gwenrich136/farkle-scoreboard/hardware/custom-footprint-references/lcd-display.png

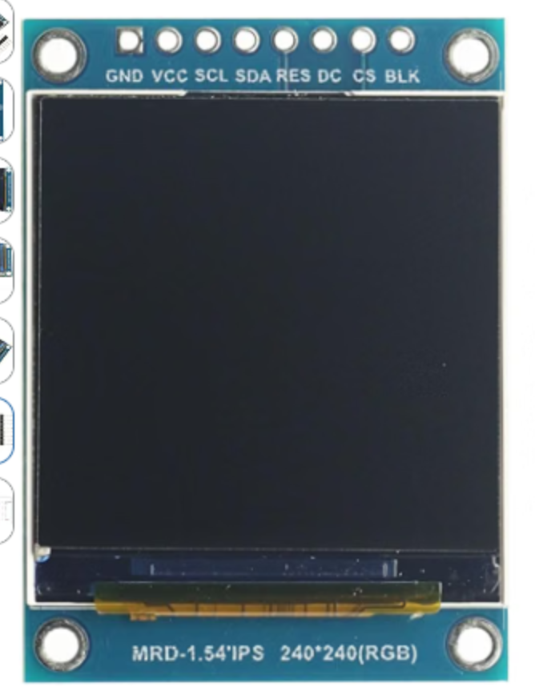
hardware/custom-footprint-references/lcd-display.png
