gwenrich136/farkle-scoreboard/hardware/custom-footprint-references/sd-card-module.png

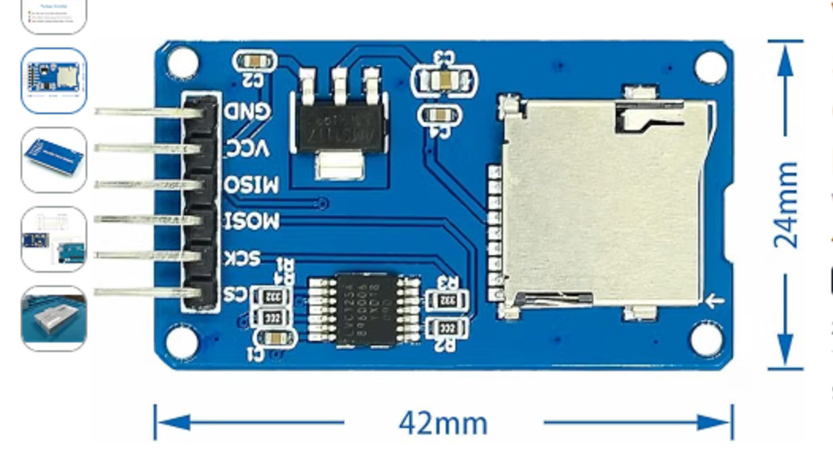
hardware/custom-footprint-references/sd-card-module.png
