gwenrich136/farkle-scoreboard/design/GENERAL_GAME_PLAY.md

> **Scope:** Defines the complete user experience and gameplay flow, from pre-game setup to post-game replays, from a player's perspective.
> **Status:** **LIVE DOCUMENT** - This file represents the current source of truth. If code changes, this document MUST be updated.

# General Gameplay and User Experience Design for Farkle Scoreboard

This document outlines the desired user experience and general gameplay flow for the Farkle Scoreboard device. It focuses on how the game should behave from the player's perspective, without delving into specific technical implementation details.

---

## 1. Pre-Game Experience

The game begins by guiding players through setup and configuration.

### 1.1 Target Score Selection
-   **Initial State:** The scoreboard asks "Target Score?". The default selection is 10,000.
-   **Navigation:** Players rotate the dial (Encoder) to increment or decrement the goal in steps of 1,000. The range is clamped between 1,000 and 20,000.
-   **Visual Feedback:** The `ScoreDisplay` segment for the "Competition Score" updates in real-time to show the currently selected target.
-   **Confirmation:** Pressing `SELECT` (Encoder Push) confirms the target score and transitions to the "Player Selection" screen.

### 1.2 Player Selection
-   **Initial State:** The scoreboard displays a "Player Selection" screen, presenting a list of pre-stored player names.
-   **Goal Persistence:** The "Competition Score" segment remains lit with the chosen target score throughout the selection process.
-   **Navigation:** Players rotate the dial (Encoder) to scroll through the available names. While scrolling, the `LedProgressGrid` visually indicates the "pending player" by blinking the rows that player would occupy with their assigned color.
-   **Selecting a Player:** Pressing the `SELECT` (Encoder Push) button on a highlighted name adds that player to the game. The player list refreshes, removing the selected player from the available list, and the system remains in the "Player Selection" state, ready for the next player.
-   **Player Limit**: Once the maximum number of players is reached (currently 8), the system stops showing a "pending" player and the ability to add more is disabled.

### 1.2 Player Creation
-   **Purpose:** Allows users to input a new player name character by character.
-   **Input Method:** The screen (via `TextDisplay`) shows the name being built. The active character is highlighted and can be changed by rotating the dial (Encoder). Players navigate through the name by pressing `+100` (Left) or `+500` (Right).
-   **Confirmation:** Pressing `BANK` confirms the new name, adds the player to the game, and returns to the "Player Selection" screen.
-   **Aborting:** Pressing `CLEAR` discards the new name and returns to the "Player Selection" screen without adding a player.

### 1.3 Starting the Game
-   **Direct Start:** From the "Player Selection" screen, pressing the `FARKLE` (Red) button immediately starts the game with the currently added players.
-   **Confirmation Flow:** From the "Player Selection" screen, pressing the `CLEAR` button initiates a confirmation step.
    -   The `TextDisplay` asks: "Start {player_count} player game?".
    -   Pressing `FARKLE` or `BANK` starts the game.
    -   Pressing `CLEAR` again cancels and returns to the "Player Selection" screen.

---

## 2. In-Game Experience

### 2.1 Player Turn Flow
-   **Turn Start:** The `TextDisplay` clearly indicates whose turn it is (e.g., "PLAYER 1'S TURN").
-   **Dice Rolling:** Players roll physical dice.
-   **Score Input:**
    -   Players use the dedicated buttons on the `ControlPad` to add points to their `at-risk` score. These buttons map to common Farkle score increments:
        -   `+50` button
        -   `+100` button
        -   `+500` button
    -   The `atRisk` score is displayed on a `ScoreDisplay` segment and as a blinking section on the `LedProgressGrid`.
    -   **Toggle View:** A physical latching switch on the device allows the current player to toggle their main score display between "Banked" (showing only their banked score) and "Pending" (showing their banked score + their current atRisk score). This allows players to easily see what their final score would be if they were to bank immediately, and it changes how the display updates during animations.
    -   **Visual Feedback Rule:** If the `atRiskScore` is 0, it is only displayed as "0" on the `ScoreDisplay` during the `WaitingPhase`. In all other phases (such as during animations in the `BankingPhase` or `FarklingPhase`), an `atRiskScore` of 0 is treated as an empty display. This helps visually distinguish between an active turn and the transition between turns.
    -   **Correction:** Pressing `CLEAR` resets the `atRisk` score to 0 for the current roll, allowing the player to re-enter their score.
    -   **Ghost Undo:** To save space and complexity, the scoreboard uses a "Ghost Undo" button. Pressing `BANK` and `CLEAR` simultaneously issues an `UNDO` command. Because both `BANK` and `CLEAR` are inert when the turn score is 0, this mapping works perfectly, allowing for a secret button combination to undo actions without adding a physical button. This action is currently defined but reserved for future implementation.

### 2.2 Score Animations
-   **Banking Animation:**
    -   When a player presses `BANK`, their `atRisk` score slowly drains to zero while their banked score simultaneously increases by the same amount. Both the `ScoreDisplay` segments and the `LedProgressGrid` animate this proportional change, with the `atRisk` portion shrinking and the banked portion growing.
    - The player's consecutive farkle count is also reset to zero at the beginning of this phase, causing the `FarkleWarningLights` to turn off immediately.
    -   **Note on Visuals:** The `LedProgressGrid` uses a logarithmic/exponential brightness curve for the "remainder" pixel. This ensures that the visual progression appears smooth and linear to the human eye, avoiding sudden jumps in brightness during these animations.
    -   Input is locked during this animation.
    -   **Manual Advance:** Once the animation completes (at-risk score is 0), the game persists in its final state, showing the updated score. The game waits until **any button** is pressed on the `ControlPad`, or automatically advances after 5 seconds of inactivity.
    -   **Transition:** Upon button press or timeout, the game advances to the next player's turn and returns to the `WaitingPhase`.
-   **Standard Farkle Animation:**
    -   If a player farkles (but it's not their third consecutive farkle), their `atRisk` score slowly drains to zero.
    -   **No Harm, No Foul Rule:** If the player's Banked Score is 0, their consecutive farkle count does **not** increment. Warning lights do not turn on. You cannot get "strikes" if you have no points to lose.
    -   A witty quip related to farkling is displayed on the `TextDisplay`.
    -   The `FarkleWarningLights` update to reflect the new farkle count (if applicable).
    -   Input is locked during this animation.
    -   **Manual Advance:** Once the animation completes, the game remains in this state (displaying the quip and updated lights) and waits for **any button** press or automatically advances after 5 seconds of inactivity.
    -   **Transition:** Upon button press or timeout, the game advances to the next player's turn and returns to the `WaitingPhase`.

### 2.3 Catastrophic Farkle (Third Consecutive Farkle)
-   **Trigger:** When a player gets their third consecutive farkle in a turn (and has points to lose).
-   **Penalty:** A player who gets a third consecutive farkle loses 1,000 points, or their entire score if it's less than 1,000.
-   **Dramatic Animation Sequence:**
    1.  **"The Pain Sets In" (approx 5 seconds):**
        *   The `TextDisplay` shows a penalty quip.
        *   The `atRisk` score display flashes the negative penalty amount (e.g., "-1000" or "-850").
        *   The `FarkleWarningLights` begin **alternating** (Yellow/Red) to signal the catastrophe.
        *   No points move yet; the user is forced to dwell on their mistake.
    2.  **The Drain:**
        *   The `atRisk` display stops flashing (becomes solid).
        *   The `atRisk` score animates upwards to 0.
        *   Simultaneously, the player's banked score drains downwards.
        *   The `FarkleWarningLights` **continue alternating** throughout this drain.
    3.  **The Aftermath:**
        *   Once the scores settle, the `FarkleWarningLights` turn **OFF**.
        *   The game waits for a button press or automatically advances after 5 seconds of inactivity.
    -   **Reset Logic:** The player's consecutive farkle count is internally reset to 0 immediately upon entering this phase, consistent with other phases. The lights alternate purely due to the phase state.

---

## 3. End-Game Experience

### 3.1 The "Last Round" Trigger
-   **Trigger Condition:** The first time any player's banked score exceeds **the Target Score**.
-   **Visual & Audio Cue:**
    -   The `ScoreDisplay` segment showing the Competition Score (leading score) begins to blink continuously.
    -   A "bell sound" plays (future implementation) to signify the final round.
-   **Game Rule:** The game does not end immediately; every other player (including the one who just crossed 10,000) gets one final turn to surpass the highest score.

### 3.2 Game End & Winner Celebration
-   **Game End:** The game concludes after all players have had their final turn. The player with the highest score is declared the winner.
-   **Celebration Sequence:**
    -   The `TextDisplay` prominently displays "{player_name} WINS!".
    -   The entire `LedProgressGrid` performs a dynamic visual celebration (e.g., flashing in the winner's color, or a "fireworks" animation).
    -   The `ScoreDisplay` segment showing the winning score flashes the winning player's final total.

---

## 4. Post-Game Experience

After the winner celebration, the device enters a continuous post-game loop.

### 4.1 Game Replay & Upload (Parallel)
-   **Visual Replay:** The `LedProgressGrid` continuously replays the game's progress, showing how each player's score advanced throughout the session.
-   **Data Upload (Background/Interactive):** Simultaneously, the scoreboard attempts to connect via Bluetooth or WiFi to a paired phone.
    -   The `TextDisplay` provides status updates (e.g., "CONNECTING...", "UPLOADING...").
    -   If the upload is successful, the `TextDisplay` indicates this.
    -   If the connection or upload fails, the `TextDisplay` presents a menu of options.

### 4.2 Post-Game Menu
-   **Access:** If the upload fails or the user wishes to perform another action, a menu is presented (using the `displaySelector` UI from pre-game).
-   **Options:** The menu includes, but is not limited to:
    1.  "Retry Upload": Re-attempts the data upload.
    2.  "Play Again": Leads to a "Reset Game?" confirmation.
-   **Navigation:** Users navigate this menu using `Up/Down` and select options with `BANK`.
-   **`LedProgressGrid` Behavior:** The `LedProgressGrid` continues its game replay animation independently while the user interacts with the `TextDisplay` menu.

### 4.3 Reset Game
-   **Confirmation:** Selecting "Play Again" or triggering a reset (e.g., via `CLEAR` from a specific context) leads to a "Reset Game?" confirmation screen.
-   **Action:** Confirming the reset returns the device to the initial "Target Score Selection" state.
