gwenrich136/farkle-scoreboard/design/HARDWARE_UPGRADE_MIGRATION_PLAN.md

# Hardware Upgrade Migration Plan

> **Scope:** Roadmap for the V1 to V2 hardware transition, featuring the ST7789 Color IPS Display and a Hybrid Input Architecture.
> **Status:** **LIVE STRATEGY** - Step 5 is DONE. Step 6 is the active target.

---

## 1. The Vision: Hardware v2 Experience

The V2 upgrade transforms the Farkle Scoreboard into a premium, color-coded interactive device.

### 1.1 The IPS Color Display (ST7789)
A 240x240 RGB IPS display replaces the monochrome OLED.
*   **Color-Coded Feedback:** Player names, turn indicators, and "at-risk" scores are rendered in the player's unique Golden Ratio hue.
*   **High-Speed SPI:** Utilizing the Uno R4's hardware SPI bus for zero-latency UI updates.

### 1.2 The "Competitor Preview" Window
The **Rotary Encoder** (infinite) allows players to cycle through competitors on the `COMPETITION_SCORE` display.
*   **Smart Selection:** Defaults to the Leader or the 2nd Place Player at the start of a turn.
*   **Press-and-Turn:** The encoder button remains digital for 100% reliability during concurrent scrolling actions.

### 1.3 Strategic Farkle Tracking (Status Strip)
The **8-LED NeoPixel Strip** provides a "Danger Map" of the table.
*   **Current Player (Flashing):** White (0), Yellow (1), Red (2+).
*   **Other Players (Solid-Dim):** Off (0), Yellow (1), Red (2+).

---

## 2. The Target State: Pin Map

To accommodate the increased pin cost of the SPI LCD while preserving hardware encapsulation, we employ a "3-Bit Digital Bus" model.

| Pin | Component | Function | Status |
| :--- | :--- | :--- | :--- |
| **D0/D1** | **MP3 Player** | **Serial1** (Hardware Audio) | Pending |
| **D2/D3** | **Encoder A/B** | **Interrupts 0/1** (Smooth Scroll) | **DONE (V2)** |
| **D4** | **Encoder SW** | **Digital Input** (SELECT Button) | **DONE (V2)** |
| **D5** | **BUS BIT 2** | **Digital Input** (3-Bit Bus) | **DONE (V2)** |
| **D6** | **BUS BIT 1** | **Digital Input** (3-Bit Bus) | **DONE (V2)** |
| **D7** | **LCD RES** | Hardware Reset for LCD | **DONE (V2)** |
| **D8** | **LCD BLK** | PWM Backlight Control | **DONE (V2)** |
| **D9** | **SD Card CS** | SPI Chip Select (Data) | Pending |
| **D10** | **MAX7219 CS** | SPI Chip Select (Displays) | **Active (V1)** |
| **D11** | **SPI COPI** | Shared Data Out (MOSI) | **Active (V1)** |
| **D12** | **SPI CIPO** | Shared Data In (MISO) | **Active (V1)** |
| **D13** | **SPI SCK** | Shared SPI Clock | **Active (V1)** |
| **A0** | **LED Grid** | NeoPixel Data (8x8) | **Active (V1)** |
| **A1** | **Status Strip** | NeoPixel Data (8-LED) | **DONE (V2)** |
| **A2** | **BUS BIT 0** | **Digital Input** (3-Bit Bus) | **DONE (V2)** |
| **A3** | **Latching Switch** | **"Total Score" Toggle** | **DONE (V2)** |
| **A4** | **LCD CS** | SPI Chip Select (LCD) | **DONE (V2)** |
| **A5** | **LCD DC** | Data/Command (LCD) | **DONE (V2)** |

---

## 3. Rationale & Trade-off Analysis

### 3.1 Why the 3-Bit Digital Bus?
*   **Constraint:** The ST7789 IPS display requires 4 dedicated pins (CS, DC, RES, BLK) beyond the SPI bus.
*   **Alternative Considered:** **Hybrid Resistor Ladder.** Rejected because the analog input proved too finicky and unreliable with the noisy power signal (even with capacitors) when trying to consolidate to a single power source.
*   **Decision:** Move to a 3-Bit Binary Digital Bus (D5, D6, A2 used as digital). This completely resolves the analog noise issues while providing 7 distinct button states, easily covering our 6 physical buttons and introducing the "Ghost Undo" capability without requiring another physical pin or button.

### 3.2 Handling Noise
*   **Challenge:** Large NeoPixel current spikes create high-frequency noise that disrupted the analog rail.
*   **Solution:** By converting the analog A2 to a pure digital input and using a digital binary bus, we inherently increase resistance to signal noise. The software implements standard digital debouncing on the combined 3-bit value.

---

## 4. Migration Steps (The "Safe Point" Approach)

### **Phase 1: Input & Display Foundation**
**Step 1: The Status Strip (A1) [DONE]**

**Step 2: The Hybrid Input Refactor [DONE] [DEFUNCT]**
*   **Note:** Since implementing the analog resistor ladder as initially planned, we have moved on to a purely digital binary encoding scheme (3-Bit Digital Bus) to eliminate finicky analog power noise. The steps below are retained for historical context.
*   **Hardware:** Build the 4-button resistor ladder on **A2** (+50, +100, +500, CLEAR). Move **BANK**, **FARKLE**, and **SELECT** (Encoder Push) to their target digital pins.
*   **Software (ControlPad):** Implement **Interrupt-Safe Encoder** rotation logic and **Analog Ladder** stability (50ms window).
*   **Software (Architecture):** Refactor the system to use the encapsulated `GameInput` struct (ButtonAction + rotationDelta) and update all `GamePhase::update()` signatures.
*   **Software (Navigation):** Migrate menu scrolling (Target Score, Player Selection) to use the Encoder.
*   **Verification:** Native tests for priority logic, stability windows, and "no-repeat" ladder logic.

**Step 3: The IPS Color Upgrade (ST7789) [DONE]**
*   **Hardware:** Connect ST7789 to SPI and Control Pins (A4, A5, D7, D8).
*   **Software:** Swap `U8G2` for `Adafruit_ST7789`. Update UI for 240x240 and color-coded text.
*   **Verification:** High-speed, color-accurate UI updates.

### **Phase 2: Navigation & Logic**
**Step 4: Strategic Navigation (Encoder A/B) [DONE]**
*   **Hardware:** Connect Encoder pulses to D2/D3.
*   **Software:** Implement `encoder.getDelta()` for Competitor Preview and menu scrolling.

**Step 5: The "Total Score" Toggle (A3) [DONE]**
*   **Software:** Implement the latching switch logic to swap between Banked and Total scores.

### **Phase 3: Persistence & Audio**
**Step 6: SD Card Storage (D9)**
*   **Hardware Requirement:** The SD Card module **MUST** natively support 5V operation. Because the Arduino Uno R4 WiFi uses 5V logic for its SPI bus, utilizing a bare 3.3V SD module will cause damage or data corruption. Ensure the module has a built-in logic level shifter.

**Step 7: MP3 Audio (D0/D1)**

---

## 5. Rollout Strategy
1.  **Iterative Updates:** `SCHEMATIC_AND_HARDWARE_GUIDE.md` updated after each step.
2.  **Safe Points:** No transition begins until the current hardware is playable and passing tests.
