gwenrich136/farkle-scoreboard/design/pcb-design/MODULAR_PCB_PROPOSAL.md

> **Scope:** Proposed set of custom PCBs, the off-the-shelf modules they host, the board-to-board interconnect, the power architecture, the certification strategy (certified PSU + pre-certified radio), and the enclosure interface for the Farkle Scoreboard.
> **Status:** **ADOPTED (SINGLE-BOARD VARIANT, SESSION 5)** - All open questions Q1–Q10 answered by Guillermo on 2026-11-01 (see §11 and `SESSION_LOG.md` Session 5). Guillermo selected the **Single Unified Main PCB** architecture (Option 1 in §10) with 72 onboard SMD `WS2812B` LEDs (in a KiCad hierarchical sheet), reusing the Uno R4 WiFi, 3× MAX7219 5-digit modules, 8-pin CS-capable ST7789 LCD, 5V microSD adapter, and DFPlayer Mini, while keeping the active protection/level-shifting ICs (`TPS2595` eFuse, `AP2112K-3.3` + `74LVC245A` LCD shifter, and `74AHCT244` 5V buffer).

# Modular & Unified PCB Architecture Proposal

## 0. TL;DR

*   **Session 5 Decision (Unified Main PCB):** Rather than splitting into 3 separate boards connected by cables, the build consolidates onto **one Single Unified Main PCB** mounted behind the front panel:
    *   **Front side:** 72 SMD `WS2812B` LEDs (64 in the 8x8 grid + 8 in the status strip, captured in a KiCad hierarchical sub-sheet), 6 PCB-mounted tactile buttons, PCB-mounted rotary encoder + latching switch, 8-pin ST7789 LCD header (`TD1`, with `CS`), and chain headers for the 3× off-the-shelf 5-digit MAX7219 score modules.
    *   **Back side:** Plug-in headers for the **Arduino Uno R4 WiFi**, **5V microSD adapter (`MC_A1`)**, and **DFPlayer Mini (`MP3-TF-16P`)**, plus SMD protection and level-shifting circuitry (`TPS2595` eFuse, `AP2112K-3.3` + `74LVC245A` LCD 3.3V shifter, `74AHCT244` 5V buffer, `1kΩ/2kΩ` DFPlayer RX divider, and 7 steering diodes).
    *   **Panel connections:** 2-pin USB-C power entry (`J_PWR`), 2-pin power rocker switch (`J_SW`), DPDT audio mute switch (`SW_MUTE`), and 2-pin speaker header (`J_SPK`).
*   *(Historical Session 1–4 Modular Proposal preserved below for reference: three custom boards `PWR`, `CORE-A`, and `PAD`.)*
*   **Phase A** keeps the Uno R4 WiFi and **today's pin map**, so firmware is unchanged.
*   **Certification boundary:** no mains, no battery design, and no radio design inside the product. Portability comes from a certified power bank docked in the enclosure (§6.1 Option A). Power comes from a UL/CE-listed USB-C adapter or certified power bank. The only radio is the Uno R4 WiFi's pre-certified module.

---

## 1. Design Principles

1.  **Stay inside the certified boundary.** Anything that is expensive to certify (AC/DC conversion, lithium cells, RF front-ends) is bought as a finished, certified product and never designed by us. See §7.
2.  **Firmware pin map is frozen in Phase A.** Every custom board is designed so the existing `ControlPad`, `ScoreDisplay`, `TextDisplayV2`, `MemoryCard`, `SoundPlayer`, `LedProgressGrid`, and `FarkleWarningLights` code runs unmodified.
3.  **Connectors are the contract.** Each board-to-board connector has one pinout, defined in §5, and it never changes between phases. That is what makes the system modular.
4.  **Repeat, don't vary.** The three score displays are one PCB design built three times and daisy-chained.
5.  **Separate the high-current LED path from logic** on every board: dedicated pours and a star point at the power input (fixes F3).
6.  **Hand-solderable or JLCPCB-assemblable.** 2-layer where possible, 0603/0805 passives, SOIC/SOT packages, no BGAs.
7.  **BOM before layout.** Every part is chosen from the fab's catalog (LCSC code, package, stock) before schematic capture, because the part sets the footprint. See `VIBE_CODING_PCB_PITFALLS.md` §1 and the A0 gate in §9.

---

## 2. Board Set

| ID | Board | Type | Contents | Layers | Est. size | Qty/unit |
|:--|:--|:--|:--|:--|:--|:--|
| **PWR** | Power entry | Custom | USB-C sink, TVS, eFuse (current limit + soft-start), power-switch input, power-good LED | 2 | ~35×25 mm | 1 |
| **CORE-A** | Compute carrier (Phase A) | Custom | Uno R4 WiFi shield: rail distribution, 3V3 LDO, level translation, LCD clock gate, microSD socket, DFPlayer socket, LED data buffers, all peripheral connectors | 2 (4 optional) | Uno footprint, ~70×55 mm | 1 |
| **SEG** | Score display | **Reuse modules** (custom optional) | MAX7221 (or MAX7219) + 5× 7-segment digits, R_SET, decoupling, IN/OUT chain connectors | 2 | ~105×35 mm for 0.56" digits | **3** |
| **PAD** | Gamepad / control pad | Custom | 6 buttons, EC11 encoder + push, latching switch, steering diodes, ESD | 2 | Set by button layout | 1 |
| GRID | 8x8 LED panel | **Buy** | WS2812B 8x8 panel (rigid PCB type) | – | 65×65 mm typ. | 1 |
| STRIP | Status strip | **Buy** | 8× WS2812B stick | – | – | 1 |
| LCD | 240x240 IPS | **Buy** | ST7789 module **with a CS pin** (fixes F1) | – | – | 1 |
| AUD | MP3 player | **Buy** | DFPlayer Mini, socketed on CORE | – | – | 1 |
| *CORE-B* | *Compute (Phase B)* | *Custom* | *ESP32-S3-WROOM-1 module-down, same connectors as CORE-A* | *4* | *~70×55 mm* | *1* |

**Why not one board?** See §10. In short: the front-panel layout isn't frozen yet. Separate boards let the enclosure move a display without re-spinning everything, and the LED current stays physically away from the logic.

---

## 3. System Topology

```mermaid
graph LR
    ADP["UL/CE USB-C adapter<br/>or certified power bank"] -- "USB-C cable" --> PWR

    subgraph Enclosure
        PWR["PWR<br/>USB-C, TVS, eFuse"]
        SWP["Power switch<br/>(panel)"] -. "EN (µA)" .-> PWR
        PWR == "J1: 5V 3A" ==> CORE

        subgraph CORE["CORE-A (Uno R4 WiFi shield)"]
            R4["Uno R4 WiFi<br/>(pre-certified radio)"]
            SDS["microSD"]
            DFP["DFPlayer"]
        end

        CORE -- "J2: SPI 5V" --> SEG1["SEG #1"] -- "chain" --> SEG2["SEG #2"] -- "chain" --> SEG3["SEG #3"]
        CORE -- "J3: SPI 3V3" --> LCD["LCD module"]
        CORE == "J4: 5V_LED + data" ==> GRID["8x8 grid"]
        CORE -- "J5: 5V_LED + data" --> STRIP["Status strip"]
        PAD["PAD"] -- "J6: 8 signals" --> CORE
        CORE -- "J7: BTL audio" --> MUTE["DPDT mute (panel)"] --> SPK["Speaker"]
    end
```

`==>` marks a high-current path.

---

## 4. Board Details

### 4.1 PWR: Power Entry
*   **Connector:** USB-C receptacle, power-only (6-pin power-only types are fine in Phase A). **5.1 kΩ Rd on CC1 and CC2, each separate** (never shared).
*   **Protection:** unidirectional 5V TVS on VBUS (e.g. SMBJ5.0A class) right at the connector.
*   **eFuse:** an integrated eFuse (candidate: TI TPS2595 / TPS25947 family) set **below the source's rating, not at it** (R4): ~2.2 A for the current Xiaomi USB-A bank (banks of this class are typically rated 5.1 V/2.4 A, so check its label), ~2.7 A for a 3 A USB-C adapter or PD bank. One resistor change. If the limit sat *above* the source's rating, the bank's own protection would trip first and the eFuse would never do its job. It provides:
    *   Current limit (F2): a firmware bug can't trip the power bank or brown out the MCU.
    *   Soft-start (F7): the downstream bulk capacitance no longer slams the source. Size the dV/dt capacitor so the ~1.3 mF downstream (PWR bulk + CORE's 1000 µF) charges at under ~1 A: a rise of ≥ 6 ms (R5).
    *   **EN pin driven by the panel power switch** (F9): the switch only carries µA, so a small illuminated or latching switch works. On PWR: EN pulled **down** with 100 kΩ (off by default), the switch closes EN to a 10 kΩ pull-up from VBUS, with 1 kΩ series + 10 nF at the EN pin and a TVS on the J8 line (R9). A short across J8 turns the unit on, which is the harmless failure.
    *   Keeping input power ≤15 W helps the product stay in the lowest power-source class under IEC 62368-1 (§7.3).
*   **Bulk:** 100–220 µF after the eFuse. The large reservoir moves to CORE next to the LED connectors.
*   **Output:** J1 (§5). Power-good LED.
*   **Optional dual-input variant (PWR-2):** a bank inlet plus a wall inlet with a priority power mux. See §6.1 Option B.
*   **Why a separate board:** the USB-C port has to sit at an enclosure wall the enclosure chooses. This keeps the ESD and hot-plug event at that wall, it's tiny and cheap, and it's the board most likely to change if the power source changes.

### 4.2 CORE-A: Compute Carrier (Uno R4 WiFi shield)
The R4 plugs into CORE-A through standard Uno headers. CORE-A does all the electrical cleanup, and **pin assignments are identical to `SCHEMATIC_AND_HARDWARE_GUIDE.md`**.

| Block | Implementation | Fixes |
|:--|:--|:--|
| **Power distribution** | J1 in → star point → (a) **5V_LED** pour to J4/J5 with **1000µF + 100nF** at the connectors; (b) **5V_SYS** to the R4 5V pin, SEG, and DFPlayer. The DFPlayer gets its own **ferrite + 100µF** branch. | F3, F11 |
| **3V3 rail** | Own LDO (e.g. AP2112K-3.3, 600mA) from 5V_SYS for LCD + microSD. Doesn't rely on the R4's 3V3 pin budget. | F6 |
| **LCD level shift + CS** | 74LVC245A powered at 3.3V (5V-tolerant inputs) translates SCK, MOSI, CS (A4), DC (A5), RES (D7), BLK (D8) down to 3.3V. With a **CS-capable LCD**, A4 drives CS directly. If the chosen LCD has *no* CS, a 74LVC1G125 gates the LCD's SCK using A4 as enable (DNP option), so it only sees its own traffic. | F1, F6 |
| **microSD** | Socket on CORE at a board edge (aligned to an enclosure slot if users swap cards). Down-shift via 74LVC125A @3.3V. **MISO up-shift + tri-state** via 74AHCT1G125 @5V, enabled by SD CS (D9), which also stops the card holding MISO when deselected. Replaces the 5V SD breakout. | Robust shared bus |
| **5V bus buffer** | One **74AHCT244** (8 channels, TTL-threshold inputs) @5V: MOSI/SCK/CS(D10) → J2 with 33 Ω series; A0 → J4 and A1 → J5 with 330 Ω series at the connector; **DFPlayer TX → D0** so the 3.3 V UART reply is a clean 5 V at the RA4M1 (whose CMOS V_IH is 0.8×VCC = 4.0 V; a bare 3.3 V signal is below spec). Six of eight channels used; two spare. TTL thresholds mean the same part accepts 3.3 V input in Phase B unchanged. (R2, R10) | F10, Phase-B ready |
| **Gamepad input** | Per J6 line, in this order from the connector inward: TVS to GND at the connector pin (two 4-channel arrays, e.g. TPD4E05U06), **10 kΩ pull-up to 5V at the connector node**, then **1 kΩ series toward the MCU pin**, then **10 nF to GND at the MCU side**. The order matters (R3): with the pull-up on the MCU side of the series resistor, a pressed line only reaches ≈0.73 V (Schottky Vf + the 1k/10k divider) against the RA4M1's V_IL of 1.0 V; with it at the connector node the pressed line sits at the diode's 0.3 V. | Noise, ESD |
| **Audio** | DFPlayer in a socket. R4 TX (D1) → DFPlayer RX through a **1 kΩ / 2 kΩ divider to 3.3 V** instead of the bare 1 kΩ series resistor, which relies on the module's input clamp (R10). DFPlayer TX → D0 via the '244 above. BTL outputs to J7. | – |
| **Back-feed guard** | Verify the R4 WiFi USB/5V-pin power path from the Arduino schematic (F8). Bench check: with the R4 unpowered, DMM in diode mode between the USB VBUS pin and the 5V header pin; a drop one way and open the other means a series diode and the PC port is safe. If it reads near 0 Ω, add an ideal-diode (or Schottky) stage on CORE so the PC USB port and PWR can't back-feed each other while programming. | F8 |
| **A4/A5 caveat** | A4/A5 are also `Wire`'s SDA/SCL on the Uno R4. Any library that calls `Wire.begin()` (RTC, sensor, the Qwiic port is on `Wire1`, so it's safe) hijacks LCD CS/DC. Guard in firmware: no `Wire` on Phase A hardware (R8). | – |

### 4.3 SEG: Score Display (×3, identical)
**Phase A: reuse what's built.** The build photo shows three off-the-shelf 5-digit MAX7219 modules that already have chain in/out headers. Mount them to the front panel and connect with J2 cables (PH-6 at CORE, 5-pin Dupont at the module; confirm the order on the module silkscreen). Build the custom SEG below only if the digit size or colour changes, or to get the MAX7221 benefits. *Note:* the digits look blue/white. Those LEDs need ~3 V forward voltage, which leaves the MAX7219 little headroom on a 5 V rail, so if brightness looks uneven between digits, that's the likely cause.

**Custom SEG (optional):**
*   **Driver:** prefer **MAX7221** over MAX7219. It's register-compatible (`ScoreDisplay` doesn't change). It has a **true SPI CS**, so it ignores LCD/SD traffic, and **slew-limited segment drivers**, which make EMC easier (§7.4). Note: many cheap MAX7219 boards use clone chips, so buy from an authorized distributor.
*   **Digits:** 5× common-cathode 7-segment digits (0.56" or 0.8" per the enclosure). R_SET chosen for the brightness wanted at intensity 12/15, not maximum, which keeps current near the typical budget.
*   **Decoupling:** 10µF electrolytic/ceramic + 100nF at V+ per chip, per the MAX7219/7221 datasheet layout guidance.
*   **Chain:** `SEG_IN` (from CORE or the previous SEG) and `SEG_OUT` (DOUT → next DIN, plus CLK/CS/5V/GND pass-through) use the **same pinout**, so the boards chain in any order. Device index = position in the chain (matches `addDisplay(type, deviceIndex)`).

### 4.4 PAD: Gamepad / Control Pad
*   **Phase A (no firmware change):** keep the 3-bit bus, done properly on the PCB:
    *   **Steering diodes** (Schottky, e.g. BAT54 series; low Vf keeps a "pressed" line well below the MCU's V_IL), one per bus line on each **multi-bit** button only: +500 2, +100 2, +50 3, so **7 total** (R1, corrects the 10 in Session 1). Single-bit buttons need none: their only shared node is GND. The diodes exist because a multi-bit button's common node ties its lines together while the switch is *open*; without them, pressing CLEAR (bit 0) pulls bits 1 and 2 low through the +50 button's common node and reads 111 = +50. (F4)
    *   Today the encoder is a KY-040-style module and the latch is a self-locking switch module. PAD replaces them with a bare EC11 and a panel self-locking switch (or keeps headers for the modules).
    *   EC11 encoder with the 10 kΩ/10nF RC filtering recommended in encoder application notes; SELECT and LATCH direct.
    *   Mounting holes for panel mount *or* a handheld shell (open question Q3).
*   **Chord aliasing (F5) can't be fixed by layout.** Options, decided with Guillermo:
    1.  **Accept it.** Rely on the 50 ms stability window and button spacing, and document the alias table.
    2.  **Re-assign codes** so the likely accidental chords (adjacent buttons) OR into **NONE-like or harmless** codes. This is a firmware + PAD change but no new parts.
    3.  **Phase B: put an I/O expander on the PAD** (e.g. TCA9555 / MCP23017 on I2C, interrupt line to MCU). Each button gets its own bit, chords are unambiguous, and **five MCU pins are freed**. ControlPad then reads the expander instead of three pins.

### 4.5 Bought Modules: Selection Rules
| Module | Must have | Avoid |
|:--|:--|:--|
| LCD | ST7789 240x240 **with CS pin broken out**, mounting holes | 1.3" no-CS variants (F1) |
| Grid | WS2812B (or SK6812) 8x8 on rigid PCB, separate 5V/GND/DIN pads, mounting holes | Flexible panels (hard to diffuse/mount) |
| Strip | 8× WS2812B stick with through-holes | – |
| DFPlayer | Genuine DFRobot DFR0299 preferred | Unbranded clones if audio noise is a problem (F11) |

---

## 5. Interconnect Specification

Signal connectors are **JST-PH (2.0 mm, keyed, locking)**. High-current connectors are **JST-VH (3.96 mm)**. Pin 1 is marked on silkscreen and in this table. GND is interleaved on SPI cables.

| Conn | From → To | Type | Pinout | Max I |
|:--|:--|:--|:--|:--|
| **J1** | PWR → CORE | VH-4 | 1 5V, 2 5V, 3 GND, 4 GND | 3 A |
| **J2** | CORE → SEG_IN; SEG_OUT → next SEG_IN | PH-6 | 1 5V, 2 GND, 3 DIN, 4 GND, 5 CLK, 6 CS | 1 A |
| **J3** | CORE → LCD | PH-8 | 1 3V3, 2 GND, 3 SCK, 4 MOSI, 5 RES, 6 DC, 7 CS, 8 BLK | 0.1 A |
| **J4** | CORE → GRID | VH-3 | 1 5V_LED, 2 DATA, 3 GND | 3 A (fused by PWR) |
| **J5** | CORE → STRIP | PH-3 | 1 5V_LED, 2 DATA, 3 GND | 0.5 A |
| **J6** | PAD → CORE | PH-10 | 1 GND, 2 BUS0, 3 BUS1, 4 BUS2, 5 SELECT, 6 ENC_A, 7 ENC_B, 8 LATCH, 9 GND, 10 **VPAD (reserved)** | – |
| **J7** | CORE → mute switch → speaker | PH-2 | 1 SPK_1, 2 SPK_2 | 0.3 A |
| **J8** | PWR ← power switch | PH-2 | 1 EN, 2 GND | µA |

*   **J6 pin 10 (VPAD)** is reserved so the Phase B I/O-expander PAD (or lit buttons) can draw power without a new connector. In Phase B, CORE-B reuses BUS0/BUS1 as SDA/SCL and BUS2 as INT. CORE-B leaves the J6 RC capacitors unpopulated (they would slow I2C edges) and pulls up to 3V3.
*   **Cable lengths:** keep J2/J3 (SPI) under ~30 cm. The MAX7221 is limited to 10 MHz, so firmware must use a separate `SPISettings` per device (the LCD can run faster).

---

## 6. Power Architecture

```mermaid
graph TD
    USB["USB-C source<br/>5V ≤3A (Type-C current)"] --> TVS["TVS"] --> EF["eFuse<br/>I_lim ≈2.5A, soft-start, EN"]
    SW["Panel switch"] -.-> EF
    EF --> STAR(("Star point<br/>on CORE"))
    STAR --> LED["5V_LED pour<br/>1000µF"] --> G["GRID"] & S["STRIP"]
    STAR --> SYS["5V_SYS"] --> R4["Uno R4"] & SEGS["SEG ×3"]
    SYS --> FB["Ferrite + 100µF"] --> DF["DFPlayer"]
    SYS --> LDO["3V3 LDO"] --> L["LCD"] & SD["microSD"]
```

**Budget rules, enforced in firmware:** the hardware limit is ~2.5 A (power-bank setting) and the firmware design budget is **≤ 2.0 A**.
*   Cap the grid plus strip at an aggregate LED current using a global brightness ceiling (e.g. `setBrightness`) **derived from a documented per-pixel estimate**. This needs a firmware design note in `COMPONENT_LIBRARIES.md` (LedProgressGrid / FarkleWarningLights).
*   Keep MAX7221 intensity at ≤12/15 (already the blink-high level).
*   **Journal integrity under brown-out (R6):** the hardware limits the current, but a power-bank auto-off or a yanked cable still cuts power mid-write. `MemoryCard`'s fixed-width journal records should each carry a CRC (or a sequence + checksum byte), and recovery should drop a torn last record rather than trust it. Firmware design note for `MEMORY_FILE_TREE.md`. In Phase B the eFuse's fault/PG output goes to a pin for a power-fail warning; Phase A has no pin free.
*   Optional (Phase B, needs a pin or ADC): PWR exposes CC voltage so firmware can tell a 1.5 A source from a 3 A source and dim accordingly. **This doesn't work with USB-A power banks:** an A-to-C cable always advertises default USB current, whatever the bank can actually deliver. (It works again with a USB-C PD bank on a C-to-C cable; see §6.1.)

### 6.1 Portable Power Options

Portability is a likely want (Q10). The rule from §1 still holds: **the battery must be a certified, self-contained product** (cells, protection, charger, and boost all inside one listed unit). We never design a charger or pick bare cells.

| Option | What it is | Battery cert burden on us | Verdict |
|:--|:--|:--|:--|
| **A. Docked power bank** | A certified USB-C PD power bank sits in a bay inside (or clipped to) the enclosure. A short C-to-C cable runs to PWR. It comes out for charging and swaps for a fresh one. The same PWR inlet also takes a wall adapter. | **None.** The bank carries its own UL 2056 / IEC 62133-2 / UN38.3 / FCC / CE. | **Recommended** |
| **B. Docked bank + wall input (PWR-2)** | Option A plus a second panel USB-C "wall" inlet. PWR-2 uses a priority power mux (candidate: TI TPS2121), so plugging into the wall takes over seamlessly and the bank sits idle. A panel-mount USB-C extension can route to the bank's charge input so it charges in place. | **None.** We switch between two certified sources and charge nothing ourselves. | Upgrade if "play while plugged in" matters. Avoids relying on the bank's pass-through charging, which on many banks briefly drops the output and would **reset the MCU mid-game**. |
| C. Certified pack + our charger/boost | A UL 2054 / IEC 62133-2 pack (cells + protection only) with our own 1S charger and a 5 V/3 A boost on PWR. | **High.** Charger and boost design falls under IEC 62368-1 Annex M battery safety, and the boost needs ~4 A from the cell at low charge. | Not recommended. It breaks the §1 boundary. |
| D. Bare 18650s / uncertified "power bank modules" | Loose cells in holders, or IP53xx-style power-bank boards from marketplaces. | Uncertified | **Rejected** (safety). |

**Bank requirements for A/B:**
*   A **USB-C PD** output that delivers **5 V/3 A** (any 20 W+ PD bank). Unlike the current USB-A bank, it advertises 3 A over CC, so the CC-sensing idea in §6 works again.
*   **Certification marks:** UL 2056 (or IEC 62133-2 cells), UN38.3, FCC, and CE. Buy a major brand from a first-party store; marketplace listings are often counterfeit.
*   **10,000 mAh or more.**
*   A known low-current auto-off threshold. The scoreboard idles well above it today, but a future sleep mode could drop below it.

**Runtime estimate** (assumes 3.7 V nominal and ~85 % conversion efficiency):

| Bank | Usable energy | Typical play (~1.5 A, 7.5 W) | At firmware cap (2.0 A, 10 W) |
|:--|:--|:--|:--|
| 10,000 mAh | ~31 Wh | **~4 h** | ~3 h |
| 20,000 mAh | ~63 Wh | **~8 h** | ~6 h |

A Farkle game runs about 30–60 min, so a 10,000 mAh bank covers an evening. Keep the bank under 100 Wh (27,000 mAh) to stay inside airline carry-on limits.

**Enclosure implications:**
*   Design the bay around **one named bank model**, with foam or a strap for tolerance.
*   Put the bank **away from the LED grid's heat**, with a vent.
*   The bank's own charge LEDs are the only fuel gauge, because a 5 V regulated output carries no state-of-charge information. Add a light-pipe or window to them.
*   Keep the bank **removable** so an aging or swollen Li-ion pack can be swapped without opening the electronics.

---

## 7. Certification Strategy

> Assumption: "UE certified" in the brief means **UL (North-America safety) + CE (EU)**, with FCC as the US radio/EMC equivalent.
>
> **Q1 answered (2026-10-16): personal build, not for sale.** §7.1 applies, so nothing below is mandatory. We still follow §7.2–7.4 as a design-for goal: a certified adapter and pre-certified radio cost little, they're good engineering anyway, and they keep a future sale possible.

### 7.1 If the scoreboard is never sold
47 CFR §15.23 allows home-built devices in small quantities (not marketed) without FCC authorization, provided they don't cause interference. None of §7.2–7.4 is required, though the design still follows it so a later sale stays possible.

### 7.2 Power: use a certified PSU, design none
*   Ship with (or specify) a **USB-C wall adapter** that carries **UL/ETL listing to UL 62368-1, CE + UKCA marks, and DoE Level VI** efficiency. 5V/3A (15 W) or more. Any USB-PD adapter supplies 5V/3A without negotiation.
*   Power banks: only branded units with their own UL 2056 / IEC 62133 certification.
*   **No battery design of our own.** Bare cells or our own charger would bring UN38.3 (shipping), IEC 62133-2, and charger design into scope. For portability, a **certified power bank docked in the enclosure** keeps all of that with the bank maker (§6.1).
*   With only 5V DC inside, the product sits below the Low Voltage Directive range (75 V DC). Electrical-safety risk lives in the adapter, which is already certified.

### 7.3 Product safety (still ours)
*   IEC/UL 62368-1 still applies to the finished product (under CE it comes via RED Art. 3.1(a) if a radio is present). Limiting input to **≤15 W** with the eFuse keeps the boards in the lowest power-source class, which relaxes enclosure fire-rating requirements. Confirm with the test lab.
*   Use **UL 94 V-0 or V-1** enclosure material if possible (PETG/ABS FR grades; standard PLA is not rated).

### 7.4 Wireless: pre-certified module only
*   **Phase A:** the Uno R4 WiFi's onboard ESP32-S3-MINI-1 module is the only radio. Don't modify the R4, and keep its antenna end clear (§8).
*   **Phase B:** use **ESP32-S3-WROOM-1** (PCB antenna) placed directly on CORE-B. To reuse Espressif's modular grant:
    *   Follow Espressif's hardware design guidelines for **antenna keep-out**: no copper on any layer under or around the antenna, and the antenna at the board edge.
    *   Use only the antenna the module was certified with (avoid `-1U` external-antenna variants unless using a listed antenna).
    *   Label the product **"Contains FCC ID: …"** with the module's grant ID, and the IC equivalent.
*   **What the module does *not* cover:** the *whole product* still needs:
    *   **US:** FCC Part 15 **Subpart B** (unintentional radiator) via Supplier's Declaration of Conformity. This is a pre-scan/test of the digital emissions from MAX72xx multiplexing, WS2812 data, and SPI.
    *   **EU:** the **Radio Equipment Directive** (because a radio is present, even if WiFi is unused). That means EMC (EN 301 489-1/-17), radio (EN 300 328, usually satisfied by the module's reports), safety (EN 62368-1), RF exposure (EN 62479), plus RoHS and WEEE.
    *   **Design lever:** if WiFi stats upload isn't a real requirement (Q5), a **non-radio MCU in Phase B** drops RED and leaves the simpler EMC Directive.
*   **EMC design practices baked into this proposal:** a solid ground plane on every board, MAX7221 slew-limited drivers, series resistors on all off-board clocks and data, TVS at every user-touchable connector, LED current kept off the logic ground, and short SPI cables.

---

## 8. Enclosure Interface

| Area | Requirement |
|:--|:--|
| **Front panel** | SEG ×3, GRID, LCD, STRIP (and PAD if integrated) mount **to the front panel** on M3 standoffs. Boards define their own hole patterns. Keep all board outlines on a 2.5 mm grid with M3 holes ≥3 mm from the edge. |
| **Rear / base** | CORE and PWR mount to the base. PWR sits **against a wall** so the USB-C receptacle is flush with a panel cut-out (no USB pigtails). |
| **Panel controls** | Power switch (J8), mute DPDT (J7), latching "Total" switch (on PAD). |
| **Service access** | Game-data microSD slot reachable through an enclosure slot *or* behind a screw panel (Q6). DFPlayer audio card is internal. USB for firmware updates reachable (Phase A: the R4's USB-C, Phase B: CORE-B native USB). |
| **Antenna keep-out** | Radio module antenna ≥15 mm from metal, screws, the LED grid, and the speaker magnet, facing an enclosure wall. **No metal enclosure.** |
| **Optics** | Grid: printed baffle (one cell per pixel) + diffuser. 7-seg: smoked/red acrylic filter. LCD: window with bezel overlap. |
| **Thermal** | Worst case ~15 W in, mostly as LED heat on the front panel. Passive is fine, and small vents above the grid are recommended. |
| **Acoustic** | Speaker grille + sealed back volume for the 36 mm driver. |
| **ESD** | Plastic enclosure; buttons with plastic caps; TVS on PAD lines (CORE §4.2). |

---

## 9. Phasing

| Phase | Deliverable | Firmware impact | Gate to next phase |
|:--|:--|:--|:--|
| **A0** | Fab chosen; **every BOM line selected from the fab's catalog** (LCSC, package, stock); footprint library built from those parts; enclosure hands over outlines, holes, connector edges and max heights | None | `VIBE_CODING_PCB_PITFALLS.md` checklist "A0 → A1" complete |
| **A1** | PWR + CORE-A schematics and layout; review doc per revision; order with the bought modules | None | Checklist "A1 → order" complete; board bring-up: all existing tests pass and all subsystems are verified on hardware |
| **A2** | PAD (+ custom SEG only if wanted) | None (MAX7221 is drop-in) | Full game played on PCBs only, no hand wiring |
| **A3** | Enclosure v1 around the A-boards | LED current-cap design note | Thermal and brightness OK; no LCD corruption over a full game |
| **B** *(optional)* | CORE-B (ESP32-S3-WROOM-1) and/or PAD with I/O expander | Port to `esp32` platform; ControlPad reads expander | Decide based on Q2, Q5, and pin needs |
| **C** *(volume only)* | Merge SEG ×3 + GRID + STRIP into one front-panel board | None | Front layout frozen |

---

## 10. Selected Architecture: Single Unified Main PCB (vs. Modular)

One large front-panel PCB with all displays, 72 SMD LEDs, and buttons on the front, and the compute/storage/audio modules plugged into headers on the back.

| | Single board (Selected in Session 5) | Modular (Sessions 1–4 proposal) |
|:--|:--|:--|
| Harness | None (only 2-pin power entry + speaker leads) | 8 short keyed cables |
| Unit cost at volume | Lower | Slightly higher (connectors) |
| Prototype cost per re-spin | High (large board) | Low (only the changed board) |
| Enclosure freedom | Locked to PCB | Displays placed independently |
| Noise isolation | Needs careful partitioning (`5V_LED` vs `5V_SYS` star point) | Physical separation by default |
| Compute upgrade | Full re-spin | Swap CORE only |

**Session 5 Decision:** Guillermo selected the **Single Unified Main PCB** (matching the approach started in `FarkleScorekeeper.kicad_sch`) to eliminate internal multi-board wiring harnesses, while keeping the `5V_LED` vs. `5V_SYS` star distribution, `TPS2595` eFuse, `AP2112K-3.3` + `74LVC245A` LCD 3.3V level shifter, and `74AHCT244` 5V buffer on the unified board.

### 10.1 Unified Main PCB Complete Schematic & Component Reference (`hardware/kicad/FarkleScorekeeper/`)

The complete schematic is captured in `hardware/kicad/FarkleScorekeeper/FarkleScorekeeper.kicad_sch` (main sheet) and `hardware/kicad/FarkleScorekeeper/LedGrid_StatusStrip.kicad_sch` (hierarchical sub-sheet), verified to **0 ERC errors and 0 warnings** in KiCad 10.

#### 1. Compute & Storage (`FarkleScorekeeper.kicad_sch`)
| Ref | Part / Value | Role & Pin / Net Wiring |
|:--|:---|:--|
| **`J1`–`J4`** | Arduino Uno R4 WiFi Headers | **`J1` (Power):** `+5V`, `+3V3`, `GND` (`Pin 6`, `Pin 7`).<br>**`J2` (Analog):** `A0` (LED Grid), `A1` (Status Strip), `A2` (Button Bus Bit 0), `A3` (Latching Switch), `SDA/A4` (LCD CS), `SCL/A5` (LCD DC).<br>**`J3` (Digital High):** `8` (LCD BLK), `*9` (SD CS), `*10` (MAX7219 CS), `*11` (SPI MOSI), `12` (SPI MISO), `13` (SPI SCK), `GND`.<br>**`J4` (Digital Low):** `RX/0` (MP3 TX), `TX/1` (MP3 RX), `2`/`*3` (Encoder A/B), `4` (Encoder Push/Select), `*5` (Button Bus Bit 2), `*6` (Button Bus Bit 1), `7` (LCD RES). |
| **`MC_A1`** | `MemoryCard_Adapter` (5V-native microSD) | `VCC` → `+5V`, `GND` → `GND`, `CS` → `*9`, `MOSI` → `*11`, `MISO` → `12`, `SCK` → `13`. |

#### 2. Power Entry, Protection & Decoupling (`FarkleScorekeeper.kicad_sch`)
| Ref | Part / Value | Role & Pin / Net Wiring |
|:--|:---|:--|
| **`J_PWR`** | `Conn_01x02` (`USB_C_5V_IN`) | 2-pin 5.08mm PCB screw terminal block (`TerminalBlock_Phoenix_MKDS-1,5-2-5.08_1x02_P5.08mm_Horizontal`) for raw wires from the USB-C breakout / docked power bank (`VBUS_IN`, `GND`). |
| **`J_SW`** | `Conn_01x02` (`PWR_SWITCH`) | 2-pin 5.08mm PCB screw terminal block to the panel-mounted SPST power rocker switch ([ProtoSupplies Miniature Rocker Switch SPST](https://protosupplies.com/product/miniature-rocker-switch-spst/)); switches the low-current (µA) eFuse `EN` line. |
| **`D_TVS1`** | `SMBJ5.0A` (`D_SMB`) | Unidirectional 5V TVS protection diode across `VBUS_IN` and `GND` for ESD / hot-plug spikes. |
| **`U_EFUSE1`** | `TPS2595` eFuse (`WSON-8 2x2mm`) | `VIN` ← `VBUS_IN`, `VOUT` → `+5V` rail, `GND` → `GND`, `FLT` → unconnected (no-connect). |
| **`C_IN1`** | `100nF` | Input decoupling capacitor on `VBUS_IN` next to `U_EFUSE1`. |
| **`R_EN1`, `R_EN2`** | `10kΩ`, `100kΩ` | `R_EN1` pulls `J_SW` Pin 1 to `VBUS_IN`; `R_EN2` pulls `U_EFUSE1` `EN` (`J_SW` Pin 2) to `GND` (defaults OFF when switch is open). |
| **`R_ILIM1`** | `22kΩ` | Programs `U_EFUSE1` over-current limit (`ILIM` to `GND`) to ~2.2A–2.5A. |
| **`C_DVDT1`** | `10nF` | Programs `U_EFUSE1` soft-start ramp time (`DVDT` to `GND`, ≥6 ms) to prevent `1000µF` inrush trips. |
| **`C1`** | `1000µF` Electrolytic | Main bulk reservoir capacitor across `+5V` and `GND` for LED current transients. |
| **`C2`, `C3`** | `100nF` Ceramic | Local high-frequency decoupling capacitors across `+5V`/`GND` and on `A2`/`GND` (Issue #80 filter). |

#### 3. 3.3V LCD Level-Shifter & TextDisplay (`FarkleScorekeeper.kicad_sch`)
| Ref | Part / Value | Role & Pin / Net Wiring |
|:--|:---|:--|
| **`U_LDO1`** | `AP2112K-3.3` | Dedicated 600 mA 3.3V LDO regulator (`VIN` & `EN` ← `+5V`, `VOUT` → `+3V3_LCD`, `GND` → `GND`). |
| **`C_LDO_IN`, `C_LDO_OUT`** | `1µF` Ceramic | Input and output stability capacitors for `U_LDO1`. |
| **`U_LVL1`** | `74LVC245A` | Octal 5V-to-3.3V level shifter (`VCC` ← `+3V3_LCD`, `DIR` ← `+3V3_LCD` for A→B, `OE_N` ← `GND`).<br>**Inputs (`A1`–`A6`):** `13` (`SCK`), `*11` (`MOSI`), `7` (`RES`), `SCL/A5` (`DC`), `SDA/A4` (`CS`), `8` (`BLK`). Unused `A7`, `A8` tied to `GND`.<br>**Outputs (`B1`–`B6`):** `LCD_SCL_3V3`, `LCD_SDA_3V3`, `LCD_RES_3V3`, `LCD_DC_3V3`, `LCD_CS_3V3`, `LCD_BLK_3V3`. |
| **`C_LVL1`** | `100nF` Ceramic | Local decoupling capacitor for `U_LVL1` (`+3V3_LCD` to `GND`). |
| **`TD1`** | `TextDisplay` (8-pin ST7789 240×240 LCD) | Powered by `+3V3_LCD` and `GND`; receives the 6 level-shifted 3.3V signals (`SCL`, `SDA`, `RES`, `DC`, `CS`, `BLK`) from `U_LVL1`. |

#### 4. 5V Signal Buffer & 3× Score Displays (`FarkleScorekeeper.kicad_sch`)
| Ref | Part / Value | Role & Pin / Net Wiring |
|:--|:---|:--|
| **`U_BUF1`** | `74AHCT244` | Octal 5V line driver / TTL-threshold up-shifter (`VCC` ← `+5V`, `1OE_N` & `2OE_N` ← `GND`).<br>• **`1A1`–`1A3` → `1Y1`–`1Y3`:** Buffers `*11`, `*10`, `13` → `MAX_DIN_5V`, `MAX_CS_5V`, `MAX_CLK_5V`.<br>• **`1A4`, `2A1` → `1Y4`, `2Y1`:** Buffers `A0`, `A1` → `LED_GRID_RAW`, `LED_STRIP_RAW`.<br>• **`2A2` → `2Y2`:** Shifts `MP3_TX_3V3` (3.3V from DFPlayer) up to a clean 5.0V for Arduino `RX/0`.<br>• Unused `2A3`, `2A4` tied to `GND`. |
| **`C_BUF1`** | `100nF` Ceramic | Local decoupling capacitor for `U_BUF1` (`+5V` to `GND`). |
| **`AtRiskScore`, `Banked`, `Opposition`** | `MAX2719_Adapter` (×3) | Powered by `+5V` and `GND`. `AtRiskScore` receives buffered `MAX_DIN_5V`, `MAX_CS_5V`, `MAX_CLK_5V`, and daisy-chains `D_OUT`/`CS_OUT`/`CLK_OUT` → `Banked` → `Opposition`. |

#### 5. Audio Subsystem: DFPlayer Mini, Mute Switch & Speaker (`FarkleScorekeeper.kicad_sch`)
| Ref | Part / Value | Role & Pin / Net Wiring |
|:--|:---|:--|
| **`U_MP3`** | `MP3-TF-16P` (DFPlayer Mini) | Powered by filtered `+5V_AUDIO` and `GND` (both pins 7 and 10). `RX` ← `MP3_RX_3V3`, `TX` → `MP3_TX_3V3`, `SPK_1`/`SPK_2` → `SW_MUTE`. |
| **`R_RX1`, `R_RX2`** | `1kΩ`, `2kΩ` | Voltage divider stepping Arduino 5V `TX/1` down to 3.3V (`MP3_RX_3V3`) for `U_MP3` Pin 2 (`RX`). |
| **`FB1`** | `600R@100MHz` Ferrite Bead | Isolates `+5V_AUDIO` from `+5V` LED switching noise (Finding F11). |
| **`C_MP3_BULK`, `C_MP3_DEC`** | `100µF`, `100nF` | Local power filtering on `+5V_AUDIO` right at `U_MP3`. |
| **`SW_MUTE`** | `SW_DPDT_x2` (`E-Switch EG2219`) | Right-angle PCB-mount DPDT slide switch (`Button_Switch_THT:SW_E-Switch_EG2219_DPDT_Angled`) placed at the board edge, disconnecting both `SPK_1` and `SPK_2` differential speaker lines. |
| **`J_SPK`** | `Conn_01x02` (`SPEAKER_8R`) | 2-pin 5.08mm PCB screw terminal block (`TerminalBlock_Phoenix_MKDS-1,5-2-5.08_1x02_P5.08mm_Horizontal`) for the raw 8Ω 0.5W speaker wires after `SW_MUTE`. |

#### 6. Control Pad: Buttons, Steering Diodes & Rotary Encoder (`FarkleScorekeeper.kicad_sch`)
| Ref | Part / Value | Role & Pin / Net Wiring |
|:--|:---|:--|
| **`RotaryEncoder`** | Bare `EC11` Encoder (`Alps EC11E` / `Bourns PEC11R`) | Direct PCB-mount 20-detent rotary encoder with push switch (`RotaryEncoder_Alps_EC11E-Switch_Vertical_H20mm`). `A` → `2`, `B` → `*3`, `S1` (push button) → `4`, `C`, `S2` & `MP` (shield) → `GND`. |
| **`R_ENC1`, `R_ENC2`** | `10kΩ` (`0603`) | Pull-up resistors from `2` (`A`) and `*3` (`B`) to `+5V`, matching the `KY-040` module circuit so zero firmware changes are needed. |
| **`SW2`** | `SW_DPDT_x2` (`E-Switch 100DP1T1B1M2QE`) | PCB-mount miniature bat toggle switch (`ON-ON`, through-hole PC pins, `CustomKiCadLibrary:SW_Toggle_DPDT_PC_Pin_E-Switch_100DP1`) for the "Total Score" display toggle (`Pin 2` → `A3`, `Pin 3` → `GND`). |
| **`BANK`, `FARKLE`, `CLEAR`** | `SW_Push` (`Button_Switch_THT:SW_PUSH-12mm`) | 12×12mm tactile pushbuttons with colored caps ([ProtoSupplies 12mm Tactile](https://protosupplies.com/product/tactile-momentary-pushbutton-green-12mm/)), pulling `*5` (`100`), `*6` (`010`), and `A2` (`001`) directly to `GND`. |
| **`+50`** | `SW_Push` (`SW_PUSH-12mm`) | Multi-bit 12mm button (`111`) pulling `*5`, `*6`, and `A2` to `GND` via 3 steering diodes (`D5`, `D6`, `D7`). |
| **`+100`** | `SW_Push` (`SW_PUSH-12mm`) | Multi-bit 12mm button (`110`) pulling `*5` and `*6` to `GND` via 2 steering diodes (`D3`, `D4`). |
| **`+500`** | `SW_Push` (`SW_PUSH-12mm`) | Multi-bit 12mm button (`011`) pulling `*6` and `A2` to `GND` via 2 steering diodes (`D1`, `D2`). |
| **`D1`–`D7`** | `1N5819` Schottky Diodes (`SOD-123`) | Isolate the 3-bit button bus lines (`*5`, `*6`, `A2`) so unpressed multi-bit buttons do not short bus lines together (Finding F4 / Review R1). |

#### 7. WS2812B LEDs & Serpentine Hierarchical Sub-Sheet (`LedGrid_StatusStrip.kicad_sch`)
| Ref | Part / Value | Role & Pin / Net Wiring |
|:--|:---|:--|
| **`R1`, `R2`** | `330Ω` (`0603`, on main sheet) | Series data-line protection resistors between `U_BUF1` (`LED_GRID_RAW`, `LED_STRIP_RAW`) and hierarchical ports `GRID_DIN`, `STRIP_DIN`. |
| **`LED1`–`LED64`** | `WS2812B` 5050 SMD LEDs (`5.0×5.0mm PLCC4`) | 8×8 progress grid (`LED_SMD:LED_WS2812B_PLCC4_5.0x5.0mm_P3.2mm`) arranged in a **serpentine ("snake") chain** matching `LedProgressGrid::get_pixel_index(row, col)`:<br>• **Even rows (`Row 0, 2, 4, 6`):** Flow **Right-to-Left** (`Col 7` → `Col 0`; `LED1` enters at `R0,C7` and exits `LED8` at `R0,C0`).<br>• **Odd rows (`Row 1, 3, 5, 7`):** Flow **Left-to-Right** (`Col 0` → `Col 7`; `LED9` enters at `R1,C0` and exits `LED16` at `R1,C7`). |
| **`LED65`–`LED72`** | `WS2812B` 5050 SMD LEDs (`5.0×5.0mm PLCC4`) | 8-LED status strip powered by `+5V` and `GND`; `LED65` `DIN` ← `STRIP_DIN`, daisy-chained `DOUT` → `DIN` through `LED72`. |
| **`C_LED1`–`C_LED9`** | `100nF` Ceramic (`0603`, ×9) | Local high-frequency decoupling capacitors across `+5V` and `GND` for each row of 8 `WS2812B` LEDs. |

---

## 11. Open Questions — All Resolved (Session 5, 2026-11-01)

1.  **Q1, Goal:** **Answered (2026-10-16):** Personal build. Certification is a design-for goal, not a gate (§7).
2.  **Q2, Compute:** **Answered (2026-11-01):** Keep the **Arduino Uno R4 WiFi** plugged into headers on the PCB (Phase A only; zero firmware changes).
3.  **Q3, Gamepad form:** **Answered (2026-11-01):** Integrated into the main scoreboard front panel on the Single Unified Main PCB.
4.  **Q4, Current wiring:** **Answered (2026-11-01):**
    *   Multi-bit buttons are isolated with **7 steering diodes** (`D1`–`D7` in `FarkleScorekeeper.kicad_sch`).
    *   The ST7789 LCD was upgraded to an **8-pin module that includes a `CS` pin** (`TD1` in `FarkleScorekeeper.kicad_sch`), eliminating Finding F1 and the need for a `74LVC1G125` clock gate.
5.  **Q5, WiFi:** **Answered (2026-11-01):** Covered by keeping the Uno R4 WiFi (Phase A).
6.  **Q6, SD access:** **Answered (2026-11-01):** **Internal-only** (set and forget inside the enclosure; reuses the 5V-native `MemoryCard_Adapter` module `MC_A1`, so discrete SD level-shifter ICs are not required).
7.  **Q7, Sizes & Parts:** **Answered (2026-11-01):**
    *   Reuse the **3× off-the-shelf 5-digit MAX7219 display modules** (`MAX2719_Adapter`).
    *   Place **72 individual SMD `WS2812B` LEDs** (64 for the 8x8 grid + 8 for the status strip) directly on the PCB using a KiCad hierarchical sheet.
    *   Use **PCB-mounted tactile switches**, PCB-mounted rotary encoder, and PCB-mounted DPDT latching switch.
8.  **Q8, Fab:** **Answered (2026-11-01):** **JLCPCB / PCBWay SMD assembly** for the 72 SMD LEDs, passives, diodes, and active ICs (`TPS2595`, `AP2112K-3.3`, `74LVC245A`, `74AHCT244`); hand-solder through-hole headers and switches.
9.  **Q9, Chord aliasing:** **Answered (2026-11-01):** **Accept as-is** (rely on physical button spacing + 50 ms debounce window).
10. **Q10, Portability:** **Answered (2026-11-01):** **Option A (§6.1)** — single USB-C power input (docked USB-C power bank or wall adapter) routed through the panel power switch.

---

## 12. Proposed Repo Additions (once agreed)

*   `hardware/kicad/<board>/`: one KiCad project per board (PWR, CORE-A, PAD; SEG if built) with shared symbol/footprint library `hardware/kicad/lib/` **built from the selected parts**.
*   `hardware/kicad/<board>/bom.csv`: the fab-ready BOM (Ref, Value, Package, MPN, LCSC, Basic/Extended, stock at selection, datasheet URL). **Written in A0, before the schematic**, and the export tool refuses a line without an LCSC code.
*   `hardware/kicad/<board>/REVIEW_v0.x.md`: one review doc per revision, with "checked and left alone" as well as findings.
*   `hardware/enclosure/`: CAD source + STLs.
*   `design/pcb-design/`: this folder stays the live spec. `SCHEMATIC_AND_HARDWARE_GUIDE.md` becomes "harness and connector guide" once hand wiring is retired.
