gwenrich136/farkle-scoreboard/design/TECHNICAL_DESIGN_GAME_STATE_MACHINE.md

> **Scope:** Details the C++ architecture of the state machine, including the "Object Pool" pattern and class hierarchies. Specific implementation plans for game phases are split into category-specific documents.
> **Status:** **LIVE DOCUMENT** - This file represents the current source of truth. If code changes, this document MUST be updated.

# Technical Design: Game State Machine

## 1. Problem Statement

The Farkle Scoreboard requires a formal system to manage the flow of the game. As the game's complexity grows with different user interactions (pre-game setup, in-game scoring, animations, post-game replays), an ad-hoc approach using simple `if/else` blocks or flags in the main loop will become unmanageable, bug-prone, and difficult to extend.

This document specifies a robust and scalable state machine architecture that provides a clear structure for game logic, ensures state transitions are handled safely, and allows for new features and game phases to be added in a clean, modular way.

## 2. Feature Description

This feature implements the central "brain" of the game, managing its state and flow. The game logic is divided into three broad categories of phases:

1.  **[Pre-Game Phases](PRE_GAME_PHASES.md):** Handle game initialization, player setup, and menu systems.
2.  **[In-Game Phases](IN_GAME_PHASES.md):** Manage the core gameplay loop, including player turns, score entry, and animations.
3.  **[Post-Game Phases](POST_GAME_PHASES.md):** Handle the end-of-game experience, displaying results and options to restart.

For the initial V1 implementation, the state machine manages a simplified flow where the game starts immediately with hardcoded players, proceeds through waiting and animation phases, and ends when a player reaches the target score.

All animations are time-based, ensuring a smooth and consistent user experience regardless of processor load.

## 3. Technical Discussion

This section details the architectural decisions, alternatives considered, and final design choices for the state machine implementation.

### 3.1 Core Architecture: The "Object Pool" State Pattern

After considering multiple alternatives, we have chosen to implement the **State Design Pattern** using an **Object Pool**.

*   **Description:** This pattern involves defining an abstract base class (`GamePhase`) and a concrete child class for each state (`WaitingPhase`, `BankingPhase`, etc.). A main `Game` class holds a pointer to the `currentPhase`. Instead of dynamically creating (`new`) and destroying (`delete`) phase objects on each transition, we will pre-allocate one instance of every phase object at startup and store them in a "pool". State transitions are achieved by changing the `currentPhase` pointer to refer to a different object in the pool.
*   **Pros:**
    *   **Excellent Encapsulation:** All logic for a specific phase is contained entirely within its class.
    *   **High Scalability:** Adding a new game state is as simple as creating a new class, with minimal changes to existing code.
    *   **Memory Safe:** By pre-allocating all objects, we completely avoid dynamic memory allocation in the main loop, eliminating the risk of heap fragmentation during gameplay.
*   **Cons:**
    *   **Higher Upfront Memory:** All phase objects exist in memory for the lifetime of the application.
    *   **More Boilerplate:** Requires more initial setup (defining base classes, child classes, the pool) than simpler alternatives.

### 3.2 Alternative 1: `enum` with `switch` statement

*   **Description:** A single `enum` (`GamePhases`) would define the possible states. The main loop would contain a large `switch(currentPhase)` statement, with a `case` for each state containing its logic.
*   **Reason for Rejection:** While simple for V1, this approach scales poorly. The main loop function becomes a monolithic block of code that is difficult to read, maintain, and extend as the game's complexity grows towards our long-term vision.

### 3.3 Alternative 2: Dynamic State Pattern

*   **Description:** A classic implementation of the State pattern where a new phase object is created with `new` and the old one is destroyed with `delete` upon every state transition.
*   **Reason for Rejection:** While offering the same encapsulation benefits, the frequent calls to `new`/`delete` introduce the risk of heap fragmentation. In a long-running embedded application with future large-memory features (WiFi, SD card), this risk was deemed unacceptable.

### 3.4 Key Design Decisions

*   **Central `Game` Class:** We will use a main `Game` class to act as the central 'Context' for the state machine. It will own all game data (`GameState`), the pool of phase objects, and the hardware components, while the `GamePhase` classes will encapsulate the actual game logic. This improves organization, reduces the risk of unintended side-effects, and enhances testability for our long-term vision. The minor upfront effort of creating the class is outweighed by these benefits.
*   **Time-Based Animation Logic:** Animations will be driven by time elapsed (`deltaTime`) rather than by processor ticks. This ensures animations remain smooth.
    *   **Mechanism:** The main `Game::loop()` will calculate `deltaTime` on each frame and pass it to the `update()` method. Animation phases (like `BankingPhase`) will contain a floating-point `accumulator` variable. On each update, this accumulator is increased by `(SCORE_ANIMATION_SPEED * deltaTime)`. The integer portion of the accumulator is then moved from the `atRiskScore` to the `bankedScore`. This handles the conversion from a time-based float to integer-based scores cleanly. The edge case where `pointsToMove` exceeds `atRiskScore` will be handled by taking the minimum of the two.
*   **Phase-Local State Management and `onEnter()`:** The Object Pool pattern means phase objects are reused, not recreated. Therefore, any internal state they hold (like the animation accumulator) must be reset upon entry.
    *   **Discussion:** An alternative was considered where a common timestamp (`lastUpdateTime`) could be stored in the global `GameState`). However, this breaks down for state that is truly local to a phase (e.g., `scoreMoveAccumulator` is meaningless to `WaitingPhase`). Storing such state in `GameState` would break encapsulation and lead to state-reset bugs.
    *   **Decision:** Each phase is responsible for its own internal state. The `GamePhase` interface *must* include an `onEnter()` method. This method is called by the main `Game` engine immediately after a state transition, providing a clean entry point for each phase to reset its internal variables (e.g., `this->scoreMoveAccumulator = 0.0f;`).
*   **Inheritance Hierarchy:** To prepare for future scalability, we will implement a multi-layer class hierarchy. The phases are organized into three logical categories:
    *   **Pre-Game:** (e.g., `SplashScreen`, `PlayerSelectionPhase`) Inherit from `PreGamePhase` for shared display logic.
    *   **In-Game:** (e.g., `WaitingPhase`, `BankingPhase`) Inherit from `InGamePhase` for shared display logic.
    *   **Post-Game:** (e.g., `PostGamePhase_V1`) Inherit from `GamePhase`.

    The hierarchy starts with:
    *   `GamePhase` (Abstract Base Class)
    *   `PreGamePhase` (Intermediate Class inheriting from `GamePhase`)
    *   `InGamePhase` (Intermediate Class inheriting from `GamePhase`)
    *   Concrete classes (e.g., `WaitingPhase`, `PlayerSelectionPhase`) inheriting from the appropriate level.

    This structure allows for common logic to be shared at the intermediate levels. For example, `PreGamePhase` can ensure certain displays remain off by default, while `InGamePhase` provides shared hooks for score and grid updates.

## 4. Implementation Plan

The following files will be created or modified to implement the Game State Machine, following a "Pure State" architectural pattern where the `Game` class acts as a generic engine and all game logic is encapsulated within the `GamePhase` classes.

#### New Files - Common Definitions
*   **`src/farkle/include/GameConstants.h`**
    *   **Why:** Defines global constants used across the game logic and hardware components, ensuring a single source of truth.
    *   **Implementation Details:**
        *   `#define MAX_PLAYERS 8`

*   **`src/farkle/include/Input.h`**
    *   **Why:** Defines the input structures used by the `Game` engine and its phases.
    *   **Implementation Details:**
        *   `enum ButtonAction { NONE, BANK, FARKLE, CLEAR, SELECT, PLUS_50, PLUS_100, PLUS_500 };`
        *   `struct GameInput { ButtonAction action; int rotationDelta; };`

*   **`src/farkle/include/Displays.h`**
    *   **Why:** To group all display component objects into a single parameter object (struct), simplifying method signatures.
    *   **Implementation Details:**
        *   `struct Displays`: Will contain references (`&`) to all display components: `ScoreDisplay& scoreDisplay;`, `LedProgressGrid& grid;`, `FarkleWarningLights& farkleLights;`, `TextDisplayV2& textDisplay;`.

#### New Files - Data Structures
*   **`src/farkle/include/GameState.h`**
    *   **Why:** Defines the core data structures, keeping data separate from logic.
    *   **Implementation Details:**
        *   `struct Player`: Will contain `std::string name;`, `int score;`, `int farkle_count;`, and `uint16_t hue;` (stored as a 0-65535 value for easy color wheel math and unified hardware rendering).
        *   `struct GameState`: Will contain `std::vector<Player> players;`, `int atRiskScore;`, `int currentPlayerIndex;`, `bool finalRoundTriggered = false;`, `int targetScore = 10000;`, `uint32_t scoresVersion`.
        *   `void reset()`: Resets all flags, clears the player list, and increments `scoresVersion`.
        *   **Color Management Utility**: A static or global helper function `uint16_t getNextPlayerHue(int playerCount)` will generate high-contrast "Golden Ratio" hues. This ensures the game engine defines the visual identity, while components handle the conversion to RGB/RGB565.
        *   `void updatePlayerScore(int playerIndex, int newScore)`: Helper to update score and increment `scoresVersion`.
        *   `void addPlayerScore(int playerIndex, int delta)`: Helper to add to score and increment `scoresVersion`.

#### New Files - Phase Interfaces
*   **`src/farkle/include/GamePhase.h`**
    *   **Why:** Defines the core interfaces for the State pattern. This is the contract all phases must adhere to.
    *   **Implementation Details:**
        *   Forward-declare `class Game;`.
        *   `class GamePhase` will be an abstract base class.
        *   It will define the pure virtual interface:
            *   `virtual void onEnter(Game& game, GameState& state) = 0;`
            *   `virtual GamePhase* update(Game& game, GameState& state, GameInput input, unsigned long deltaTime) = 0;`
            *   `virtual void display(const GameState& state, const Displays& displays) = 0;` // Renders color-coded UI using state.currentPlayerIndex and grid colors.
        *   `class PreGamePhase : public GamePhase` will be an intermediate class.
            *   It will provide a concrete, shared implementation of the `display()` method that ensures `ScoreDisplay` (at-risk and current score) and `FarkleWarningLights` are explicitly cleared/OFF.
            *   It will ensure the `COMPETITION_SCORE` segment of the `ScoreDisplay` always shows `state.targetScore` for persistent goal feedback.
            *   It will provide virtual hooks for `updateProgressGrid()` and `updateTextDisplay()`, allowing subclasses to focus solely on their specific UI elements.
        *   `class InGamePhase : public GamePhase` will be an intermediate class.
            *   It will provide a concrete, shared implementation of the `display()` method, which calls multiple virtual hooks (`updateScoreDisplays()`, `updateProgressGrid()`, etc.).
            *   `updateScoreDisplays()` is further decomposed into sub-hooks for the three displays: `updateAtRiskScoreDisplay()`, `updateCurrentPlayerScoreDisplay()`, and `updateCompetitionScoreDisplay()`. The `updateCompetitionScoreDisplay` hook will pass the `finalRoundTriggered` flag to the `ScoreDisplay` to enable blinking during the final round.
            *   It will provide a protected helper method `void endTurn(GameState& state);` which will increment the `currentPlayerIndex`.
            *   It will maintain `m_scores` vector and `m_lastScoresVersion` to optimize progress grid updates.

#### New Files - Game Engine
*   **`src/farkle/include/Game.h`** & **`src/farkle/src/Game.cpp`**
    *   **Why:** Implements the main `Game` engine class, which acts as a pure state machine manager and context for the phases.
    *   **Implementation Details:**
        *   The header will define the `PhasePool` as a private struct containing one instance of each concrete phase, including `TargetScoreSelectionPhase` and `PlayerSelectionPhase`.
        *   The class will own the `PhasePool`, the `GameState` object, `GamePhase* currentPhase`, and all hardware component classes.
        *   It will provide a public templated method for phases to acquire pointers to other phases: `template<typename T> T* getPhase();`.
        *   **Context Methods**:
            *   `void setTargetScore(int target)`: Coordinated update that syncs `GameState`, `LedProgressGrid`, and `ScoreDisplay`.
            *   `void addPlayer(const std::string& name)`: Coordinated update that adds a player to `GameState` and calls `grid.addPlayer()` to assign a color.
            *   `bool canAddPlayer()`: Helper to query the hardware (`grid.isMaxPlayersReached()`).
            *   `void resetGame()`: Resets the `GameState` and hardware components to a clean state.
        *   `Game::setup()` will initialize hardware, call `resetGame()`, and set the initial state: `currentPhase = &phasePool.targetScoreSelection;`.
        *   `Game::loop()` will be a pure state machine engine, containing no game-specific logic:
            1.  Calculate `deltaTime`.
            2.  Read input from the `ControlPad`: `GameInput input = controlPad.read();`.
            3.  Construct the `Displays` struct.
            4.  `GamePhase* nextPhase = currentPhase->update(*this, state, input, deltaTime);`
            5.  `if (nextPhase != currentPhase) { currentPhase = nextPhase; currentPhase->onEnter(*this, state); }`
            6.  `currentPhase->display(state, displays);`

#### New Files - Concrete Phase Implementations
Detailed implementation plans for each phase are organized by category:

*   **[Pre-Game Phases](PRE_GAME_PHASES.md)**
    *   `TargetScoreSelectionPhase`
    *   `PlayerSelectionPhase`
*   **[In-Game Phases](IN_GAME_PHASES.md)**
    *   `WaitingPhase`
    *   `BankingPhase`
    *   `FarklingPhase`
    *   `PenaltyFarklingPhase`
*   **[Post-Game Phases](POST_GAME_PHASES.md)**
    *   `PostGamePhase_V1`

#### Modified Files
*   **`src/farkle/src/main.cpp`**
    *   **Why:** To delegate all responsibility to the new `Game` class.
