gwenrich136/farkle-scoreboard/hardware/custom-footprint-references/max7219-big.png

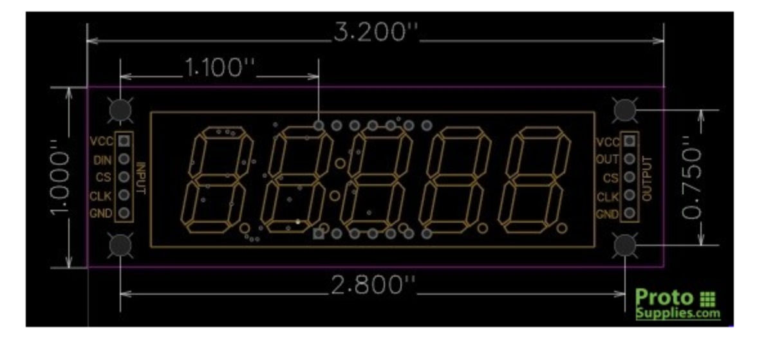
hardware/custom-footprint-references/max7219-big.png
