gwenrich136/farkle-scoreboard/hardware/custom-footprint-references/max7219-small.png

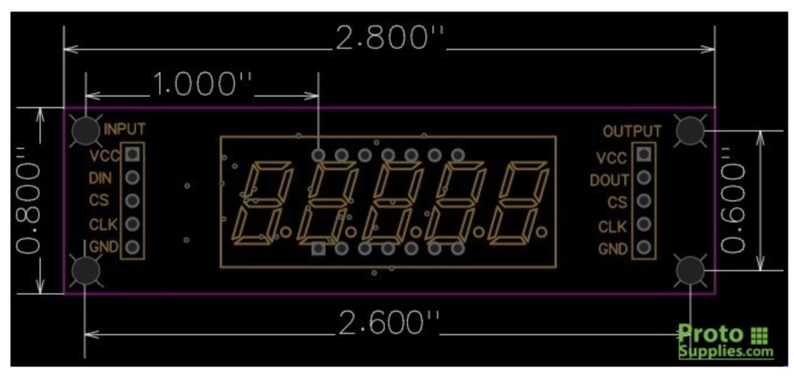
hardware/custom-footprint-references/max7219-small.png
