gwenrich136/farkle-scoreboard/hardware/custom-footprint-references/mp3-module.png

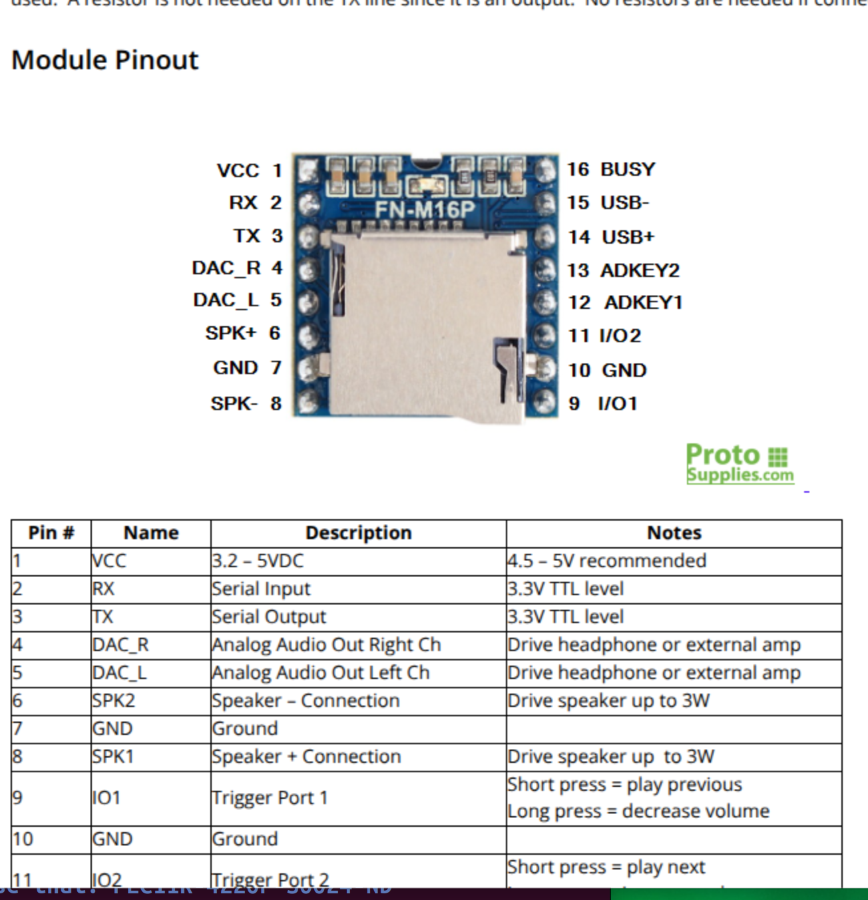
hardware/custom-footprint-references/mp3-module.png
