gwenrich136/farkle-scoreboard/hardware/kicad/FarkleScorekeeper/bom.csv

Comment | Designator | Footprint | LCSC Part # | MPN | JLCPCB Class | Mount Type | Qty | Description
WS2812B | LED1,LED2,LED3,LED4,LED5,LED6,LED7,LED8,LED9,LED10,LED11,LED12,LED13,LED14,LED15,LED16,LED17,LED18,LED19,LED20,LED21,LED22,LED23,LED24,LED25,LED26,LED27,LED28,LED29,LED30,LED31,LED32,LED33,LED34,LED35,LED36,LED37,LED38,LED39,LED40,LED41,LED42,LED43,LED44,LED45,LED46,LED47,LED48,LED49,LED50,LED51,LED52,LED53,LED54,LED55,LED56,LED57,LED58,LED59,LED60,LED61,LED62,LED63,LED64,LED65,LED66,LED67,LED68,LED69,LED70,LED71,LED72 | LED_SMD:LED_WS2812B_PLCC4_5.0x5.0mm_P3.2mm | C2843785 | XL-5050RGBC-2812B | Extended | SMT (Top / F.Cu) | 72 | Xinglight 5050 Addressable RGB LED WS2812B-Compatible (alt LCSC: C114586, C2761795)
TPS2595 | U_EFUSE1 | CustomKiCadLibrary:TPS2595_WSON-8_2x2mm | C2155775 | TPS259530DSGR | Extended | SMT (Top / F.Cu) | 1 | TI 5V eFuse Power Protection IC with Overvoltage Clamp & Current Limit, WSON-8 2x2mm
AP2112K-3.3 | U_LDO1 | Package_TO_SOT_SMD:SOT-23-5 | C51118 | AP2112K-3.3TRG1 | Extended | SMT (Top / F.Cu) | 1 | Diodes Inc 3.3V 600mA Low-Dropout Linear Regulator, SOT-23-5
74LVC245A | U_LVL1 | Package_SO:SOIC-20W_7.5x12.8mm_P1.27mm | C571201 | SN74LVC245ADWR | Extended | SMT (Top / F.Cu) | 1 | TI Octal Bus Transceiver 5V-to-3.3V Level Shifter, SOIC-20W 300mil (alt LCSC: C5546 74LVC245AD,118)
74AHCT244 | U_BUF1 | Package_SO:SOIC-20W_7.5x12.8mm_P1.27mm | C6776 | SN74HCT244DWR | Extended | SMT (Top / F.Cu) | 1 | TI Octal Buffer/Line Driver 3.3V-to-5V TTL-Input, SOIC-20W 300mil
1N5819 | D1,D2,D3,D4,D5,D6,D7 | Diode_SMD:D_SOD-123 | C8598 | B5819W | Basic | SMT (Top / F.Cu) | 7 | CJ 40V 1A Schottky Barrier Diode, SOD-123 (alt LCSC: C64885)
SMBJ5.0A | D_TVS1 | Diode_SMD:D_SMB | C129528 | SMBJ5.0A | Extended | SMT (Top / F.Cu) | 1 | BrightKing/Yageo 5V 600W Unidirectional TVS Diode, SMB / DO-214AA (alt LCSC: C111248)
600R@100MHz | FB1 | Inductor_SMD:L_0805_2012Metric | C1017 | GZ2012D601TF | Basic | SMT (Top / F.Cu) | 1 | Sunlord 600 Ohm @ 100MHz 500mA Ferrite Bead, 0805
100nF | C2,C_A2,C_BUF1,C_IN1,C_LCD,C_LED1,C_LED2,C_LED3,C_LED4,C_LED5,C_LED6,C_LED7,C_LED8,C_LED9,C_LVL1,C_MCU,C_MP3_DEC | Capacitor_SMD:C_0603_1608Metric | C14663 | CC0603KRX7R9BB104 | Basic | SMT (Top / F.Cu) | 17 | YAGEO 100nF (0.1uF) 50V 10% X7R MLCC Decoupling Capacitor, 0603
1uF | C_LDO_IN,C_LDO_OUT | Capacitor_SMD:C_0603_1608Metric | C15849 | CL10A105KB8NNNC | Basic | SMT (Top / F.Cu) | 2 | Samsung 1uF 50V 10% X5R MLCC LDO Input/Output Capacitor, 0603
10nF | C_DVDT1 | Capacitor_SMD:C_0603_1608Metric | C57112 | 0603B103K500NT | Basic | SMT (Top / F.Cu) | 1 | FH 10nF 50V 10% X7R MLCC eFuse Soft-Start dV/dt Capacitor, 0603
330R | R1,R2 | Resistor_SMD:R_0603_1608Metric | C23138 | 0603WAF3300T5E | Basic | SMT (Top / F.Cu) | 2 | UNI-ROYAL 330 Ohm 1% 1/10W Thick Film Resistor (WS2812B Data Line Series), 0603
1k | R_RX1 | Resistor_SMD:R_0603_1608Metric | C21190 | 0603WAF1001T5E | Basic | SMT (Top / F.Cu) | 1 | UNI-ROYAL 1k Ohm 1% 1/10W Thick Film Resistor (DFPlayer UART Divider Top), 0603
2k | R_RX2 | Resistor_SMD:R_0603_1608Metric | C22975 | 0603WAF2001T5E | Basic | SMT (Top / F.Cu) | 1 | UNI-ROYAL 2k Ohm 1% 1/10W Thick Film Resistor (DFPlayer UART Divider Bottom), 0603
10k | R_EN1,R_ENC1,R_ENC2 | Resistor_SMD:R_0603_1608Metric | C25804 | 0603WAF1002T5E | Basic | SMT (Top / F.Cu) | 3 | UNI-ROYAL 10k Ohm 1% 1/10W Thick Film Resistor (eFuse EN Pull-Up & Rotary Encoder Pull-Ups), 0603
22k | R_ILIM1 | Resistor_SMD:R_0603_1608Metric | C31850 | 0603WAF2202T5E | Basic | SMT (Top / F.Cu) | 1 | UNI-ROYAL 22k Ohm 1% 1/10W Thick Film Resistor (eFuse ~4A Current Limit Set), 0603
100k | R_EN2 | Resistor_SMD:R_0603_1608Metric | C25803 | 0603WAF1003T5E | Basic | SMT (Top / F.Cu) | 1 | UNI-ROYAL 100k Ohm 1% 1/10W Thick Film Resistor (eFuse EN Pull-Down), 0603
1000uF | C1 | Capacitor_THT:CP_Radial_D10.0mm_P5.00mm |  | 1000uF_16V_Radial_10x5mm | Hand-Solder | THT (Bottom / B.Cu) | 1 | 1000uF >=16V Radial Electrolytic Bulk Capacitor (10mm Dia, 5.0mm Pitch) - Hand Solder
100uF | C_MP3_BULK | Capacitor_THT:CP_Radial_D6.3mm_P2.50mm |  | 100uF_16V_Radial_6.3x2.5mm | Hand-Solder | THT (Bottom / B.Cu) | 1 | 100uF >=16V Radial Electrolytic Audio Bulk Capacitor (6.3mm Dia, 2.5mm Pitch) - Hand Solder
SW_Push_Dual | +50,+100,+500,BANK,CLEAR,FARKLE | Button_Switch_THT:SW_PUSH-12mm |  | ProtoSupplies-12mm-Tactile | Hand-Solder | THT (Top / F.Cu) | 6 | 12mm Tactile Momentary Pushbutton w/ Cap (Reused from ProtoSupplies) - Hand Solder
SW_DPDT_x2 | SW2 | CustomKiCadLibrary:SW_Toggle_DPDT_PC_Pin_E-Switch_100DP1 |  | 100DP1T1B1M2QE | Hand-Solder | THT (Top / F.Cu) | 1 | E-Switch 100DP1T1B1M2QE (DigiKey EG2361-ND) Miniature DPDT ON-ON Bat Toggle Switch (Banked/Total Score Mode), PC Pins - Hand Solder
Mute_Switch | SW_MUTE | Button_Switch_THT:SW_E-Switch_EG2219_DPDT_Angled |  | EG2219 | Hand-Solder | THT (Top / F.Cu Edge) | 1 | E-Switch EG2219 Right-Angle PCB DPDT Slide Switch (Audio Mute) - Hand Solder
EC11_Encoder | RotaryEncoder | Rotary_Encoder:RotaryEncoder_Alps_EC11E-Switch_Vertical_H20mm |  | PEC11R-4220F-S0024 | Hand-Solder | THT (Top / F.Cu) | 1 | Bourns PEC11R-4220F-S0024 (DigiKey PEC11R-4220F-S0024-ND) 20-Detent Rotary Encoder w/ Pushbutton - Hand Solder
Terminal_Block_1x02 | J_PWR,J_SPK,J_SW | TerminalBlock_Phoenix:TerminalBlock_Phoenix_MKDS-1 | 5-2-5.08_1x02_P5.08mm_Horizontal |  | 1985946 | Hand-Solder | THT (Bottom / B.Cu) | 3 | Phoenix Contact 1985946 (MKDSN 2,5/ 2-5,08 HT BK) 2-Pin 5.08mm Pitch PCB Screw Terminal Block - Hand Solder
PinSocket_1x08 | J1,J4 | Connector_PinSocket_2.54mm:PinSocket_1x08_P2.54mm_Vertical |  | PinSocket_1x08_2.54mm | Hand-Solder | THT (Bottom / B.Cu) | 2 | 8-Pin 2.54mm Female Header Socket for Arduino Uno R4 WiFi - Hand Solder
PinSocket_1x10 | J2 | Connector_PinSocket_2.54mm:PinSocket_1x10_P2.54mm_Vertical |  | PinSocket_1x10_2.54mm | Hand-Solder | THT (Bottom / B.Cu) | 1 | 10-Pin 2.54mm Female Header Socket for Arduino Uno R4 WiFi - Hand Solder
PinSocket_1x06 | J3 | Connector_PinSocket_2.54mm:PinSocket_1x06_P2.54mm_Vertical |  | PinSocket_1x06_2.54mm | Hand-Solder | THT (Bottom / B.Cu) | 1 | 6-Pin 2.54mm Female Header Socket for Arduino Uno R4 WiFi - Hand Solder
MAX 2719 Adapter (Big) | AtRiskScore | CustomKiCadLibrary:Max2719Big |  | MAX7219_5Digit_0.56in_Module | Hand-Solder | THT (Top / F.Cu) | 1 | ProtoSupplies MAX7219 5-Digit 0.56in 7-Segment Display Module (3.2x1.0in, 2x 5-Pin Headers) - Hand Solder
MAX 2719 Adapter (Small) | Banked,Opposition | CustomKiCadLibrary:Max2719Small |  | MAX7219_5Digit_0.36in_Module | Hand-Solder | THT (Top / F.Cu) | 2 | ProtoSupplies MAX7219 5-Digit 0.36in 7-Segment Display Module (2.8x0.8in, 2x 5-Pin Headers) - Hand Solder
TextDisplay_ST7789_8Pin | TD1 | CustomKiCadLibrary:TextDisplay_ST7789_8Pin |  | ST7789_8Pin_TFT | Hand-Solder | THT (Top / F.Cu) | 1 | 8-Pin ST7789 SPI Color TFT LCD Module (8-Pin Female Socket) - Hand Solder
MemoryCard_Adapter_6Pin | MC_A1 | CustomKiCadLibrary:MemoryCard_Adapter_6Pin |  | MicroSD_Adapter_6Pin | Hand-Solder | THT (Bottom / B.Cu) | 1 | 6-Pin 5V MicroSD Card Adapter Module (6-Pin Female Socket) - Hand Solder
MP3-TF-16P | U_MP3 | CustomKiCadLibrary:DFPlayer_Mini_DIP16 |  | DFPlayer_Mini_MP3-TF-16P | Hand-Solder | THT (Bottom / B.Cu) | 1 | DFPlayer Mini / MP3-TF-16P Module (2x 8-Pin 2.54mm Female Sockets) - Hand Solder
