gwenrich136/farkle-scoreboard/design/wiring.png

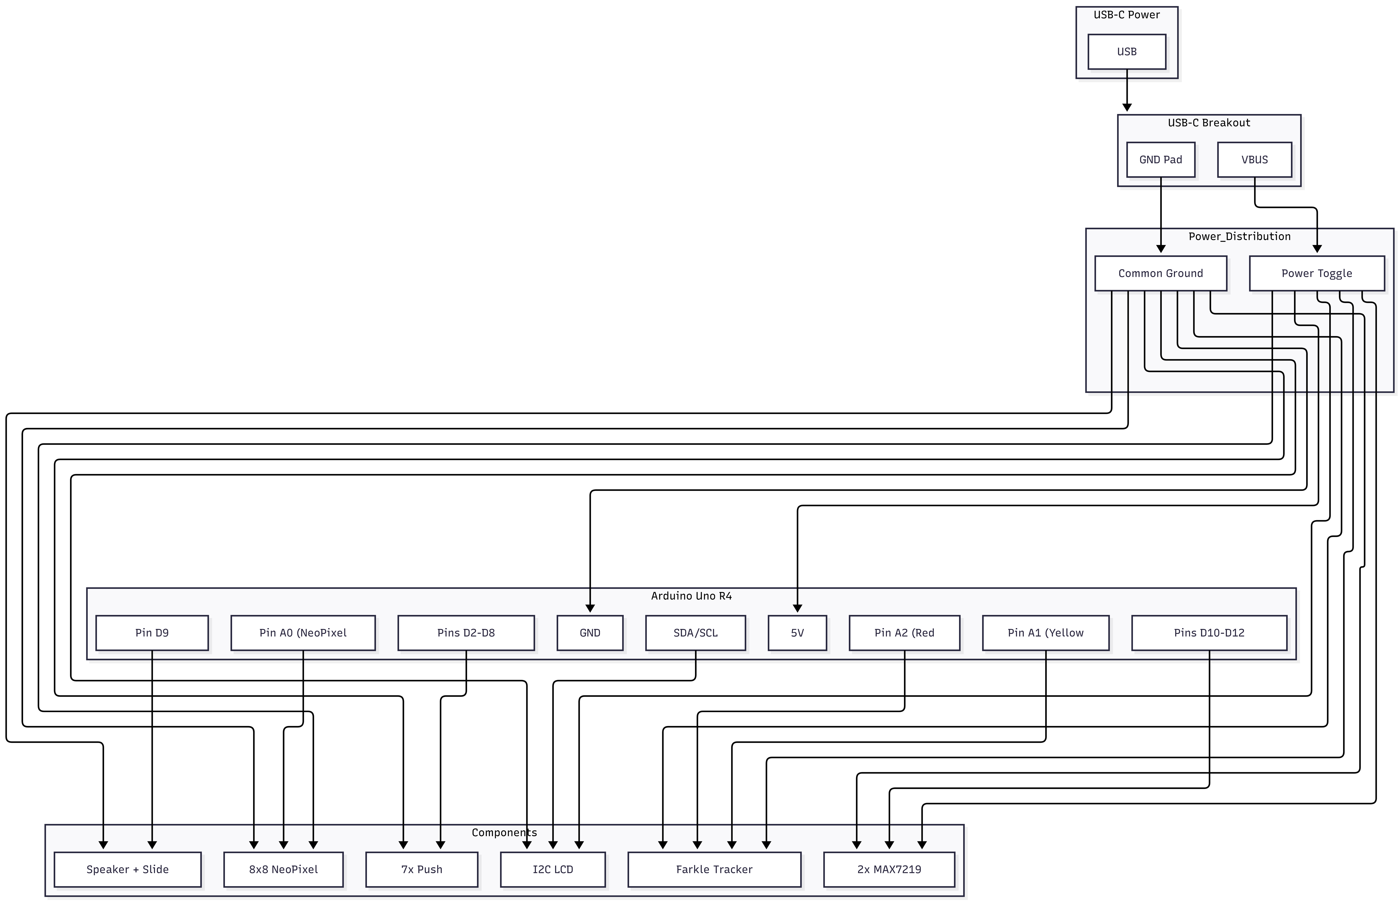
design/wiring.png
