gwenrich136/farkle-scoreboard/hardware/kicad/FarkleScorekeeper/FarkleScorekeeper.kicad_sch

## KiCad design hardware/kicad/FarkleScorekeeper/FarkleScorekeeper.kicad_sch (2026-11-07)

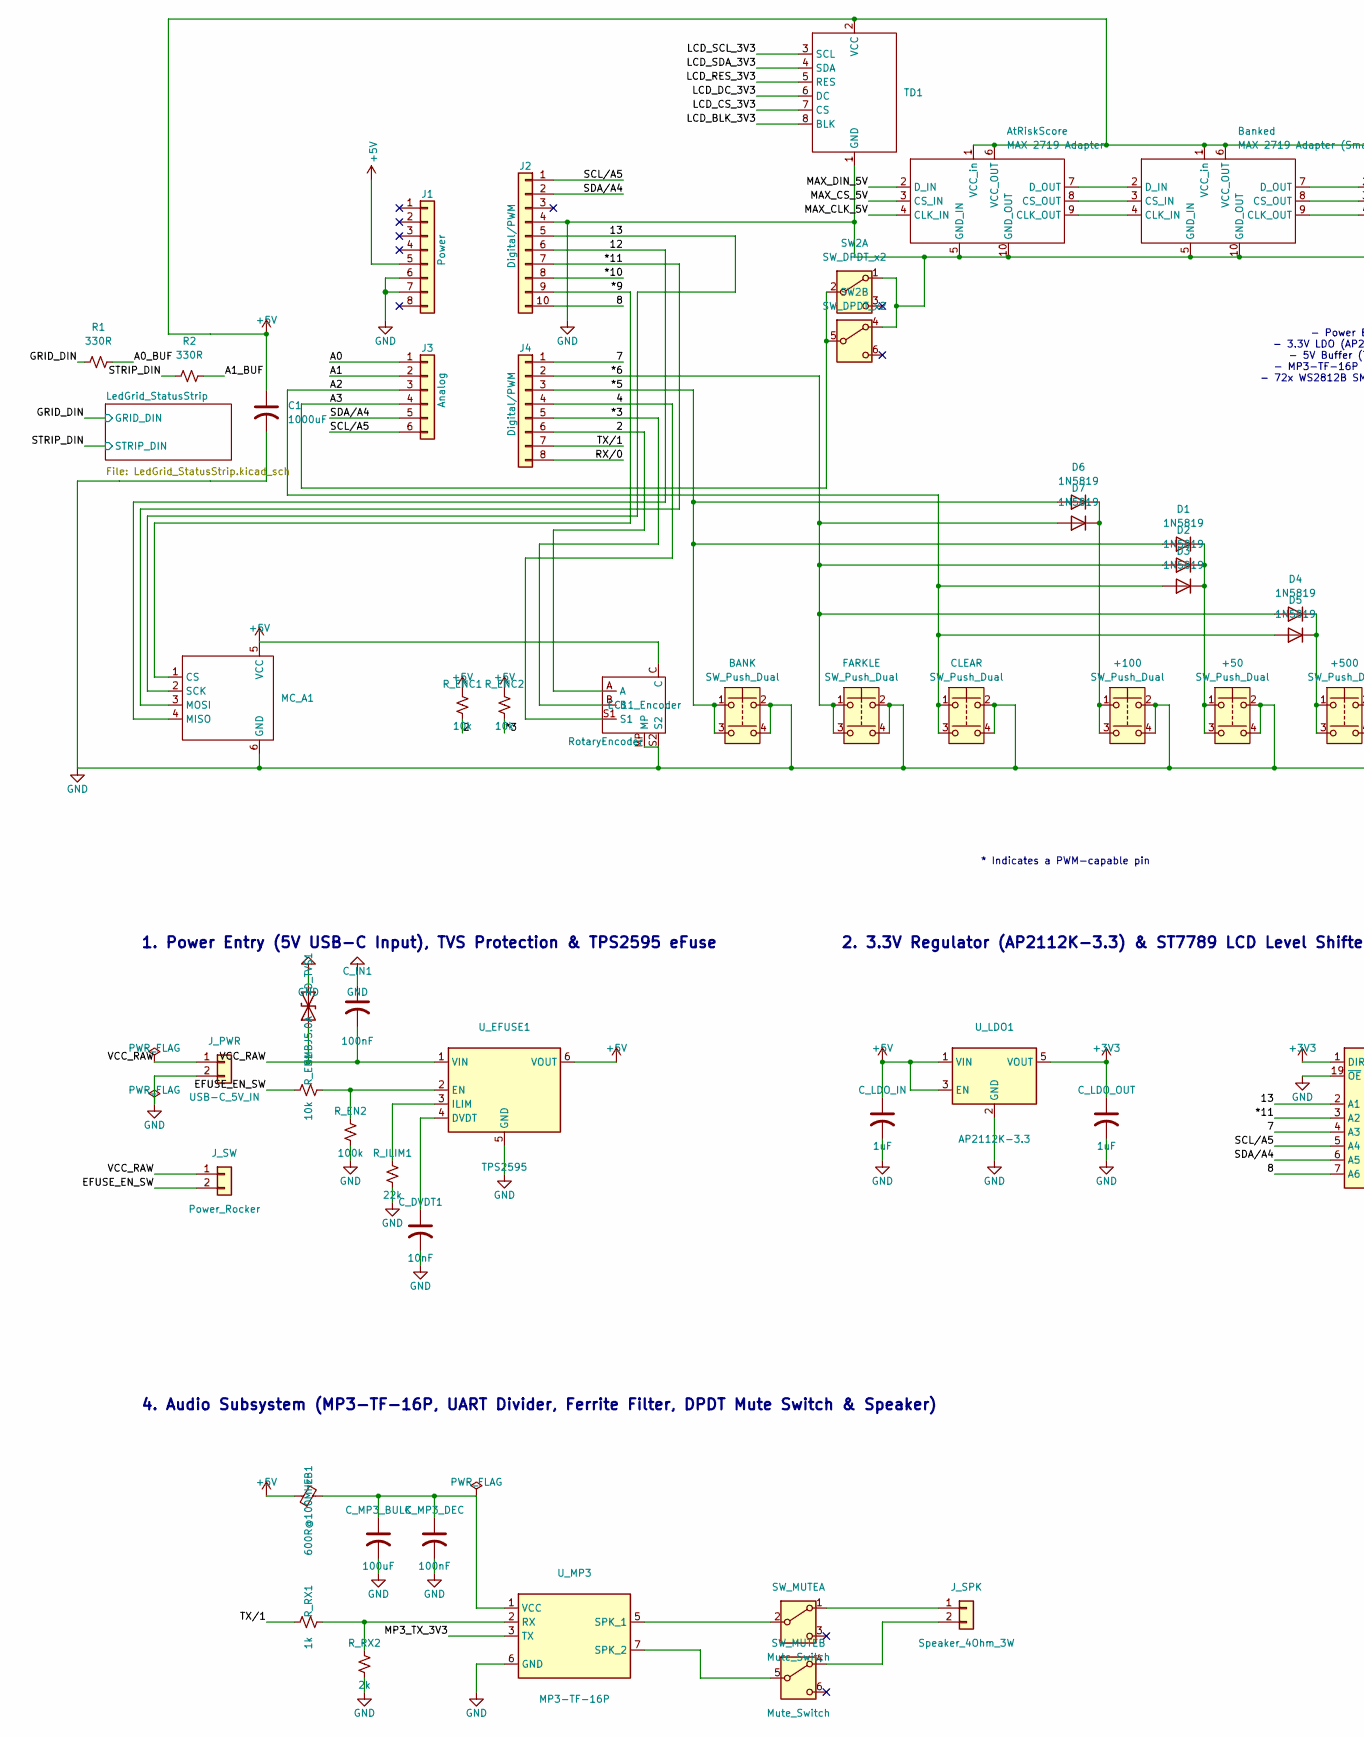
[picture p7: schematic FarkleScorekeeper.kicad_sch, part in row 1, column 1]

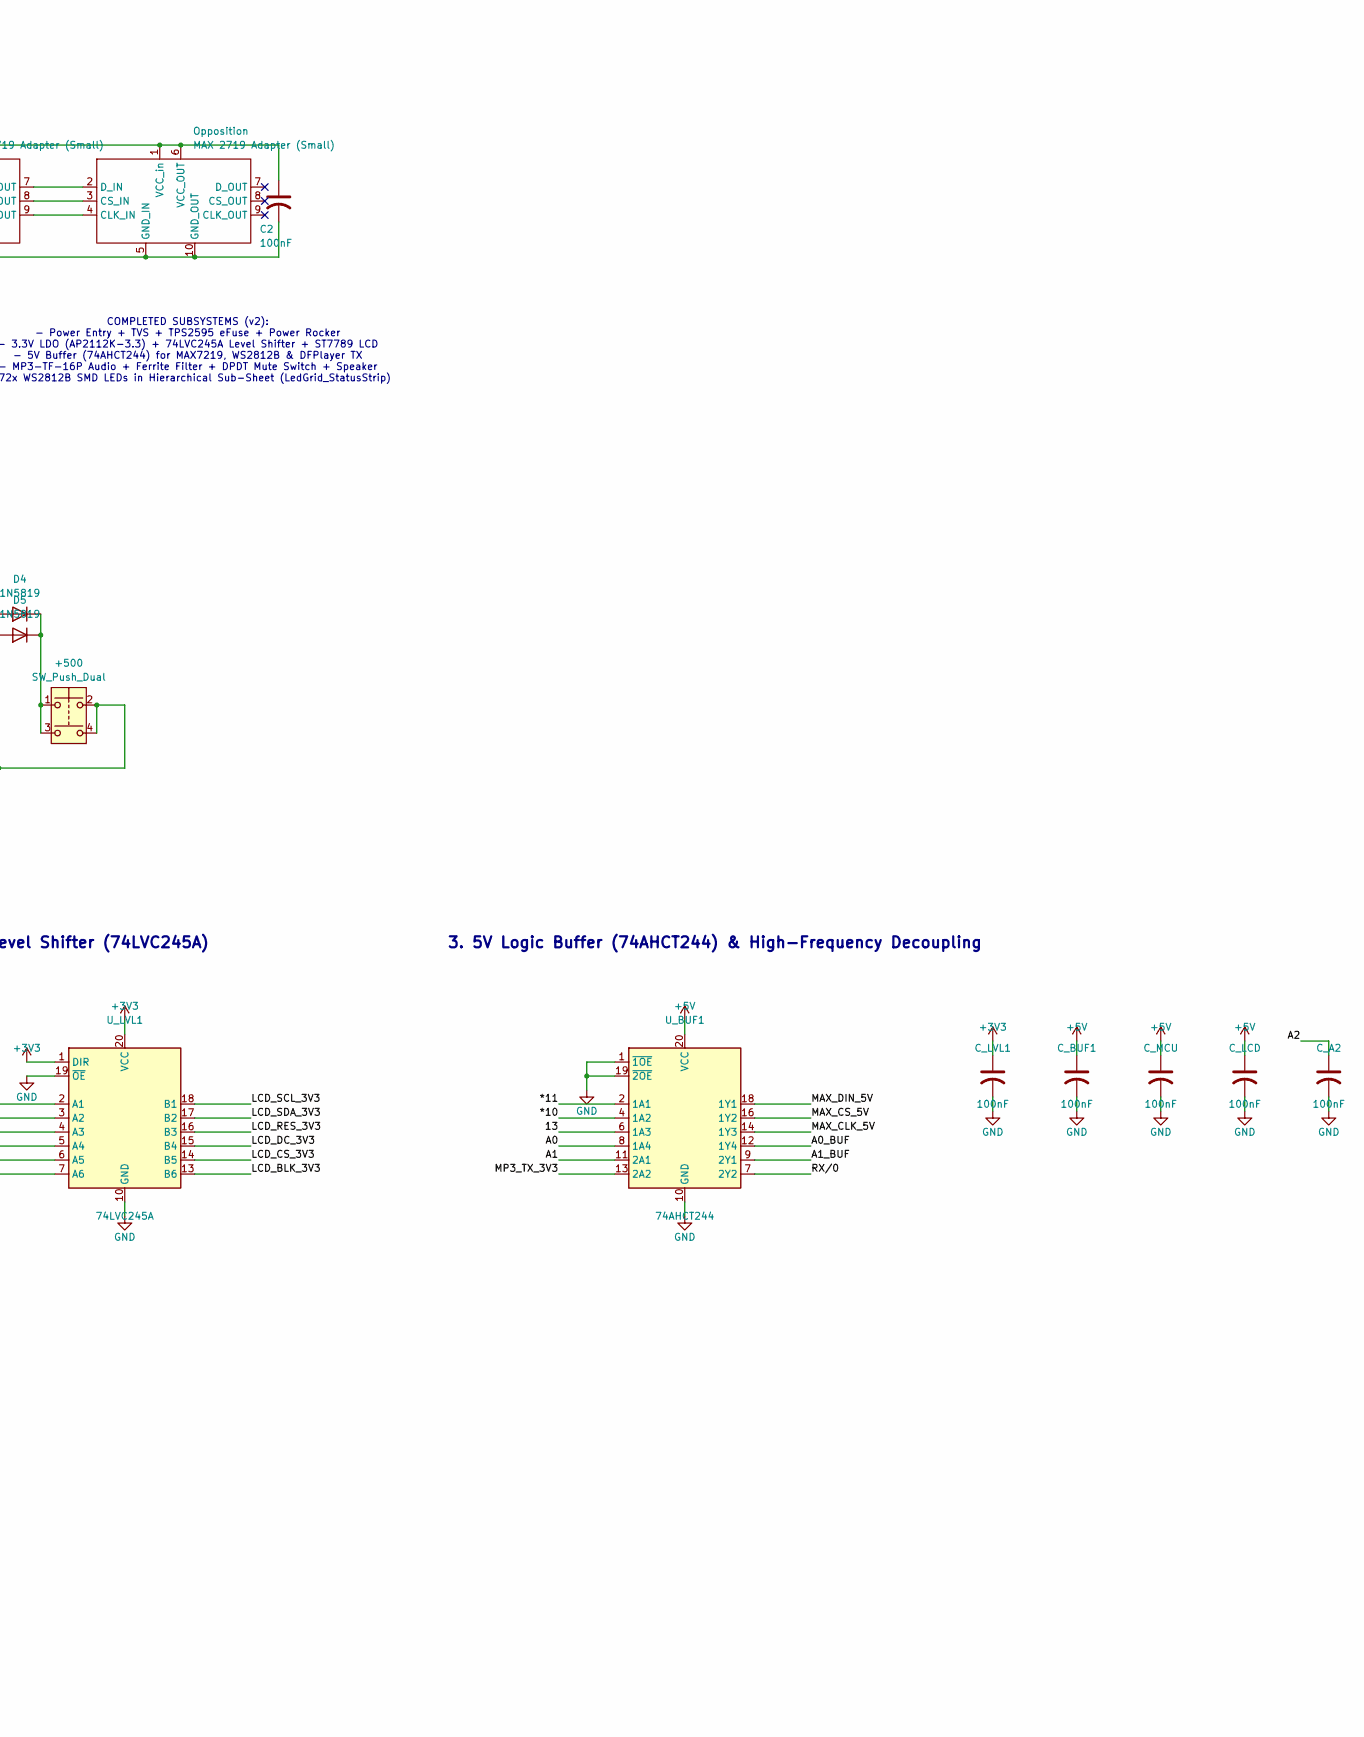
[picture p8: schematic FarkleScorekeeper.kicad_sch, part in row 1, column 2]

Parts:
+50, +100, +500: SW_Push_Dual; SW_PUSH-12mm
AtRiskScore: MAX 2719 Adapter; Max2719Big
BANK: SW_Push_Dual; SW_PUSH-12mm
Banked: MAX 2719 Adapter (Small); Max2719Small
C1: 1000uF; CP_Radial_D10.0mm_P5.00mm
C2: 100nF; C_0603_1608Metric
CLEAR: SW_Push_Dual; SW_PUSH-12mm
C_A2: 100nF; C_0603_1608Metric
C_BUF1: 100nF; C_0603_1608Metric
C_DVDT1: 10nF; C_0603_1608Metric
C_IN1: 100nF; C_0603_1608Metric
C_LCD: 100nF; C_0603_1608Metric
C_LDO_IN: 1uF; C_0603_1608Metric
C_LDO_OUT: 1uF; C_0603_1608Metric
C_LVL1: 100nF; C_0603_1608Metric
C_MCU: 100nF; C_0603_1608Metric
C_MP3_BULK: 100uF; CP_Radial_D6.3mm_P2.50mm
C_MP3_DEC: 100nF; C_0603_1608Metric
D1, D2, D3, D4, D5, D6, D7: 1N5819; D_SOD-123
D_TVS1: SMBJ5.0A; D_SMB
FARKLE: SW_Push_Dual; SW_PUSH-12mm
FB1: 600R@100MHz; L_0805_2012Metric
J1: Power; PinSocket_1x08_P2.54mm_Vertical
J2: Digital/PWM; PinSocket_1x10_P2.54mm_Vertical
J3: Analog; PinSocket_1x06_P2.54mm_Vertical
J4: Digital/PWM; PinSocket_1x08_P2.54mm_Vertical
J_PWR: USB-C_5V_IN; TerminalBlock_Phoenix_MKDS-1,5-2-5.08_1x02_P5.08mm_Horizont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
J_SPK: Speaker_4Ohm_3W; TerminalBlock_Phoenix_MKDS-1,5-2-5.08_1x02_P5.08mm_Horizont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
J_SW: Power_Rocker; TerminalBlock_Phoenix_MKDS-1,5-2-5.08_1x02_P5.08mm_Horizont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
MC_A1: MemoryCard_Adapter_6Pin
Opposition: MAX 2719 Adapter (Small); Max2719Small
R1, R2: 330R; R_0603_1608Metric
R_EN1: 10k; R_0603_1608Metric
R_EN2: 100k; R_0603_1608Metric
R_ENC1, R_ENC2: 10k; R_0603_1608Metric
R_ILIM1: 22k; R_0603_1608Metric
R_RX1: 1k; R_0603_1608Metric
R_RX2: 2k; R_0603_1608Metric
RotaryEncoder: EC11_Encoder; RotaryEncoder_Alps_EC11E-Switch_Vertical_H20mm
SW2: SW_DPDT_x2; SW_Toggle_DPDT_PC_Pin_E-Switch_100DP1
SW_MUTE: Mute_Switch; SW_E-Switch_EG2219_DPDT_Angled
TD1: TextDisplay_ST7789_8Pin
U_BUF1: 74AHCT244; SOIC-20W_7.5x12.8mm_P1.27mm
U_EFUSE1: TPS2595; TPS2595_WSON-8_2x2mm
U_LDO1: AP2112K-3.3; SOT-23-5
U_LVL1: 74LVC245A; SOIC-20W_7.5x12.8mm_P1.27mm
U_MP3: MP3-TF-16P; DFPlayer_Mini_DIP16

Connections:
2: J4.6, R_ENC1.2, RotaryEncoder.A
3: J4.5, R_ENC2.2, RotaryEncoder.B
4: J4.4, RotaryEncoder.S1
5: BANK.1, BANK.3, D1.2 (A), D6.2 (A), J4.3
6: D2.2 (A), D4.2 (A), D7.2 (A), FARKLE.1, FARKLE.3, J4.2
7: J4.1, U_LVL1.4 (A3)
8: J2.10, U_LVL1.7 (A6)
9: J2.9, MC_A1.1 (CS)
10: J2.8, U_BUF1.4 (1A2)
11: J2.7, MC_A1.3 (MOSI), U_BUF1.2 (1A1), U_LVL1.3 (A2)
12: J2.6, MC_A1.4 (MISO)
13: J2.5, MC_A1.2 (SCK), U_BUF1.6 (1A3), U_LVL1.2 (A1)
+3V3: C_LDO_OUT.1, C_LVL1.1, U_LDO1.5 (VOUT), U_LVL1.1 (DIR), U_LVL1.20 (VCC)
+5V: AtRiskScore.1 (VCC_in), AtRiskScore.6 (VCC_OUT), Banked.1 (VCC_in), Banked.6 (VCC_OUT), C1.1, C2.1, C_BUF1.1, C_LCD.1, C_LDO_IN.1, C_MCU.1, FB1.1, J1.5, MC_A1.5 (VCC), Opposition.1 (VCC_in), Opposition.6 (VCC_OUT), R_ENC1.1, R_ENC2.1, RotaryEncoder.C, TD1.2 (VCC), U_BUF1.20 (VCC), U_EFUSE1.6 (VOUT), U_LDO1.1 (VIN), U_LDO1.3 (EN)
A0: J3.1, U_BUF1.8 (1A4)
A0_BUF: R1.2, U_BUF1.12 (1Y4)
A1: J3.2, U_BUF1.11 (2A1)
A1_BUF: R2.2, U_BUF1.9 (2Y1)
A2: CLEAR.1, CLEAR.3, C_A2.1, D3.2 (A), D5.2 (A), J3.3
A3: J3.4, SW2.2 (B), SW2.5 (B)
EFUSE_EN_SW: J_SW.2, R_EN1.1
GND: +50.2, +50.4, +100.2, +100.4, +500.2, +500.4, AtRiskScore.5 (GND_IN), AtRiskScore.10 (GND_OUT), BANK.2, BANK.4, Banked.5 (GND_IN), Banked.10 (GND_OUT), C1.2, C2.2, CLEAR.2, CLEAR.4, C_A2.2, C_BUF1.2, C_DVDT1.2, C_IN1.1, C_LCD.2, C_LDO_IN.2, C_LDO_OUT.2, C_LVL1.2, C_MCU.2, C_MP3_BULK.2, C_MP3_DEC.2, D_TVS1.2 (A2), FARKLE.2, FARKLE.4, J1.6, J1.7, J2.4, J_PWR.2, MC_A1.6 (GND), Opposition.5 (GND_IN), Opposition.10 (GND_OUT), R_EN2.2, R_ILIM1.2, R_RX2.2, RotaryEncoder.MP, RotaryEncoder.S2, SW2.1 (A), SW2.4 (A), TD1.1 (GND), U_BUF1.1 (~1OE), U_BUF1.10 (GND), U_BUF1.19 (~2OE), U_EFUSE1.5 (GND), U_LDO1.2 (GND), U_LVL1.10 (GND), U_LVL1.19 (~OE), U_MP3.6 (GND)
GRID_DIN: R1.1
LCD_BLK_3V3: TD1.8 (BLK), U_LVL1.13 (B6)
LCD_CS_3V3: TD1.7 (CS), U_LVL1.14 (B5)
LCD_DC_3V3: TD1.6 (DC), U_LVL1.15 (B4)
LCD_RES_3V3: TD1.5 (RES), U_LVL1.16 (B3)
LCD_SCL_3V3: TD1.3 (SCL), U_LVL1.18 (B1)
LCD_SDA_3V3: TD1.4 (SDA), U_LVL1.17 (B2)
MAX_CLK_5V: AtRiskScore.4 (CLK_IN), U_BUF1.14 (1Y3)
MAX_CS_5V: AtRiskScore.3 (CS_IN), U_BUF1.16 (1Y2)
MAX_DIN_5V: AtRiskScore.2 (D_IN), U_BUF1.18 (1Y1)
MP3_TX_3V3: U_BUF1.13 (2A2), U_MP3.3 (TX)
unnamed: +50.1, +50.3, D1.1 (K), D2.1 (K), D3.1 (K)
unnamed: +100.1, +100.3, D6.1 (K), D7.1 (K)
unnamed: +500.1, +500.3, D4.1 (K), D5.1 (K)
unnamed: AtRiskScore.7 (D_OUT), Banked.2 (D_IN)
unnamed: AtRiskScore.8 (CS_OUT), Banked.3 (CS_IN)
unnamed: AtRiskScore.9 (CLK_OUT), Banked.4 (CLK_IN)
unnamed: Banked.7 (D_OUT), Opposition.2 (D_IN)
unnamed: Banked.8 (CS_OUT), Opposition.3 (CS_IN)
unnamed: Banked.9 (CLK_OUT), Opposition.4 (CLK_IN)
unnamed: C_DVDT1.1, U_EFUSE1.4 (DVDT)
unnamed: C_MP3_BULK.1, C_MP3_DEC.1, FB1.2, U_MP3.1 (VCC)
unnamed: J_SPK.1, SW_MUTE.1 (A)
unnamed: J_SPK.2, SW_MUTE.4 (A)
unnamed: R_EN1.2, R_EN2.1, U_EFUSE1.2 (EN)
unnamed: R_ILIM1.1, U_EFUSE1.3 (ILIM)
unnamed: R_RX1.2, R_RX2.1, U_MP3.2 (RX)
unnamed: SW_MUTE.2 (B), U_MP3.5 (SPK_1)
unnamed: SW_MUTE.5 (B), U_MP3.7 (SPK_2)
RX/0: J4.8, U_BUF1.7 (2Y2)
SCL/A5: J2.1, J3.6, U_LVL1.5 (A4)
SDA/A4: J2.2, J3.5, U_LVL1.6 (A5)
STRIP_DIN: R2.1
TX/1: J4.7, R_RX1.1
VCC_RAW: C_IN1.2, D_TVS1.1 (A1), J_PWR.1, J_SW.1, U_EFUSE1.1 (VIN)

Notes on the sheet:
* Indicates a PWM-capable pin
COMPLETED SUBSYSTEMS (v2): - Power Entry + TVS + TPS2595 eFuse + Power Rocker - 3.3V LDO (AP2112K-3.3) + 74LVC245A Level Shifter + ST7789 LCD - 5V Buffer (74AHCT244) for MAX7219, WS2812B & DFPlayer TX - MP3-TF-16P Audio + Ferrite Filter + DPDT Mute Switch + Speaker - 72x WS2812B SMD LEDs in Hierarc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
1. Power Entry (5V USB-C Input), TVS Protection & TPS2595 eFuse
2. 3.3V Regulator (AP2112K-3.3) & ST7789 LCD Level Shifter (74LVC245A)
3. 5V Logic Buffer (74AHCT244) & High-Frequency Decoupling
4. Audio Subsystem (MP3-TF-16P, UART Divider, Ferrite Filter, DPDT Mute Switch & Speaker)
