gwenrich136/farkle-scoreboard/hardware/kicad/FarkleScorekeeper/LedGrid_StatusStrip.kicad_sch

## KiCad design hardware/kicad/FarkleScorekeeper/LedGrid_StatusStrip.kicad_sch (2026-11-05)

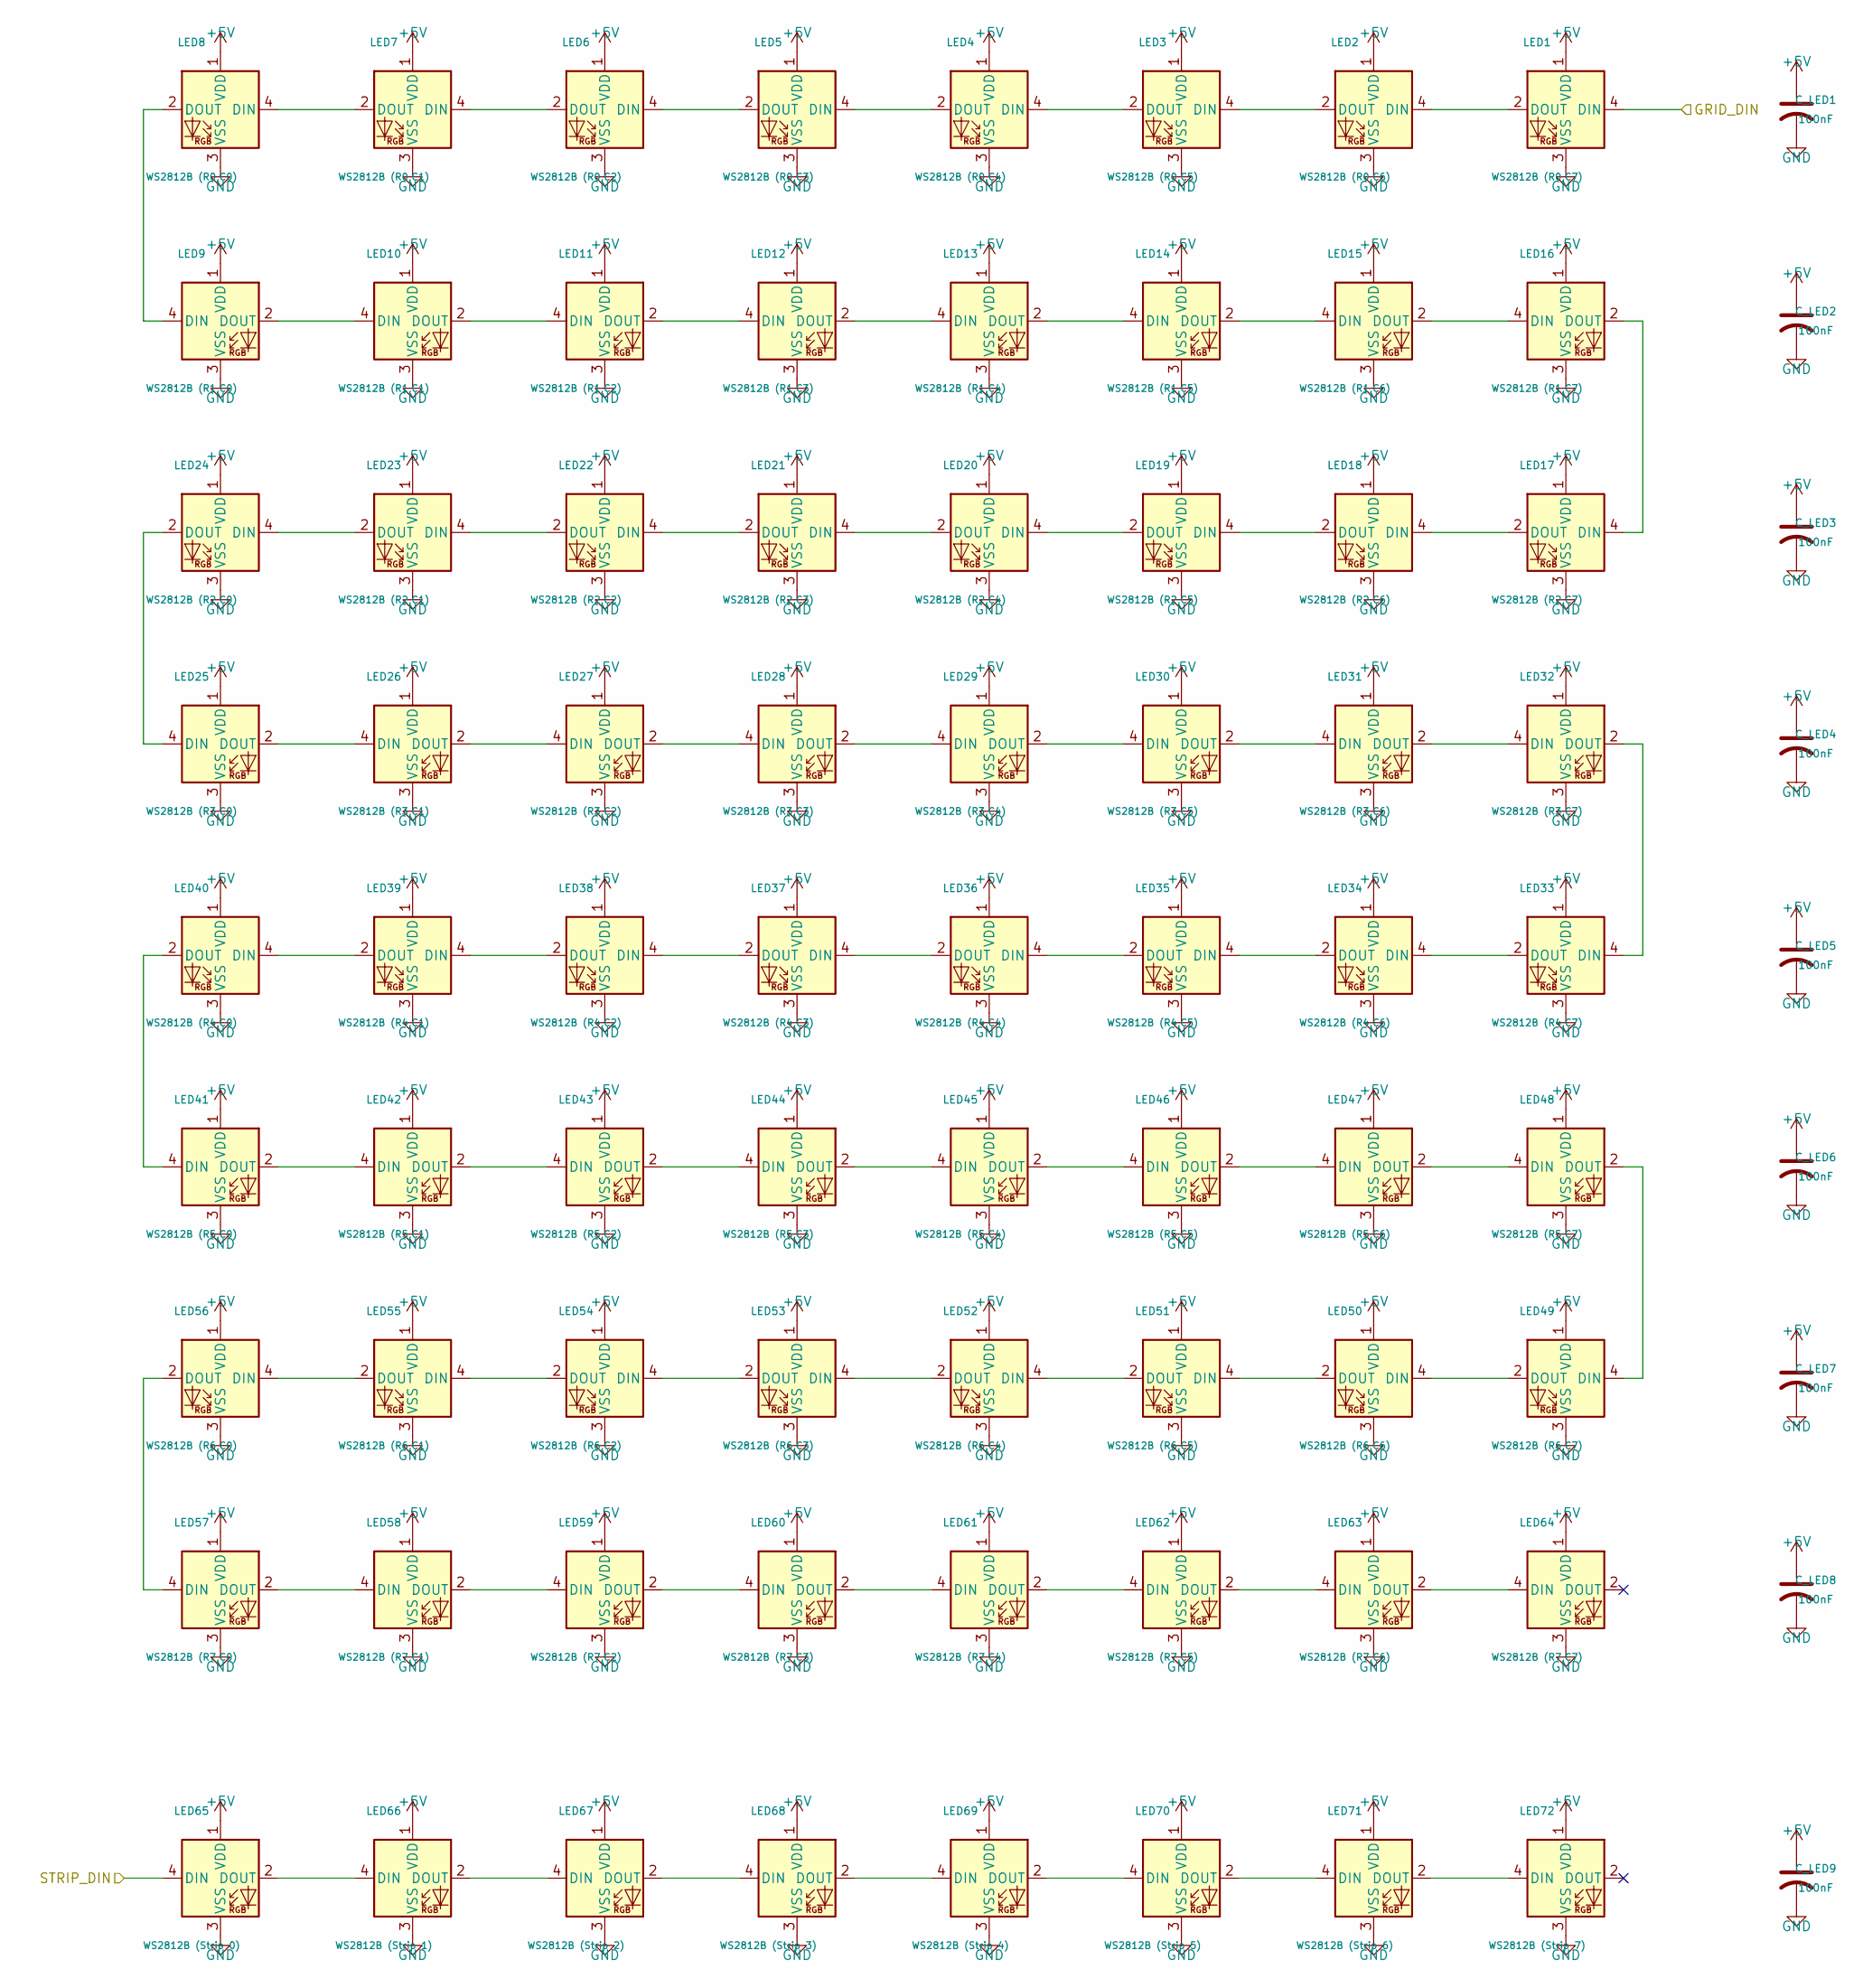
[picture p9: schematic LedGrid_StatusStrip.kicad_sch]

Parts:
C_LED1, C_LED2, C_LED3, C_LED4, C_LED5, C_LED6, C_LED7, C_LED8, C_LED9: 100nF; C_0603_1608Metric
LED1: WS2812B (R0,C7); LED_WS2812B_PLCC4_5.0x5.0mm_P3.2mm
LED2: WS2812B (R0,C6); LED_WS2812B_PLCC4_5.0x5.0mm_P3.2mm
LED3: WS2812B (R0,C5); LED_WS2812B_PLCC4_5.0x5.0mm_P3.2mm
LED4: WS2812B (R0,C4); LED_WS2812B_PLCC4_5.0x5.0mm_P3.2mm
LED5: WS2812B (R0,C3); LED_WS2812B_PLCC4_5.0x5.0mm_P3.2mm
LED6: WS2812B (R0,C2); LED_WS2812B_PLCC4_5.0x5.0mm_P3.2mm
LED7: WS2812B (R0,C1); LED_WS2812B_PLCC4_5.0x5.0mm_P3.2mm
LED8: WS2812B (R0,C0); LED_WS2812B_PLCC4_5.0x5.0mm_P3.2mm
LED9: WS2812B (R1,C0); LED_WS2812B_PLCC4_5.0x5.0mm_P3.2mm
LED10: WS2812B (R1,C1); LED_WS2812B_PLCC4_5.0x5.0mm_P3.2mm
LED11: WS2812B (R1,C2); LED_WS2812B_PLCC4_5.0x5.0mm_P3.2mm
LED12: WS2812B (R1,C3); LED_WS2812B_PLCC4_5.0x5.0mm_P3.2mm
LED13: WS2812B (R1,C4); LED_WS2812B_PLCC4_5.0x5.0mm_P3.2mm
LED14: WS2812B (R1,C5); LED_WS2812B_PLCC4_5.0x5.0mm_P3.2mm
LED15: WS2812B (R1,C6); LED_WS2812B_PLCC4_5.0x5.0mm_P3.2mm
LED16: WS2812B (R1,C7); LED_WS2812B_PLCC4_5.0x5.0mm_P3.2mm
LED17: WS2812B (R2,C7); LED_WS2812B_PLCC4_5.0x5.0mm_P3.2mm
LED18: WS2812B (R2,C6); LED_WS2812B_PLCC4_5.0x5.0mm_P3.2mm
LED19: WS2812B (R2,C5); LED_WS2812B_PLCC4_5.0x5.0mm_P3.2mm
LED20: WS2812B (R2,C4); LED_WS2812B_PLCC4_5.0x5.0mm_P3.2mm
LED21: WS2812B (R2,C3); LED_WS2812B_PLCC4_5.0x5.0mm_P3.2mm
LED22: WS2812B (R2,C2); LED_WS2812B_PLCC4_5.0x5.0mm_P3.2mm
LED23: WS2812B (R2,C1); LED_WS2812B_PLCC4_5.0x5.0mm_P3.2mm
LED24: WS2812B (R2,C0); LED_WS2812B_PLCC4_5.0x5.0mm_P3.2mm
LED25: WS2812B (R3,C0); LED_WS2812B_PLCC4_5.0x5.0mm_P3.2mm
LED26: WS2812B (R3,C1); LED_WS2812B_PLCC4_5.0x5.0mm_P3.2mm
LED27: WS2812B (R3,C2); LED_WS2812B_PLCC4_5.0x5.0mm_P3.2mm
LED28: WS2812B (R3,C3); LED_WS2812B_PLCC4_5.0x5.0mm_P3.2mm
LED29: WS2812B (R3,C4); LED_WS2812B_PLCC4_5.0x5.0mm_P3.2mm
LED30: WS2812B (R3,C5); LED_WS2812B_PLCC4_5.0x5.0mm_P3.2mm
LED31: WS2812B (R3,C6); LED_WS2812B_PLCC4_5.0x5.0mm_P3.2mm
LED32: WS2812B (R3,C7); LED_WS2812B_PLCC4_5.0x5.0mm_P3.2mm
LED33: WS2812B (R4,C7); LED_WS2812B_PLCC4_5.0x5.0mm_P3.2mm
LED34: WS2812B (R4,C6); LED_WS2812B_PLCC4_5.0x5.0mm_P3.2mm
LED35: WS2812B (R4,C5); LED_WS2812B_PLCC4_5.0x5.0mm_P3.2mm
LED36: WS2812B (R4,C4); LED_WS2812B_PLCC4_5.0x5.0mm_P3.2mm
LED37: WS2812B (R4,C3); LED_WS2812B_PLCC4_5.0x5.0mm_P3.2mm
LED38: WS2812B (R4,C2); LED_WS2812B_PLCC4_5.0x5.0mm_P3.2mm
LED39: WS2812B (R4,C1); LED_WS2812B_PLCC4_5.0x5.0mm_P3.2mm
LED40: WS2812B (R4,C0); LED_WS2812B_PLCC4_5.0x5.0mm_P3.2mm
LED41: WS2812B (R5,C0); LED_WS2812B_PLCC4_5.0x5.0mm_P3.2mm
LED42: WS2812B (R5,C1); LED_WS2812B_PLCC4_5.0x5.0mm_P3.2mm
LED43: WS2812B (R5,C2); LED_WS2812B_PLCC4_5.0x5.0mm_P3.2mm
LED44: WS2812B (R5,C3); LED_WS2812B_PLCC4_5.0x5.0mm_P3.2mm
LED45: WS2812B (R5,C4); LED_WS2812B_PLCC4_5.0x5.0mm_P3.2mm
LED46: WS2812B (R5,C5); LED_WS2812B_PLCC4_5.0x5.0mm_P3.2mm
LED47: WS2812B (R5,C6); LED_WS2812B_PLCC4_5.0x5.0mm_P3.2mm
LED48: WS2812B (R5,C7); LED_WS2812B_PLCC4_5.0x5.0mm_P3.2mm
LED49: WS2812B (R6,C7); LED_WS2812B_PLCC4_5.0x5.0mm_P3.2mm
LED50: WS2812B (R6,C6); LED_WS2812B_PLCC4_5.0x5.0mm_P3.2mm
LED51: WS2812B (R6,C5); LED_WS2812B_PLCC4_5.0x5.0mm_P3.2mm
LED52: WS2812B (R6,C4); LED_WS2812B_PLCC4_5.0x5.0mm_P3.2mm
LED53: WS2812B (R6,C3); LED_WS2812B_PLCC4_5.0x5.0mm_P3.2mm
LED54: WS2812B (R6,C2); LED_WS2812B_PLCC4_5.0x5.0mm_P3.2mm
LED55: WS2812B (R6,C1); LED_WS2812B_PLCC4_5.0x5.0mm_P3.2mm
LED56: WS2812B (R6,C0); LED_WS2812B_PLCC4_5.0x5.0mm_P3.2mm
LED57: WS2812B (R7,C0); LED_WS2812B_PLCC4_5.0x5.0mm_P3.2mm
LED58: WS2812B (R7,C1); LED_WS2812B_PLCC4_5.0x5.0mm_P3.2mm
LED59: WS2812B (R7,C2); LED_WS2812B_PLCC4_5.0x5.0mm_P3.2mm
LED60: WS2812B (R7,C3); LED_WS2812B_PLCC4_5.0x5.0mm_P3.2mm
LED61: WS2812B (R7,C4); LED_WS2812B_PLCC4_5.0x5.0mm_P3.2mm
LED62: WS2812B (R7,C5); LED_WS2812B_PLCC4_5.0x5.0mm_P3.2mm
LED63: WS2812B (R7,C6); LED_WS2812B_PLCC4_5.0x5.0mm_P3.2mm
LED64: WS2812B (R7,C7); LED_WS2812B_PLCC4_5.0x5.0mm_P3.2mm
LED65: WS2812B (Strip 0); LED_WS2812B_PLCC4_5.0x5.0mm_P3.2mm
LED66: WS2812B (Strip 1); LED_WS2812B_PLCC4_5.0x5.0mm_P3.2mm
LED67: WS2812B (Strip 2); LED_WS2812B_PLCC4_5.0x5.0mm_P3.2mm
LED68: WS2812B (Strip 3); LED_WS2812B_PLCC4_5.0x5.0mm_P3.2mm
LED69: WS2812B (Strip 4); LED_WS2812B_PLCC4_5.0x5.0mm_P3.2mm
LED70: WS2812B (Strip 5); LED_WS2812B_PLCC4_5.0x5.0mm_P3.2mm
LED71: WS2812B (Strip 6); LED_WS2812B_PLCC4_5.0x5.0mm_P3.2mm
LED72: WS2812B (Strip 7); LED_WS2812B_PLCC4_5.0x5.0mm_P3.2mm

Connections:
+5V: C_LED1.1, C_LED2.1, C_LED3.1, C_LED4.1, C_LED5.1, C_LED6.1, C_LED7.1, C_LED8.1, C_LED9.1, LED1.1 (VDD), LED2.1 (VDD), LED3.1 (VDD), LED4.1 (VDD), LED5.1 (VDD), LED6.1 (VDD), LED7.1 (VDD), LED8.1 (VDD), LED9.1 (VDD), LED10.1 (VDD), LED11.1 (VDD), LED12.1 (VDD), LED13.1 (VDD), LED14.1 (VDD), LED15.1 (VDD), LED16.1 (VDD), LED17.1 (VDD), LED18.1 (VDD), LED19.1 (VDD), LED20.1 (VDD), LED21.1 (VDD), LED22.1 (VDD), LED23.1 (VDD), LED24.1 (VDD), LED25.1 (VDD), LED26.1 (VDD), LED27.1 (VDD), LED28.1 (VDD), LED29.1 (VDD), LED30.1 (VDD), LED31.1 (VDD), LED32.1 (VDD), LED33.1 (VDD), LED34.1 (VDD), LED35.1 (VDD), LED36.1 (VDD), LED37.1 (VDD), LED38.1 (VDD), LED39.1 (VDD), LED40.1 (VDD), LED41.1 (VDD), LED42.1 (VDD), LED43.1 (VDD), LED44.1 (VDD), LED45.1 (VDD), LED46.1 (VDD), LED47.1 (VDD), LED48.1 (VDD), LED49.1 (VDD), LED50.1 (VDD), LED51.1 (VDD), LED52.1 (VDD), LED53.1 (VDD), LED54.1 (VDD), LED55.1 (VDD), LED56.1 (VDD), LED57.1 (VDD), LED58.1 (VDD), LED59.1 (VDD), LED60.1 (VDD), LED61.1 (VDD), LED62.1 (VDD), LED63.1 (VDD), LED64.1 (VDD), LED65.1 (VDD), LED66.1 (VDD), LED67.1 (VDD), LED68.1 (VDD), LED69.1 (VDD), LED70.1 (VDD), LED71.1 (VDD), LED72.1 (VDD)
GND: C_LED1.2, C_LED2.2, C_LED3.2, C_LED4.2, C_LED5.2, C_LED6.2, C_LED7.2, C_LED8.2, C_LED9.2, LED1.3 (VSS), LED2.3 (VSS), LED3.3 (VSS), LED4.3 (VSS), LED5.3 (VSS), LED6.3 (VSS), LED7.3 (VSS), LED8.3 (VSS), LED9.3 (VSS), LED10.3 (VSS), LED11.3 (VSS), LED12.3 (VSS), LED13.3 (VSS), LED14.3 (VSS), LED15.3 (VSS), LED16.3 (VSS), LED17.3 (VSS), LED18.3 (VSS), LED19.3 (VSS), LED20.3 (VSS), LED21.3 (VSS), LED22.3 (VSS), LED23.3 (VSS), LED24.3 (VSS), LED25.3 (VSS), LED26.3 (VSS), LED27.3 (VSS), LED28.3 (VSS), LED29.3 (VSS), LED30.3 (VSS), LED31.3 (VSS), LED32.3 (VSS), LED33.3 (VSS), LED34.3 (VSS), LED35.3 (VSS), LED36.3 (VSS), LED37.3 (VSS), LED38.3 (VSS), LED39.3 (VSS), LED40.3 (VSS), LED41.3 (VSS), LED42.3 (VSS), LED43.3 (VSS), LED44.3 (VSS), LED45.3 (VSS), LED46.3 (VSS), LED47.3 (VSS), LED48.3 (VSS), LED49.3 (VSS), LED50.3 (VSS), LED51.3 (VSS), LED52.3 (VSS), LED53.3 (VSS), LED54.3 (VSS), LED55.3 (VSS), LED56.3 (VSS), LED57.3 (VSS), LED58.3 (VSS), LED59.3 (VSS), LED60.3 (VSS), LED61.3 (VSS), LED62.3 (VSS), LED63.3 (VSS), LED64.3 (VSS), LED65.3 (VSS), LED66.3 (VSS), LED67.3 (VSS), LED68.3 (VSS), LED69.3 (VSS), LED70.3 (VSS), LED71.3 (VSS), LED72.3 (VSS)
GRID_DIN: LED1.4 (DIN)
unnamed: LED1.2 (DOUT), LED2.4 (DIN)
unnamed: LED2.2 (DOUT), LED3.4 (DIN)
unnamed: LED3.2 (DOUT), LED4.4 (DIN)
unnamed: LED4.2 (DOUT), LED5.4 (DIN)
unnamed: LED5.2 (DOUT), LED6.4 (DIN)
unnamed: LED6.2 (DOUT), LED7.4 (DIN)
unnamed: LED7.2 (DOUT), LED8.4 (DIN)
unnamed: LED8.2 (DOUT), LED9.4 (DIN)
unnamed: LED10.2 (DOUT), LED11.4 (DIN)
unnamed: LED9.2 (DOUT), LED10.4 (DIN)
unnamed: LED11.2 (DOUT), LED12.4 (DIN)
unnamed: LED12.2 (DOUT), LED13.4 (DIN)
unnamed: LED13.2 (DOUT), LED14.4 (DIN)
unnamed: LED14.2 (DOUT), LED15.4 (DIN)
unnamed: LED15.2 (DOUT), LED16.4 (DIN)
unnamed: LED16.2 (DOUT), LED17.4 (DIN)
unnamed: LED17.2 (DOUT), LED18.4 (DIN)
unnamed: LED18.2 (DOUT), LED19.4 (DIN)
unnamed: LED19.2 (DOUT), LED20.4 (DIN)
unnamed: LED20.2 (DOUT), LED21.4 (DIN)
unnamed: LED21.2 (DOUT), LED22.4 (DIN)
unnamed: LED22.2 (DOUT), LED23.4 (DIN)
unnamed: LED23.2 (DOUT), LED24.4 (DIN)
unnamed: LED24.2 (DOUT), LED25.4 (DIN)
unnamed: LED25.2 (DOUT), LED26.4 (DIN)
unnamed: LED26.2 (DOUT), LED27.4 (DIN)
unnamed: LED27.2 (DOUT), LED28.4 (DIN)
unnamed: LED28.2 (DOUT), LED29.4 (DIN)
unnamed: LED29.2 (DOUT), LED30.4 (DIN)
unnamed: LED30.2 (DOUT), LED31.4 (DIN)
unnamed: LED31.2 (DOUT), LED32.4 (DIN)
unnamed: LED32.2 (DOUT), LED33.4 (DIN)
unnamed: LED33.2 (DOUT), LED34.4 (DIN)
unnamed: LED34.2 (DOUT), LED35.4 (DIN)
unnamed: LED35.2 (DOUT), LED36.4 (DIN)
unnamed: LED36.2 (DOUT), LED37.4 (DIN)
unnamed: LED37.2 (DOUT), LED38.4 (DIN)
unnamed: LED38.2 (DOUT), LED39.4 (DIN)
unnamed: LED39.2 (DOUT), LED40.4 (DIN)
unnamed: LED40.2 (DOUT), LED41.4 (DIN)
unnamed: LED41.2 (DOUT), LED42.4 (DIN)
unnamed: LED42.2 (DOUT), LED43.4 (DIN)
unnamed: LED43.2 (DOUT), LED44.4 (DIN)
unnamed: LED44.2 (DOUT), LED45.4 (DIN)
unnamed: LED45.2 (DOUT), LED46.4 (DIN)
unnamed: LED46.2 (DOUT), LED47.4 (DIN)
unnamed: LED47.2 (DOUT), LED48.4 (DIN)
unnamed: LED48.2 (DOUT), LED49.4 (DIN)
unnamed: LED49.2 (DOUT), LED50.4 (DIN)
unnamed: LED50.2 (DOUT), LED51.4 (DIN)
unnamed: LED51.2 (DOUT), LED52.4 (DIN)
unnamed: LED52.2 (DOUT), LED53.4 (DIN)
unnamed: LED53.2 (DOUT), LED54.4 (DIN)
unnamed: LED54.2 (DOUT), LED55.4 (DIN)
unnamed: LED55.2 (DOUT), LED56.4 (DIN)
unnamed: LED56.2 (DOUT), LED57.4 (DIN)
unnamed: LED57.2 (DOUT), LED58.4 (DIN)
unnamed: LED58.2 (DOUT), LED59.4 (DIN)
unnamed: LED59.2 (DOUT), LED60.4 (DIN)
unnamed: LED60.2 (DOUT), LED61.4 (DIN)
unnamed: LED61.2 (DOUT), LED62.4 (DIN)
unnamed: LED62.2 (DOUT), LED63.4 (DIN)
unnamed: LED63.2 (DOUT), LED64.4 (DIN)
unnamed: LED65.2 (DOUT), LED66.4 (DIN)
unnamed: LED66.2 (DOUT), LED67.4 (DIN)
unnamed: LED67.2 (DOUT), LED68.4 (DIN)
unnamed: LED68.2 (DOUT), LED69.4 (DIN)
unnamed: LED69.2 (DOUT), LED70.4 (DIN)
unnamed: LED70.2 (DOUT), LED71.4 (DIN)
unnamed: LED71.2 (DOUT), LED72.4 (DIN)
STRIP_DIN: LED65.4 (DIN)
