gwenrich136/farkle-scoreboard/src/farkle/test/mocks/include/ControlPad.h

#ifndef MOCK_CONTROL_PAD_H
#define MOCK_CONTROL_PAD_H

#include "Input.h"
#include <queue>

class ControlPad {
public:
    ControlPad() = default;

    void begin(); // Matches the real class

    // The real methods (can be no-ops for the mock)
    // Removed addButton as per real class change
    GameInput read();

    // Mock-specific method to simulate input
    void press(ButtonAction action);
    void rotate(int delta);
    void simulate(GameInput input);
    void setToggleState(ScoreDisplayMode mode);

private:
    std::queue<GameInput> input_queue;
    ScoreDisplayMode toggle_state = ScoreDisplayMode::BANKED;
};

#endif // MOCK_CONTROL_PAD_H
