gwenrich136/farkle-scoreboard/src/farkle/test/mocks/include/LedProgressGrid.h

#ifndef MOCK_LED_PROGRESS_GRID_H
#define MOCK_LED_PROGRESS_GRID_H

#include <vector>
#include <cstdint>
#include <optional>
#include "GameConstants.h"

class LedProgressGrid {
public:
    // Captured state for inspection by tests
    std::vector<int> captured_scores;
    int captured_currentPlayerIndex;
    int captured_blinkingScore;
    int player_count;
    bool was_cleared;
    bool was_reset;
    int captured_targetScore;


    LedProgressGrid(uint8_t pin);
    void begin();
    void setTargetScore(int target);
    int addPlayer(uint16_t hue);
    bool isMaxPlayersReached();
    void reset();
    void clear();
    void update(const int* scores, int playerCount, int currentPlayerIndex, int blinkingScore);
    void displayPlayersPregame(std::optional<uint16_t> pendingPlayerHue);
};

#endif // MOCK_LED_PROGRESS_GRID_H
