gwenrich136/farkle-scoreboard/(commit log)

2026-01-19 Add schematics
2026-01-19 Rename Mermaid Chart - Create complex, visual diagrams with text.-2026-01-19-071132.png to design/wiring.png
2026-01-19 Update and rename Schematic and Guide.md to wiring/Schematic and Guide.md
2026-01-19 Update Schematic and Guide.md
2026-01-19 Update and rename Schematic and Guide.md to Schematic and Guide.md
2026-01-27 Update control pad with all seven buttons to be used
2026-01-27 Rename the schematic to all caps for consistency of future docs
2026-01-27 Update schematic with proper buttons
2026-01-27 Add general game play design which works as a sort of PRD of the overall game flow
2026-02-01 Add simple v1, based on design docs.
    There are still some minor bugs we need to work through.
    [Displays.h, Game.cpp, Game.h]
2026-02-01 Implement Gamma Correction for LedProgressGrid remainder pixel
2026-02-01 Implement wait-for-dismissal in Banking and Farkling phases (Issue 4)
    - Modified BankingPhase to wait for button press after score transfer animation.
    - Modified FarklingPhase to wait for button press after score drain animation.
    - Ensured animation accumulators stop updating once atRiskScore reaches 0.
2026-02-02 refactor(ControlPad): use array instead of map for button storage
    Replaced the `std::map` in the `ControlPad` class with a fixed-size array of `ButtonMapping` structs.
    This change provides a more lightweight and memory-efficient solution for storing button configurations, which is better suited for the resource-constrained embedded environment.
    Key changes:
    - Replaced `std::map<int, ButtonAction>` with `ButtonMapping _buttonMap[16]`.
    - Added a `_buttonCount` member to track the number of configured buttons.
    - Included a bounds check in `addButton` to prevent buffer overflows.
    - Initialized `_lastAction` in the constructor to prevent undefined behavior.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
2026-02-02 feat: Add unit testing infrastructure
    This commit introduces a complete unit testing infrastructure for the Farkle Scoreboard project, enabling native testing of the game logic.
    Key changes include:
    - **PlatformIO Configuration:** Added a `native` environment to `platformio.ini` configured for unit testing with the Unity framework.
    - **Mock Hardware Layer:** Created a full suite of mock objects for all hardware-dependent components (`ControlPad`, `ScoreDisplay`, `LedProgressGrid`, etc.) to decouple the game logic from the hardware for testing.
    - **Unit Test Suite:** Implemented test cases for core game logic, including state transitions and score accumulation, in `test_transitions.cpp` and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
2026-02-02 refactor(ControlPad): implement pin-as-index array storage
    Refactored the `ControlPad` to use a direct pin-to-action mapping where the array index corresponds to the pin number. This is a cleaner and more efficient implementation that aligns with the feedback from the pull request.
    - Removed the `ButtonMapping` struct in favor of a simple `ButtonAction` array.
    - The `_buttonMap` array is now indexed directly by the pin number.
    - The constructor now initializes all possible pin actions to `NONE`.
    - The `read` method iterates up to `MAX_PINS` and checks for active buttons.
    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
2026-02-02 feat: Implement catastrophic farkle state
    Implements the logic for the catastrophic farkle event.
    - Adds a new `alternate()` method to the `FarkleWarningLights` component to support a non-blocking, alternating flash effect.
    - Updates the design documentation to reflect this new method.
    - Adds logic to the `FarklingPhase` to detect the third consecutive farkle and trigger the catastrophic event, which includes calling the new `alternate()` method and resetting the player's score to zero.
    This commit also begins to address code review feedback that pointed out an unnecessary refactoring of the `onEnter` method signature. The signature in the base `GamePhase.h` file has been reverted.
    Note: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
    [FarkleWarningLights.cpp, FarkleWarningLights.h, Game.cpp, GameState.h]
2026-02-02 feat: Implement Penalty Farkle State
    Adds a new `PenaltyFarklingPhase` to the game state machine to handle the 1000-point penalty for a third consecutive farkle.
    - Creates `PenaltyFarklingPhase` to deduct 1000 points and reset the player's farkle count.
    - Modifies `WaitingPhase` to track consecutive farkles and transition to the new penalty phase on the third farkle.
    - Refactors `FarklingPhase` to remove redundant farkle counting logic.
    - Adds comprehensive unit tests to verify the new penalty logic, including the reset of the farkle streak upon a successful bank.
    - Updates design documents to reflect the new game state and testing strategy.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
    [Game.h]
2026-02-02 refactor: Use PenaltyFarklePhase for catastrophic farkles
    Addresses code review feedback by refactoring the catastrophic farkle implementation to use a dedicated `PenaltyFarklePhase` instead of a boolean flag in `GameState`.
    - Creates the new `PenaltyFarklePhase` to manage the entire animation sequence, including flashing lights and a flashing score penalty.
    - Updates the `FarklingPhase` to transition to the new penalty phase upon the third consecutive farkle.
    - Enhances the `ScoreDisplay` component with a `clear_display` method to support the flashing score effect.
    - Reverts the unnecessary and wide-reaching refactoring of the `onEnter` method signature.
    - Updates mocks to ensure all nativ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
    [Game.cpp, Game.h, GameState.h]
2026-02-02 feat(game): Add failing test for negative score bug
    This commit introduces a new test case to reproduce a bug where a player's score can become negative after a third farkle penalty if their score is below 1000.
    The new test, `test_FullGame_TripleFarkle_ScoreLessThanPenalty`, simulates this exact scenario. The test currently fails by timing out, which confirms the presence of an infinite loop in the `PenaltyFarklingPhase` under these conditions.
    This commit also includes the resolution of several build and test configuration issues, primarily "multiple definition" linker errors caused by the project's test structure. The build system is now stable and correctly runs all tests.
    Co-authored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
2026-02-02 feat(game): Fix negative score bug and improve tests
    This commit fixes a bug where a player's score could become negative after a third farkle penalty if their score was less than 1000. The penalty is now correctly calculated as the minimum of 1000 or the player's current score.
    This commit also includes significant improvements to the test suite, based on feedback from the code review:
    - The `test_FullGame_TripleFarkle_ScoreLessThanPenalty` test case has been made more robust by simulating a player scoring 500 points, using the `CLEAR` button for dismissals, and adding more detailed assertions.
    - The `test_FullGame_StandardGame` has been improved to better simulate a real game.
    - The build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
2026-02-02 feat(game): Refactor test suite and add animation utility
    This commit refactors the test suite to improve clarity and maintainability, based on feedback from the code review.
    A new utility function, `waitForScoreAnimation`, has been created to encapsulate the logic for waiting for score animations to complete. This makes the tests cleaner and more readable. The `test_FullGame_TripleFarkle_ScoreLessThanPenalty` test case has been updated to use this new function.
2026-02-02 docs: Update testing strategy documentation
    - Renamed UNIT_TESTING_STRATEGY.md to TESTING_STRATEGY.md
    - Updated the document to reflect the current test structure
    - Added detailed descriptions for all existing tests
    - Included a reminder to keep the documentation up-to-date
2026-02-02 feat: Add alternate method to FarkleWarningLights
    Adds a new `alternate()` method to the `FarkleWarningLights` component to support a non-blocking, alternating flash effect for the catastrophic farkle event.
    - Implements a stateless, modulo-based timing logic in the `alternate()` method for robustness and simplicity.
    - Updates the `FarkleWarningLights` mock to include the new method.
    - Updates the `design/COMPONENT_LIBRARIES.md` document to reflect the new API.
    This change is limited to the component library and its documentation as per the user's request. All game logic changes have been reverted.
    [Game.h, ScoreDisplay.cpp, ScoreDisplay.h]
2026-02-02 feat: Use macro for ALTERNATE_INTERVAL to save memory
    Addresses code review feedback by changing the `const int ALTERNATE_INTERVAL` to a `#define` macro in `FarkleWarningLights.h`.
    This change optimizes memory usage on the resource-constrained Arduino platform by ensuring the value is a preprocessor constant rather than a variable stored in memory.
2026-02-02 refactor: Use CLEAR button for dismiss actions in tests
    Replaced all instances of `ButtonAction::BANK` with `ButtonAction::CLEAR` where the button's function is to dismiss a phase or advance the game state. This improves the semantic clarity of the tests.
    Also removed deprecated, duplicated test files from the root of the test directory and now exclusively use the tests located in the `small_tests`, `medium_tests`, and `large_tests` subdirectories.
2026-02-02 Optimize LedProgressGrid::illuminate_row loop
    Hoisted the invariant `_pixels.ColorHSV` calculation out of the `col` loop in `illuminate_row` to avoid redundant CPU operations. This reduces the overhead of color conversion for each pixel in a row.
    Verified by compiling for `uno_r4_wifi` target.
2026-02-02 Optimize ScoreDisplay: Remove heap allocation and add component tests
    - Replaced `std::string` with integer arithmetic in `ScoreDisplay::print_number`
    - Added `env:component_tests` to `platformio.ini` for isolated component testing
    - Added `test/test_component_tests/test_score_display.cpp` with benchmark
    - Added `test/mocks/libs/LedControl.h`
    - Updated `design/TESTING_STRATEGY.md`
2026-02-02 Optimize InGamePhase render loop allocations
    - Add `m_scores` member to `InGamePhase` to reuse memory.
    - Update `InGamePhase::display` to use `m_scores` instead of allocating a new vector every frame.
2026-02-03 feat: add blinking capability and overflow fix to ScoreDisplay
    - Added optional `blink` parameter to `ScoreDisplay::print_number`.
    - Implemented blinking logic by alternating intensity (4 and 10) every 500ms using `millis()`.
    - Updated overflow logic to cap at 99,999 as per documentation.
    - Updated `COMPONENT_LIBRARIES.md` and `TESTING_STRATEGY.md`.
    - Enhanced `LedControl` and `ScoreDisplay` mocks for testing.
    - Added component tests for blinking and overflow.
    - Corrected documentation regarding `std::string` usage in ScoreDisplay.
    [ScoreDisplay.cpp, ScoreDisplay.h]
2026-02-03 feat: implement enhanced penalty farkle logic and 'No Harm, No Foul' rule
    - Refactored `InGamePhase` to use virtual hooks for display logic, allowing selective overrides.
    - Implemented 'No Harm, No Foul' rule in `WaitingPhase` and `FarklingPhase`.
    - Enhanced `PenaltyFarklingPhase` with a three-stage dramatic animation:
    - THE_PAIN: 3-second delay with blinking score and alternating lights.
    - THE_DRAIN: Score animation with alternating lights.
    - THE_AFTERMATH: Wait for button press to advance.
    - Added `clear()` method to `ScoreDisplay` and updated mocks to support blinking.
    - Updated unit tests and design documentation (COMPONENT_LIBRARIES.md, TESTING_STRATEGY.md).
    - All 28 native unit t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
2026-02-03 feat(led-progress-grid): add state memory optimization and component tests
    - Implemented 'memory' pattern in LedProgressGrid to avoid redundant hardware updates.
    - Added DisplayMode enum and State struct for state tracking.
    - Implemented displayPlayersPregame with row mapping and blinking as per design.
    - Unified blinking frequency to 500ms on/off cycle.
    - Created component unit tests for LedProgressGrid.
    - Refactored component test directory structure to prevent linker collisions.
    - Created Adafruit_NeoPixel mock and updated Arduino mock.
    - Updated design documentation (COMPONENT_LIBRARIES.md, TESTING_STRATEGY.md).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
    [Arduino.cpp, Arduino.h, LedProgressGrid.cpp, LedProgressGrid.h]
2026-02-03 feat: enhanced penalty farkle and 'No Harm, No Foul' logic
    - Refactored `InGamePhase` to provide protected virtual hooks for display rendering (`updateScoreDisplays`, `updateProgressGrid`, `updateWarningLights`, `updateTextDisplay`).
    - Implemented the 'No Harm, No Foul' rule: players with 0 banked points do not increment their farkle count or trigger the penalty phase.
    - Enhanced `PenaltyFarklingPhase` with a dramatic three-stage animation:
    - THE_PAIN: 3-second delay with a blinking "-1000" score and alternating yellow/red warning lights.
    - THE_DRAIN: Smooth animation draining points from at-risk score back to banked score.
    - THE_AFTERMATH: Pause for user acknowledgement before advanci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
2026-02-03 refactor(led-progress-grid): encapsulate logic and remove magic numbers
    - Defined BLINK_HALF_PERIOD macro and unified blink logic.
    - Extracted row mapping into getRowMapping helper.
    - Extracted row rendering into renderPlayerRows helper.
    - Extracted hue selection into getPlayerHue helper.
    - Moved isDirty flag into State struct for cleaner refresh logic.
    - Updated AGENTS.md with coding standards for magic numbers and small methods.
    - Updated TESTING_STRATEGY.md with explanation for directory structure.
    - Updated COMPONENT_LIBRARIES.md to reflect State struct changes.
    - Verified all 34 tests pass.
2026-02-03 fix(led-progress-grid): address PR feedback and restore comments
    - Restored cubic polynomial explanation and max score design comments.
    - Removed unused totalPlayers argument from getPlayerHue.
    - Simplified ratio calculation in update() while following reviewer's suggestion.
    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
2026-02-03 refactor(led-progress-grid): eliminate magic numbers and fix docs
    - Added _targetScore field to replace 10,000 magic number.
    - Fixed numbering in AGENTS.md workflow section.
    - Ensured technical math comments are preserved.
    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
2026-02-03 feat: enhanced penalty farkle with blinking ScoreDisplay support
    - Refactored `InGamePhase` to use virtual hooks for display logic.
    - Enhanced `PenaltyFarklingPhase` with 3-stage animation:
    - Stage 1: THE_PAIN (3s delay) using the new `blink` parameter in `ScoreDisplay::print_number`.
    - Stage 2: THE_DRAIN (smooth score animation).
    - Stage 3: THE_AFTERMATH (wait for user input).
    - Updated native unit tests to verify 3-stage timing, blinking behavior, and 'No Harm, No Foul' logic.
    - All 30 tests passed in the native environment.
    - Documentation in COMPONENT_LIBRARIES.md was verified to match the implementation.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
2026-02-03 Optimize Player constructor with const ref
    Changed `Player` constructor to accept `const std::string&` instead of
    pass-by-value `std::string` to avoid unnecessary copies (double allocation)
    when passing lvalues.
    Benchmarks showed a ~2x speedup (reduction of ~365ms per 10M iterations)
    for `Player` instantiation.
    [GameState.h]
2026-02-04 refactor(led-progress-grid): resolve conflicts and finalize PR feedback
    - Resolved merge conflicts in TESTING_STRATEGY.md and test_score_display.cpp.
    - Incorporated upstream changes for ScoreDisplay blinking and overflow tests.
    - Re-synced component test subdirectory structure with upstream additions.
    - Verified all 35 tests (11 component, 24 native) pass.
    - Maintained targetScore implementation and coding standards (no magic numbers, small methods).
    [GameState.h, ScoreDisplay.cpp, ScoreDisplay.h]
2026-02-04 feat: enhance penalty farkle logic using blink parameter
    - Refactored `InGamePhase` with virtual hooks for display logic, improving extensibility.
    - Implemented 'No Harm, No Foul' rule in `WaitingPhase` and `FarklingPhase` to prevent unfair strikes for 0-score players.
    - Enhanced `PenaltyFarklingPhase` with a 3-stage sequence:
    - THE_PAIN: 3-second delay leveraging the new `blink` parameter in `ScoreDisplay::print_number`.
    - THE_DRAIN: Smoothed animation for score penalty subtraction.
    - THE_AFTERMATH: Turn advancement on user input.
    - Cleaned up duplicated warning light logic in `PenaltyFarklingPhase`.
    - Updated unit tests to verify 3-stage timing and 'No Harm, No Foul' logic, and renam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
2026-02-04 Update LedProgressGrid brightness curve to 4th-degree polynomial
    - Replaced cubic polynomial with 4th-degree polynomial ($2.7x^4 - 3.15x^3 + 1.2x^2 + 0.25x$) in `LedProgressGrid::getRemainderBrightness`.
    - Optimized implementation to calculate powers of x locally.
    - Updated documentation in `design/COMPONENT_LIBRARIES.md` to reflect the new curve and its properties ($y'(0)=0.25, y'(1)=4$).
2026-02-06 feat: conditionally display 0 atRiskScore and refactor ScoreDisplay API
    - Implement "Visual Feedback Rule": show 0 atRiskScore only in WaitingPhase; clear it in other phases.
    - Refactor `InGamePhase::updateScoreDisplays` into sub-hooks for better extensibility.
    - Update `ScoreDisplay` component to use `DisplayType` enum for addressing displays, decoupling logic from physical device indices.
    - Add `clear` method to `ScoreDisplay`.
    - Update `PenaltyFarklingPhase`, `PostGamePhase_V1`, and `Game` init to use the new API.
    - Update unit tests for `ScoreDisplay` and all relevant design documentation.
2026-02-06 feat: fix PenaltyFarklingPhase display logic and enhance tests
    - Address logic bug in `PenaltyFarklingPhase` where display showed '0' during animation; now it correctly stays empty (score <= 0).
    - Rename test file to `test_conditional_at_risk_display.cpp` for clarity.
    - Add assertion in `test_conditional_at_risk_display.cpp` to verify display is clear during "the pain" stage of `PenaltyFarklingPhase`.
    - Update `design/TESTING_STRATEGY.md` with the new test cases.
    - Re-verify all components and integration through local compilation.
2026-02-06 feat: fix PenaltyFarklingPhase display logic and improve tests
    - Overrode `updateAtRiskScoreDisplay` in `PenaltyFarklingPhase` to clear the display ONLY when `atRiskScore` is exactly 0. This ensures negative penalty scores are visible during animations.
    - Renamed test files to `test_conditional_at_risk_display.cpp/h` per reviewer request.
    - Added comprehensive assertions in `test_conditional_at_risk_display.cpp` to verify that `atRiskScore` is visible when negative in `PenaltyFarklingPhase` and cleared when it reaches 0.
    - Updated `design/TESTING_STRATEGY.md` with the new test case details.
    - Verified that all hooks and inheritance are correctly implemented.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
2026-02-06 Implement memory pattern in ScoreDisplay component
    - Added state tracking to ScoreDisplay to avoid redundant hardware calls.
    - Updated LedControl mock with call counters for verification.
    - Added test_ScoreDisplay_Optimization to verify hardware call skipping.
    - Documented changes in COMPONENT_LIBRARIES.md.
    - Reverted out-of-scope changes and ensured compatibility with existing tests.
    [ScoreDisplay.cpp, ScoreDisplay.h]
2026-02-06 feat: add memory/state pattern to ScoreDisplay for optimization
    - Implemented state tracking in ScoreDisplay component to avoid redundant hardware calls.
    - Documented changes in design/COMPONENT_LIBRARIES.md.
    - Maintained compatibility with existing tests by using plain enum for DisplayType in mocks.
    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
2026-02-06 feat: implement memory pattern in ScoreDisplay for hardware optimization
    - Added a `State` struct to track number, blink mode, and intensity for each display.
    - Implemented a private `setState` helper method to centralize state management.
    - Refactored `print_number` and `clear` to skip redundant hardware updates.
    - Updated `LedControl` mock with call counters to enable optimization verification.
    - Added `test_ScoreDisplay_HardwareInteractionOptimization` to verify the fix.
    - Restored `enum class DisplayType` for type safety and updated tests accordingly.
    - Added class-level and test-level documentation as per AGENTS.md.
    - Documented the optimization in design/COMPONENT_LIBRARIES.md.
    Co-aut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
    [ScoreDisplay.cpp, ScoreDisplay.h]
2026-02-06 Fix potential array index out of bounds in ScoreDisplay
    - Define NUM_DISPLAY_TYPES macro
    - Add isValidType helper with bounds check and Serial logging
    - Guard addDisplay, clear, print_number, and setState with isValidType
    - Add unit test for invalid type handling
2026-02-06 Fix out-of-bounds write in ControlPad::addButton
    - Added bounds check for `pin` in `ControlPad::addButton` to prevent OOB write.
    - Added unit tests for `ControlPad` in `src/farkle/test/test_component_control_pad`.
    - Extended `Arduino` mock with `pinMode`, `digitalRead` and pin state management.
    - Updated `platformio.ini` `component_tests` environment to include `ControlPad` tests.
    - Updated `design/TESTING_STRATEGY.md`.
    [Arduino.cpp, Arduino.h, test_control_pad.cpp]
2026-02-06 fix: enforce 8-player limit in LedProgressGrid
    Prevents heap exhaustion and out-of-bounds access by capping player count at 8.
    - Adds `#define MAX_PLAYERS 8` in LedProgressGrid.h
    - Updates `addPlayer` to return -1 on overflow
    - Adds `isMaxPlayersReached` helper
    - Updates `displayPlayersPregame` to prevent rendering pending player if full
    - Updates mocks and adds component test `test_LedProgressGrid_MaxPlayers`
    - Updates AGENTS.md with macro preference note
    [LedProgressGrid.cpp, LedProgressGrid.h]
2026-02-06 Refactor LedProgressGrid::State to use fixed-size array to prevent heap fragmentation
    - Replaced std::vector<int> in State with int scores[MAX_PLAYERS]
    - Updated operator== to perform element-wise comparison
    - Added defensive bounds checking and safety return in LedProgressGrid::update
    - Added test case test_LedProgressGrid_InsufficientScores to verify safety check
2026-02-10 feat(TextDisplay): Add printSelectionScreen method
    - Implemented printSelectionScreen in TextDisplay component
    - Added caching mechanism with DisplayMode enum
    - Added helper method drawArrow for visual indicators
    - Created mock libraries for U8g2lib and Wire to support component testing
    - Added comprehensive unit tests for TextDisplay
    - Updated platformio.ini to support component tests for TextDisplay
    - Updated Component Design Document
2026-02-10 doc(design): Restore future methods in COMPONENT_LIBRARIES.md
    - Reverted the deletion of unimplemented methods (scrolling, character input) in `design/COMPONENT_LIBRARIES.md` as they are future plans.
    - Replaced `displaySelector` with `printSelectionScreen` as implemented.
2026-02-10 Implement PreGame PlayerSelection Phase
    - Added `reset()` method to `GameState` to clear roster and flags.
    - Introduced `PreGamePhase` intermediate class for shared display management (clearing ScoreDisplay and FarkleLights by default).
    - Implemented `PlayerSelectionPhase` with a predefined name pool, navigation (UP_1000/DOWN_50), real-time filtering, and transition to `WaitingPhase`.
    - Updated `Game` engine to manage player addition and start in the selection phase.
    - Added comprehensive unit tests for `PlayerSelectionPhase`.
    - Refactored existing tests to use `setupGameWithPlayers` helper for bypassing the selection screen.
    - Verified all 66 tests (game logic and component) pass.
    Co-autho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
    [Game.cpp, Game.h, GamePhase.h, GameState.h]
2026-02-10 Implement PreGame PlayerSelection Phase
    - Created `PreGamePhase` base class to manage hardware state (clearing ScoreDisplay and FarkleLights) during pre-game phases.
    - Implemented `PlayerSelectionPhase` with navigation (UP_1000/DOWN_50), name pool filtering, and transition gating.
    - Updated `Game` class and `GameState` to support dynamic player addition and clean resets.
    - Added comprehensive unit tests for the new phase and updated existing integration tests.
    - Verified all tests pass (66/66).
2026-02-10 feat: Implement Interactive Player Selection Phase with PR Feedback
    - Introduced `PreGamePhase` intermediate class for shared hardware setup.
    - Implemented `PlayerSelectionPhase` with navigation, real-time filtering, and transition gating.
    - Added comprehensive unit and integration tests (including lifecycle and display logic).
    - Optimized performance by caching the available name list.
    - Incorporated PR feedback: selection index now "stays in place" after adding a player, and redundant UI logic for roster status was merged.
    - Adhered to `AGENTS.md` style guidelines (class block comments and test descriptions).
    - Verified all 68 tests pass.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
2026-02-10 feat: Finalize Player Selection Phase with PR Feedback
    - Implemented "stay-in-place" selection logic: adding a player now preserves the selection index (clamped to the new pool size) instead of resetting to zero.
    - Simplified "ROSTER FULL" UI: merged roster full and empty pool conditions into a single simple text print, avoiding the selection screen template.
    - Updated `design/TESTING_STRATEGY.md` to include all new tests and match final function names.
    - Optimized performance by making `m_availableNames` a persistent member variable, eliminating per-frame heap allocations.
    - Added project-standard block comments and test descriptions across all new files.
    - Verified all 68 tests (40 game lo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
2026-02-10 feat: Finalize Player Selection Phase with all PR feedback
    - Implemented "stay-in-place" selection logic with wrapping: adding a player now keeps the selection index on the next available name, or wraps to 0 if the last name was added.
    - Merged "ROSTER FULL" and pool-empty logic into a simple OLED print to clean up the UI and terminal state code.
    - Added `test_PlayerSelection_AddLastPlayerWraps` unit test and updated `design/TESTING_STRATEGY.md` accordingly.
    - Optimized hot loop performance by caching the filtered name pool in a persistent member variable.
    - Fully adhered to `AGENTS.md` style standards with comprehensive block comments and test case documentation.
    - Verified all 69 tests pas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
2026-02-11 fix(TextDisplay): implement deterministic layout to resolve OLED jitter
2026-02-11 ⚡ Optimize InGamePhase score vector population
    Introduced `GameState::scoresVersion` and `InGamePhase::m_lastScoresVersion` to track changes in player scores. Updated `InGamePhase::updateProgressGrid` to only repopulate the `m_scores` vector when scores have actually changed or the player count differs.
    Benchmarks showed a ~3.26x speedup (0.013s vs 0.043s for 100k iterations) for the targeted function.
2026-02-11 Implement software debouncing in ControlPad component
    Added per-pin timing logic to the ControlPad to filter out hardware
    button bouncing. A 50ms stable state is now required before a button
    press or release is registered. Updated unit tests to account for the
    debounce delay.
2026-02-13 docs: add capacitor stabilization strategy to address I2C noise (Issue #80)
2026-02-13 Implement Target Score Selection Phase
    - Added `TargetScoreSelectionPhase` as the initial game phase, allowing users to set the game goal between 1,000 and 20,000.
    - Updated `LedProgressGrid` component with `setTargetScore` to handle dynamic scaling of progress bars.
    - Updated `Game` context to manage phase transitions and target score synchronization across hardware.
    - Enhanced `PreGamePhase` to display the target score on the physical scoreboard during setup.
    - Verified all changes using native and component test suites.
    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
2026-02-13 Final submission of Target Score Selection Phase
    - Implemented TargetScoreSelectionPhase.
    - Updated LedProgressGrid for dynamic target scaling.
    - Updated Game context for phase synchronization.
    - Updated PreGamePhase for scoreboard target display.
    - Verified with unit and integration tests.
    - Documentation updated in design/ directory.
2026-02-13 Finalize Target Score Selection Phase with formatting
    - Added thousand-separator comma formatting to the target score display.
    - Resolved compiler warnings by increasing buffer size for formatted strings.
    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
2026-02-13 feat: make LED grid max score equal to the actual max score
    Modified LedProgressGrid to dynamically calculate its maximum scale as
    the maximum of the target score and the highest player potential score
    (including at-risk points). This removes the previous logic that
    jumped by 2000-point increments and allows the grid to shrink when
    the leading score decreases.
    - Updated LedProgressGrid::update logic.
    - Added getMaxScore() public getter for testing.
    - Added 3 new unit tests for exact scaling, at-risk inclusion, and shrinking.
    - Updated COMPONENT_LIBRARIES.md documentation.
2026-02-13 docs: update testing strategy with new LedProgressGrid tests
    - Added documentation for `test_LedProgressGrid_MaxScore_Exact`,
    `test_LedProgressGrid_MaxScore_IncludesAtRisk`, and
    `test_LedProgressGrid_MaxScore_Shrinking` in `design/TESTING_STRATEGY.md`.
    - Addresses PR feedback.
2026-02-13 feat: add blinking visual feedback for leading score in final round
    - Updated InGamePhase to pass finalRoundTriggered flag to ScoreDisplay
    - Updated PostGamePhase_V1 to flash the winning score
    - Updated design documents: GENERAL_GAME_PLAY.md, IN_GAME_PHASES.md, TECHNICAL_DESIGN_GAME_STATE_MACHINE.md, TESTING_STRATEGY.md
    - Updated AGENTS.md with new documentation rule
    - Added and verified test_FullGame_FinalRoundBlinking test case
2026-02-13 fix: implement cyclical tie-breaking procedure
    - Added `firstToReachTargetIndex` to `GameState` to track who triggered the final round.
    - Updated `BankingPhase` to record the trigger player index.
    - Updated `PostGamePhase_V1` to use a cyclical search starting from the trigger player to determine the winner in case of ties.
    - Added comprehensive unit tests for tie-breaking scenarios, including edge cases where a player other than Player 1 triggers the final round.
    - Verified all 86 test cases pass.
    [GameState.h]
2026-02-13 fix: simplify tie-breaking logic based on PR feedback
    - Removed redundant `firstToReachTargetIndex` from `GameState` and `BankingPhase`.
    - Simplified `PostGamePhase_V1` winner search to start from `currentPlayerIndex`.
    - Updated design documentation to reflect the simplified architecture.
    - Cleaned up test comments and verified all tests pass.
    [GameState.h]
2026-02-23 Fix potential out-of-bounds access in ScoreDisplay
    Clamped negative numbers to -9999 to fit within the 5-digit display limit.
    Added bounds check in the rendering loop to prevent invalid index access.
    Added unit test verifying the fix and ensuring no negative indices are accessed.
2026-02-23 Replace std::vector with fixed-size arrays in LedProgressGrid
    Replaces the `std::vector<uint16_t> _playerHues` with a fixed-size array `uint16_t _playerHues[MAX_PLAYERS]` to avoid dynamic memory allocation, adhering to embedded systems best practices.
    Refactors `LedProgressGrid::update` to accept `const int* scores` and `int playerCount` instead of `std::vector<int>`, removing the `<vector>` dependency from the component header.
    Updates `InGamePhase`, `PostGamePhase_V1`, mocks, and unit tests to align with the new API signature.
    [LedProgressGrid.cpp, LedProgressGrid.h]
2026-02-23 Implement 8-LED Status Strip for FarkleWarningLights
    - Extract shared `PlayerLayout` logic for `LedProgressGrid` and `FarkleWarningLights`.
    - Update `FarkleWarningLights` to use 8-LED NeoPixel strip on Pin A1.
    - Implement visual logic: Active player blinks (White/Yellow/Red), Idle players solid dim.
    - Update `InGamePhase` to pass all players' farkle counts.
    - Add component tests and update native logic tests.
    - Update `platformio.ini` to support component testing.
    - Update `design/TESTING_STRATEGY.md`.
2026-02-23 Implement smooth Red/Yellow alternating light effect for catastrophic farkle
    - Updated `FarkleWarningLights::alternate` to use a 1000ms cycle with smooth transitions between Red (0) and Yellow (10922).
    - Added `playerCount` to `alternate` signature to support correct LED mapping.
    - Updated `PenaltyFarklingPhase` to pass player count.
    - Added `map()` implementation to `Arduino` mock.
    - Added comprehensive unit test `test_Alternate_SmoothTransition` to verify timing and color logic.
    - Updated `TESTING_STRATEGY.md` with new test case.
    [Arduino.cpp, Arduino.h, FarkleWarningLights.cpp, FarkleWarningLights.h]
2026-02-24 Refactor FarkleWarningLights: 50% global brightness, explicit blinking index, full bright pain animation.
    - Updated `FarkleWarningLights` API to accept `blinkingPlayerIndex`.
    - Reduced standard brightness to 50% (128).
    - Set `alternate` animation (pain) to use Full Brightness (255).
    - Configured `InGamePhase` to default to solid lights (-1 index).
    - Overridden `WaitingPhase` to enable blinking for current player.
    - Updated designs and tests to reflect these changes.
2026-02-24 Refactor FarkleWarningLights: 50% global brightness, explicit blinking index, full bright pain animation.
    - Refactored `test_farkle_warning_lights.cpp` to use descriptive constants for color values.
    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
2026-02-25 docs: align all design documents for Step 2 Parallel Input refactor
    This commit synchronizes the entire design/ directory with the Step 2 architecture, including:
    - Defining the GameInput (Hybrid) model in TECHNICAL_DESIGN_GAME_STATE_MACHINE.md.
    - Updating SCHEMATIC_AND_HARDWARE_GUIDE.md with the 50ms ADC stability and new Pin Map.
    - Propagating the new GamePhase::update(GameInput) signature across all phase designs.
    - Updating TESTING_STRATEGY.md with priority matrix and TDD requirements for Step 2.
2026-02-25 Refactor: Implement Hybrid Input & Parallel Architecture
    - Created `Input.h` with `GameInput` struct (action + rotationDelta).
    - Updated `ControlPad.cpp` to handle digital (Bank/Farkle), ADC ladder (scoring), and Encoder (rotation) inputs concurrently.
    - Implemented ISRs for encoder and stability checks (50ms) for ADC.
    - Updated all `GamePhase` subclasses to use `GameInput` and leverage rotation for navigation/scoring.
    - Updated test suite (native & component) to use `simulateRotation` and new scoring actions, removing legacy `UP_1000`/`DOWN_50` actions.
    - Added `MAX_SCORE` definition to `GameState.h`.
    [Arduino.cpp, Arduino.h, ControlPad.cpp, ControlPad.h]
2026-02-25 Refactor: Hybrid Input & Address Review Comments
    - Refactored ControlPad:
    - Renamed abbreviations (ISR -> InterruptHandler, ADC -> Analog).
    - Extracted hardware initialization to helper.
    - Cleaned up comments.
    - Updated WaitingPhase:
    - Removed rotation-based scoring (buttons only).
    - Removed clamping logic.
    - Tests:
    - Removed `simulateScore` helper.
    - Updated tests to use explicit button press loops.
    - Verified all logic with native and component tests.
    - General cleanup of legacy comments and code.
2026-02-25 Refactor MAX_PLAYERS to GameConstants.h
    - Created src/farkle/include/GameConstants.h as the single source of truth for MAX_PLAYERS (8).
    - Updated FarkleWarningLights, LedProgressGrid, and game phases to use the new constant.
    - Refactored PlayerSelectionPhase to check state.players.size() >= MAX_PLAYERS directly.
    - Updated design/TECHNICAL_DESIGN_GAME_STATE_MACHINE.md to document the new file.
    - Verified with native and component tests.
2026-02-25 feat: add support for simulating multiple button presses in test_utils
    - Updates `simulateButtonPress` in `test_utils.h` and `test_utils.cpp` to accept an optional `count` parameter.
    - This allows tests to simulate multiple presses in a single call, e.g., `simulateButtonPress(game, action, 6)`.
    - Adds a new verification test `src/farkle/test/test_game_logic/small_tests/test_multi_press.cpp` to ensure correct behavior.
    - Registers the new test in `test_main.cpp`.
    - Updates `design/TESTING_STRATEGY.md` with the new test case.
    - Verified by running all tests (`./run_tests.sh`), ensuring no regressions.
    Fixes #117
2026-02-25 feat: add support for simulating multiple button presses in test_utils and refactor tests
    - This allows tests to simulate multiple presses in a single call, e.g., `simulateButtonPress(game, action, 3)`.
    - Refactors existing tests in `test_full_game.cpp`, `test_WaitingPhase.cpp`, and `test_turn_lifecycle.cpp` to use the new `count` parameter for consecutive presses.
    - Updates `design/TESTING_STRATEGY.md` with the n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
2026-02-25 feat: add support for simulating multiple button presses in test_utils and refactor tests
    - Refactors existing tests in `test_full_game.cpp`, `test_WaitingPhase.cpp`, `test_turn_lifecycle.cpp`, and `test_PlayerSelectionPhase.cpp` to use the new `count` parameter for consecutive presses and loops.
    - Upda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
2026-03-23 refactor: stabilize Hybrid Input and optimize encoder sensitivity
    - Implemented ControlPad::begin() to ensure hardware initialization (pinMode, interrupts) happens after Arduino boot.
    - Resolved "Ghost Press" issues by moving initialization out of global constructor.
    - Implemented robust industry-standard quadrature state-machine for rotary encoder.
    - Added 4-pulse divisor and fractional pulse accumulator to match encoder sensitivity to physical clicks (detents).
    - Updated mocks and component tests to support the new begin() lifecycle and verified all tests pass.
    [ControlPad.cpp, ControlPad.h, Game.cpp, Serial.h, test_control_pad.cpp]
2026-03-23 refactor(LedProgressGrid): rename atRiskScore to blinkingScore
    Renamed the `atRiskScore` argument to `blinkingScore` in the
    `LedProgressGrid::update` method signature and its corresponding state
    struct. This decoupling divorces the component display logic from specific
    game rules (e.g. "at risk" concepts).
    Updated related parameters inside `LedProgressGrid.cpp`, its test mock,
    and associated test suite comments. Game logic inside `InGamePhase` remains
    unchanged, functionally making this a clean no-op for actual gameplay.
2026-03-23 feat: Refactor LedProgressGrid animations to only blink in WaitingPhase
2026-03-23 refactor: use SELECT button for pregame confirmation actions
    - Update `TargetScoreSelectionPhase` to use `ButtonAction::SELECT` instead of `BANK`/`FARKLE` to confirm the target score.
    - Update `PlayerSelectionPhase` to use `ButtonAction::SELECT` instead of `BANK` to add players to the game roster.
    - `FARKLE` continues to function as the start game button in `PlayerSelectionPhase`.
    - Update all corresponding unit tests and the `test_turn_lifecycle` to simulate the `SELECT` button.
    - Update `GENERAL_GAME_PLAY.md` and `PRE_GAME_PHASES.md` design documentation to reflect the new user interactions.
2026-03-23 feat: increase penalty pain stage duration to 5 seconds
    - Updated PAIN_DURATION to 5000ms in PenaltyFarklingPhase.cpp
    - Updated design docs (GENERAL_GAME_PLAY.md, TESTING_STRATEGY.md, IN_GAME_PHASES.md)
    - Updated unit, medium, and large tests to reflect the new duration
    - Verified all tests pass in native and component environments
2026-03-23 docs: synchronize testing strategy with existing tests
    Updated `design/TESTING_STRATEGY.md` to include tests that were present in the codebase but missing from the documentation. Also corrected the names of renamed or split tests to match their current implementations. All tests pass successfully.
2026-03-24 docs: finalize design and implementation plan for Step 3 (IPS LCD Upgrade)
    - Defined TextDisplayV2 library and mocks in COMPONENT_LIBRARIES.md.
    - Refactored color ownership (Hue) to GameState in TECHNICAL_DESIGN_GAME_STATE_MACHINE.md.
    - Updated pin mapping for shared Hardware SPI in SCHEMATIC_AND_HARDWARE_GUIDE.md.
    - Added color-coded UI feedback to PRE_GAME and IN_GAME_PHASES.md.
    - Created detailed STEP_3_IMPLEMENTATION_PLAN.md for upcoming migration.
2026-03-24 Refactor: Transfer color generation and ownership from LedProgressGrid to GameState
    - Add `uint16_t hue` to the `Player` struct (defaulted to 0 for mock backward compatibility).
    - Move hue generation logic with Golden Ratio approximation to `GameState::getNextPlayerHue()`.
    - Utilize `mutable std::optional<uint16_t> prospectiveFirstHue` to safely lazy-load random starting hues while preserving const-correctness.
    - Update `LedProgressGrid` to maintain an internal buffer of pre-calculated RGB `uint32_t` colors instead of recalculating HSV on every render.
    - Refactor `LedProgressGrid::displayPlayersPregame` to accept a `std::optional<uint16_t>` for a clean representation of the pending player hu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
    [Game.cpp, GameState.h, LedProgressGrid.cpp, LedProgressGrid.h]
2026-03-24 Refactor: Address PR Comments on Color Sovereignty Refactor
    - Convert magic numbers to descriptive macros `HUE_MAX_16BIT` and `HUE_GOLDEN_RATIO_JUMP` in GameState.h.
    - Revert LedProgressGrid's internal buffer back to `uint16_t` hues.
    - Remove RGB manual scaling logic (`scaleColorBrightness`) in favor of using `_pixels.ColorHSV` for dynamic brightness.
    - Update `LedProgressGrid::addPlayer(uint16_t hue)` to only accept the hue, using the internal `_playerCount` for indexing.
    - Update Game.cpp, PlayerSelectionPhase.cpp, and mock/tests to reflect the new component signatures.
    [Game.cpp, GameState.h, LedProgressGrid.cpp, LedProgressGrid.h]
2026-03-24 Docs: Update COMPONENT_LIBRARIES.md for LedProgressGrid API changes
    - Reflect `int addPlayer(uint16_t hue)` instead of `addPlayer()`.
    - Reflect `void displayPlayersPregame(std::optional<uint16_t> pendingPlayerHue)` instead of `bool isPlayerPending`.
2026-03-24 Docs: Document Color Sovereignty in PRE_GAME_PHASES.md
    - Detail `GameState`'s role in generating unique hues using Golden Ratio approximation.
    - Document `PlayerSelectionPhase`'s new behavior of querying `GameState` for a prospective `std::optional<uint16_t>` hue to preview on the `LedProgressGrid`.
2026-03-24 feat(ui): implement TextDisplayV2 component for 240x240 LCD
    Implemented `TextDisplayV2` as a standalone component using Adafruit_GFX
    and Adafruit_ST7789 libraries.
    Added support for translating hue to RGB565 and full parity with V1.
    Optimized render loop state caching by using bounded stack arrays and
    avoiding std::string, protecting Arduino heap memory. Added unit tests
    and mock structures to maintain 100% test coverage.
    [Arduino.cpp, Arduino.h, TextDisplayV2.cpp, TextDisplayV2.h]
2026-03-24 feat(ui): implement TextDisplayV2 component for 240x240 LCD
    and Adafruit_ST7789 libraries. Added support for translating hue to
    RGB565 and full parity with V1. Optimized render loop state caching by
    using bounded stack arrays and avoiding std::string, protecting Arduino
    heap memory. Added unit tests and mock structures to maintain 100% test
    coverage.
    Addressed PR review feedback regarding the HSV to RGB conversion logic.
    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
2026-03-24 feat: final hardware migration to TextDisplayV2
    - Swapped `TextDisplay` for `TextDisplayV2` in `Displays` struct and phase rendering logic
    - Updated SPI mapping for `ScoreDisplay` (MOSI: D11, SCK: D13, CS: D10)
    - Initialized `TextDisplayV2` with no-CS operation (CS: -1, DC: A5, RES: D7, BLK: D8)
    - Updated `PlayerSelectionPhase` to explicitly pass pending player hue to display
    - Replaced mocked `TextDisplay` references in unit tests with `TextDisplayV2`
    [Arduino.h, Displays.h, Game.cpp, Game.h, GamePhase.h]
2026-04-04 refactor(hardware): Migrate ScoreDisplay from LedControl to MD_MAX72XX to share hardware SPI
    - Replace `wayoda/LedControl` dependency with `majicdesigns/MD_MAX72XX`.
    - Refactor `ScoreDisplay` constructor to accept only `csPin` and utilize hardware SPI.
    - Implement a custom 7-segment character lookup table to write bytes via `setColumn` on MD_MAX72XX, preserving 7-segment functionality without dot-matrix font artifacts.
    - Create a reverse-translating `MD_MAX72XX` mock to allow existing `ScoreDisplay` component tests to pass completely unmodified.
    - Update `Game.cpp` to correctly instantiate `ScoreDisplay` with the CS pin on hardware SPI.
    - All 96 tests (component and game logic) executed and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
    [Game.cpp, ScoreDisplay.cpp, ScoreDisplay.h]
2026-04-04 refactor(hardware): Migrate ScoreDisplay to native SPI for 7-segment support
    - Replace bit-banging `wayoda/LedControl` dependency with native `<SPI.h>`.
    - Refactor `ScoreDisplay` constructor to accept only `csPin` and utilize hardware SPI to enable sharing MOSI/SCK lines with the TextDisplay.
    - Implement direct MAX7219 SPI transactions, properly managing daisy-chained displays and sending explicit 7-segment byte mappings. This avoids the bit-rotation and device-order bugs introduced by dot-matrix libraries.
    - Replace `LedControl` mocks with a highly accurate `SPI.h` mock that simulates the MAX7219 daisy-chain shift registers, ensuring all existing `ScoreDisplay` tests pass flawlessly.
    - All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
2026-04-05 fix(hardware): Update TextDisplayV2 CS pin to A4
    - Update `Game.cpp` to initialize `TextDisplayV2` with `A4` for the Chip Select (CS) pin instead of `-1` (no-CS).
    - All 96 tests cleanly re-run and passing.
    [Game.cpp]
2026-04-05 feat: enhance text display font size and color integration
    - Updated TextDisplayV2 to use FreeSans18pt7b for larger text.
    - Enhanced TextDisplayV2::print to optionally accept a hue parameter for colored text.
    - Updated InGamePhase to render the current player's name using their assigned hue.
    - Modified tests and mocks to reflect the new font and method signatures.
2026-04-06 docs(design): sync designs with migration step 3 implementation
    - Update ScoreDisplay to reflect hardware SPI directly (dropped LedControl).
    - Update TextDisplayV2 API signature to include hue support (`uint16_t hue`).
    - Add missing performance and security test cases for ScoreDisplay to TESTING_STRATEGY.md.
    - Add completely missing TextDisplayV2 component test cases to TESTING_STRATEGY.md.
    - Fix minor missing markdown formatting issues.
2026-04-06 Feature/text display player hue 2207781183903819754 (#143)
    * Update TextDisplayV2 selection arrows to be larger and thicker (#138)
    * 🎨 Use player hues for text display messages
    - Updated `PenaltyFarklingPhase` to print the catastrophic farkle message using the current player's hue.
    - Updated `PostGamePhase_V1` to print the winning message using the winning player's hue.
    ---------
2026-04-06 ✨ Introduce Head-to-Head display in WaitingPhase
    - Adds `printHeadToHeadScreen` to `TextDisplayV2` to split the screen into top (current player) and bottom (leader).
    - Includes rank ordinals (1st, 2nd, etc.) left-aligned to player names.
    - Updates `InGamePhase` to calculate and dispatch rank/ordinal info to the UI.
    - Imports `FreeSans12pt7b` font to mock libraries for testing.
    - Updates component library and in-game phase design documentation.
2026-04-06 ♻️ Refactor TextDisplayV2 name caching and update memory guidelines
    - Modifies `TextDisplayV2::printHeadToHeadScreen` to accept and cache `const std::string*` for player names instead of copying them into C-style arrays.
    - Updates `AGENTS.md` to explicitly advise against copying large strings for UI component state caches, recommending pointers to stable `std::string` objects (like those in `Player`) instead.
    - Passes all game logic and component tests with the new signature.
2026-04-06 feat: add leaderboard scrolling to competitor display
    Added the ability to scroll through the competitor leaderboard using the rotary encoder during the `WaitingPhase`.
    - Replaced dynamic rank calculation with precomputed `rankedPlayerIndices` populated on `WaitingPhase::onEnter`.
    - Scrolling the rotary encoder updates `currentCompetitorRank`, correctly skipping the current player's index.
    - Head-to-Head display uses the precomputed rankings to display the competitor and current player ranks.
    - Rotating the encoder during `EndOfTurnPhase` advances the turn early, allowing immediate scrolling.
    - Refactored `InGamePhase` to remove redundant calculation logic.
    - Updated general gameplay specs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
    [GamePhase.h, GameState.h]
2026-04-06 Hello! Jules here. I have implemented the Total Score Toggle switch for you. Here is a summary of the updates:
    - Added a physical latching switch on pin A3 to toggle the score view.
    - Updated `GameInput` and `GameState` to track `ScoreDisplayMode` (BANKED or PENDING).
    - Updated `InGamePhase` to conditionally display the player's score + atRiskScore if the toggle is set to PENDING.
    - Added comprehensive mock support for the new toggle.
    - Added small, medium, and large tests to verify display behaviors during static states and dynamic animations.
    - Updated `GENERAL_GAME_PLAY.md`, `IN_GAME_PHASES.md`, and `HARDWARE_UPGRADE_MIGRATION_PLAN.md` to document the new feature and mark step 5 as finish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
2026-04-08 📝 docs: Define PLUS_XXX Analog signal behavior in TESTING_STRATEGY.md
    Replaced generic PLUS_XXX with specific PLUS_50, PLUS_100, PLUS_500, or CLEAR (Analog) signals to correctly document priority matrix testing behavior.
2026-04-08 Optimize score array caching in render loops
    Converted dynamic `std::vector<int>` allocations inside the `InGamePhase` and `PostGamePhase_V1` loops to use a static stack-allocated array bounded by `MAX_PLAYERS`. This removes continuous dynamic heap allocations on every render frame. Bounds checks were strictly enforced.
2026-04-13 docs: Document 5V to 3.3V Logic Level Converter requirement for SD Card
    Updates the hardware migration plan and schematic guide to explicitly
    state that a Logic Level Converter is required on the SPI bus between
    the 5V Arduino Uno R4 WiFi and the 3.3V SD Card module to prevent
    permanent damage and data corruption.
2026-04-13 docs: Require 5V native SD Card module for data integrity
    state that an SD Card module natively supporting 5V logic must be used.
    The Arduino Uno R4 WiFi operates on 5V logic, and wiring bare 3.3V SD
    card modules directly to the SPI bus risks hardware damage or data
    corruption. Resistor voltage dividers are also contraindicated for
    high-speed SPI signals.
    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
2026-04-18 feat: Migrate ControlPad from analog ladder to 3-bit digital bus
    This commit deprecates the unreliable analog resistor ladder input
    in favor of a robust 3-bit binary digital bus using the exact
    same pins (A2, D6, D5).
    Changes:
    - Refactored `ControlPad.h` and `ControlPad.cpp` to remove analog logic
    and replace it with a 3-bit bitwise polling and 50ms debouncing strategy.
    - Updated `Input.h` `ButtonAction` enum to include a new `UNDO` state.
    - Updated `test_control_pad.cpp` and `FakeControlPad` mocks to accurately
    simulate and test the 3-bit bus logic.
    - Included the "Ghost Undo" mechanism (simultaneously pressing Bank + Clear
    yields 101/UNDO) inside `ControlPad.cpp`.
    - Rigorously updat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
    [Input.h, test_control_pad.cpp]
2026-04-18 docs: Refactor MemoryCard API for internal cursor state
    - Redesigned `MemoryCard` API to use an internal `currentIndex`
    cursor for list navigation.
    - Introduced non-circular boundary logic returning `""` for out
    of bounds navigation.
    - Updated player-related methods to enforce 'name' or 'player'
    in identifiers (`getNextPlayer`, `addName`, `deleteName`).
2026-04-18 docs: Document MemoryCard buffer management for full pools
    - Added `PLAYER_POOL_FULL` to `AddPlayerResult` enum.
    - Documented "Case A" buffer compaction logic to shift active
    players over `DELETED` slots to maintain sort order when full.
    - Documented "Case B" rejection logic when the pool is completely
    full of active players with no `DELETED` slots to reclaim.
2026-04-19 fix: do not skip current player in leaderboard scrolling
    Removes the logic from WaitingPhase::update that forced the competitor
    rank display to skip over the current player. Updates related tests and
    the IN_GAME_PHASES design document to reflect this change. Initial
    turn start behavior (defaulting to 2nd place if current player is 1st)
    is preserved.
2026-04-20 fix: seed PRNG with analog noise and millis in Game::setup()
    Addresses Insecure Randomness vulnerability by initializing the PRNG
    with entropy from floating analog pins and device uptime.
    Updated mock environment to support PRNG seeding verification.
    [Arduino.cpp, Arduino.h, Game.cpp]
2026-04-21 feat: introduce MemoryCard component MVP for player selection
    This commit introduces a minimal viable product (MVP) for the `MemoryCard`
    component, allowing the Farkle Scoreboard to store and maintain a persistent
    pool of players on an SD card.
    - `MemoryCard` now tracks a list of up to 50 players from `players.csv`,
    auto-populating defaults if the file is missing.
    - Players are dynamically loaded into RAM during `PlayerSelectionPhase` and
    sorted descending by frequency using an in-place insertion sort to maximize
    efficiency and adhere to embedded memory constraints.
    - Refactored `Player` and `GameState` to represent player names internally as
    fixed-size `char[13]` array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
2026-04-21 feat: address CR feedback for MemoryCard MVP and Player refactor
    Addresses CR feedback and finalizes the `MemoryCard` MVP logic with proper
    struct refactors, boundary checking, and state retention fixes.
    Key Changes:
    - **Refactored `Player` Data Structure**: Fully refactored `Player` inside `GameState`
    to utilize a fixed `char name[13]` rather than `std::string`, eliminating heap
    fragmentation concerns in Arduino. Updated all downstream dependencies, `TextDisplayV2`,
    and unit tests to properly utilize `const char*`.
    - **Refined Selection Boundary Logic**: Addressed a critical bug in `PlayerSelectionPhase`
    where edge-wrapping via `beginPlayerSelection()` inadvertently wiped `MemoryCa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
    [players.csv]
2026-05-03 fix: refactor MemoryCard and PlayerSelectionPhase UX and testing
    - Fix compilation issue with SD Arduino String mismatch
    - Cleaned up AI comments in MemoryCard.cpp and improved SD write atomicity
    - Refactored PlayerSelectionPhase to use memory-efficient pointers over copied buffers
    - Replaced wrap UI logic with dead-action bounds and fixed ADD PLAYER missing label
    - Fixed early-exit lazy init bug in PlayerSelectionPhase that swallowed initial FARKLE input
    - Added FakeMemoryCard mock for proper env:native double mocking architecture
    - Fixed multiple-definition unity linking bugs
    [Game.h, MemoryCard.cpp, MemoryCard.h]
2026-05-03 feat: add persistent game management (Phases 1-4)
    - Phase 1: MemoryCard game ID generation, active ID tracking, and
    partial game directory initialization. Integrated into
    PlayerSelectionPhase on game start.
    - Phase 2: ArduinoJson dependency added. Implemented writeGameMetadata()
    to serialize targetScore and player list (name + hue) into
    /partial/[ID]/meta.jsn at game start.
    - Phase 3: Added TurnRecord struct with 32-bit bit-packing utility.
    Implemented appendTurnRecord() to append 4-byte records to
    /partial/[ID]/journal.bin after each turn in EndOfTurnPhase.
    Added penaltyAppliedThisTurn flag to GameState.
    - Phase 4: Implemented finalizeGame() to decode journal.bin and write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
2026-05-05 fix(MemoryCard): resolve SD card persistence and 8.3 filename violations
    * Renamed `active_id.txt` to `curr_id.txt` across the entire codebase to fix a FAT32 8.3 filename constraint violation that prevented the active game ID from being written to physical hardware.
    * Added explicit `f.flush()` calls before `f.close()` in `MemoryCard` to ensure data buffers are physically written to the SD card before closing.
    * Reordered game initialization in `PlayerSelectionPhase` to write `curr_id.txt` last, ensuring an atomic "arm" only after metadata is durable.
    * Updated `MemoryCard` mock to track call order and added assertions to `test_PlayerSelection_TransitionValidation` to enforce this startup se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
    [Arduino.h, MemoryCard.cpp, MemoryCard.h]
2026-05-12 Refactor test setup flow
    - Refactored `setupGameWithPlayers` to directly build the test environment state rather than simulating hardware inputs, significantly reducing test runtimes.
    - Introduced `simulatePregameFlow` to perform the actual button presses required to go from boot up to the first waiting phase turn, preserving the pregame flow logic.
    - Updated large tests to use `simulatePregameFlow` while retaining the faster `setupGameWithPlayers` for the vast majority of small and medium logical tests.
2026-05-12 Refactor test setup flow and update testing docs
    - Added Section 8 to `TESTING_STRATEGY.md` codifying these setup patterns.
    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
2026-05-12 Add new StartupPhase as initial game entry point
    - Introduced `StartupPhase` which acts as the new first phase upon game boot.
    - It displays the title "Farkle!" and a static "New Game" option.
    - Configured to transition to `TargetScoreSelectionPhase` exclusively via the `SELECT` button, ignoring all other inputs.
    - Updated `Game.cpp`, `Game.h`, and state logic to wire this in as the default starting phase.
    - Added a full test suite for `StartupPhase` to verify initial state, transition logic, and input isolation.
    - Updated existing pre-game and full lifecycle tests to account for the new phase using a DRY helper utility.
    - Updated `PRE_GAME_PHASES.md` design documentation to reflect the new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
2026-05-16 fix: Enhance StartupPhase recovery error handling and refine tests
    - Updated `launchResumeGame` in `StartupPhase` to return `this` and seamlessly reset the UI state upon failure instead of jumping immediately to target score selection.
    - Removed premature `clearActiveGame` call from `launchStartNewGame`.
    - Cleaned up small tests and added a `setupGameFromHardcodedPartialGame` utility to the MemoryCard mock to more faithfully simulate the system integration boundary in the large test.
    [MemoryCard.cpp, MemoryCard.h]
2026-05-16 fix: Initialize LedProgressGrid and score displays on game resume
    - Implemented `resumeGameDisplays()` in `Game` class to reset the NeoPixel grid, set its target score, and register each player's assigned color hue upon game recovery.
    - Updated `StartupPhase::launchResumeGame` to invoke `resumeGameDisplays` before entering the in-game `WaitingPhase`.
    - Created `test_FullGame_ResumeActiveGame_GridInitialization` in large test suite to verify grid player count and target score restoration.
    - Updated `PRE_GAME_PHASES.md` and `TESTING_STRATEGY.md` to document the synchronization behavior and test cases.
    [Game.cpp, Game.h]
2026-05-26 feat: add SoundPlayer component for MVP banking sfx
    - Adds `SoundPlayer` component wrapping `DFRobotDFPlayerMini`.
    - Integrates `SoundPlayer` into the `Game` and `Displays` architecture.
    - Updates `BankingPhase` to trigger `SFX_BANKING` and stop it upon transition.
    - Adds component unit tests and logic test updates to verify functionality.
    - Updates documentation (`IN_GAME_PHASES.md`, `COMPONENT_LIBRARIES.md`, `TECHNICAL_DESIGN_GAME_STATE_MACHINE.md`, `SCHEMATIC_AND_HARDWARE_GUIDE.md`, `TESTING_STRATEGY.md`) to reflect the new subsystem architecture.
2026-06-17 fix: BankingPhase accessed private soundPlayer via UNIT_TEST backdoor
    BankingPhase.cpp was calling game.soundPlayer directly, which compiled
    in tests (where UNIT_TEST widens private members to public) but failed
    in the hardware build where no such macro is defined.
    Fix: add getSoundPlayer() public accessor on Game, mirroring the
    existing getMemoryCard() pattern. BankingPhase now calls
    game.getSoundPlayer() through the proper public API.
    Also fix SoundPlayer::play() using wrong DFPlayer method name
    playFromMP3Folder -> playMp3Folder (library's actual method name).
    [Game.h]
2026-06-18 feat: integrate sound effects and refactor onEnter signature for GamePhase
    - Refactored GamePhase::onEnter signature to accept Game& game along with GameState& state, allowing phases to trigger audio effects immediately upon entry without first-frame tracking flags.
    - Updated all concrete phase classes, the game loop execution phase transitions, and associated unit test cases to conform to the new onEnter(Game&, GameState&) signature.
    - Split the sound catalog into Game Sounds (0001–0099.mp3) and System Sounds (0100–0199.mp3) with direct enum-to-file number mappings on the DFPlayer SD card.
    - Implemented triggers for all specified sound effects: low/mid/high score clicks, banking, farkli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
2026-11-02 docs(pcb-design): resolve open questions Q1-Q10 and finalize single-PCB architecture
2026-11-05 Document full FarkleScorekeeper_v2 schematic component reference and ERC verification
2026-11-05 Add KiCad project under hardware/kicad/FarkleScorekeeper and update .gitignore
2026-11-05 Assign all footprints, serpentine 8x8 LED grid, bare EC11 encoder, and screw terminals
2026-11-07 Add verified JLCPCB/LCSC BOM (bom.csv) and complete 0603 capacitor footprints
2026-11-07 Update custom module footprints from reference diagrams and photos
2026-11-07 Verify DFPlayer Mini footprint, SD slot orientation, and THT BOM parts
